longle2718/signpost/software/apps/tests/erpc_test/README.md

1) follow the build instructions in the erpc submodule
2) run 

$erpcgen test_arithmetic.erpc
