longle2718/signpost/case/backplane_assembly.SLDASM

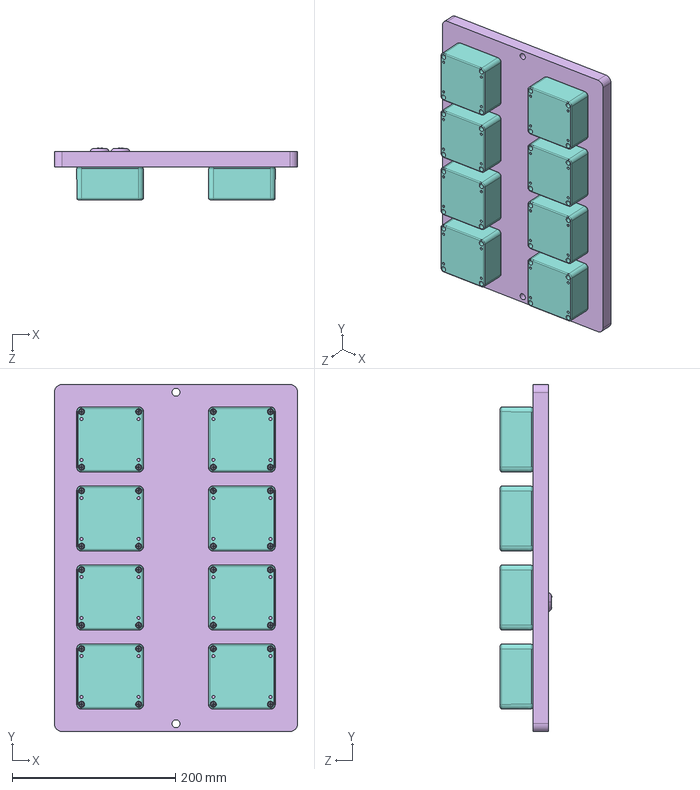
[picture p1: CAD file, 2017-03-07]
case/backplane_assembly.SLDASM
298.5 x 425.5 x 63.2 mm
back_panel
pcb
91772A107_18-8 SS PAN HEAD PHILLIPS MACHINE SCREW x 20
keystone_1892_0375_#4_standoff x 32
91772A106_18-8 SS PAN HEAD PHILLIPS MACHINE SCREW x 64
back_panel_cover
o_ring x 8
box_top x 8
96710A218_18-8 SS PAN HEAD TORX MACHINE SCREW x 32
91771A196_18-8 SS FLAT HEAD PHILLIPS MACHINE SCREW x 14
module_pcb x 8
back_panel_oring
C2058_QUILT_1 x 2
C2058_QUILT_2 x 2
