longle2718/signpost/case/back_panel_assem.SLDASM

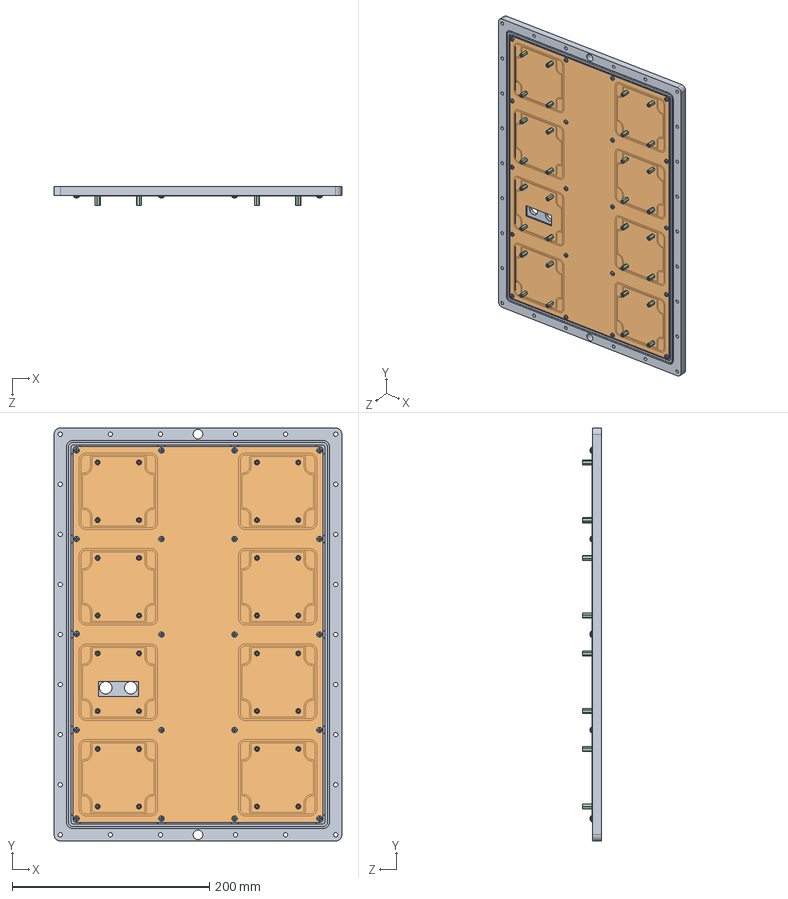
[picture p2: CAD file, 2017-03-07]
case/back_panel_assem.SLDASM
292.0 x 419.0 x 19.1 mm
back_panel
pcb
91772A107_18-8 SS PAN HEAD PHILLIPS MACHINE SCREW x 20
keystone_1892_0375_#4_standoff x 32
91772A106_18-8 SS PAN HEAD PHILLIPS MACHINE SCREW x 32
