longle2718/signpost/case/parts/back_panel.SLDPRT

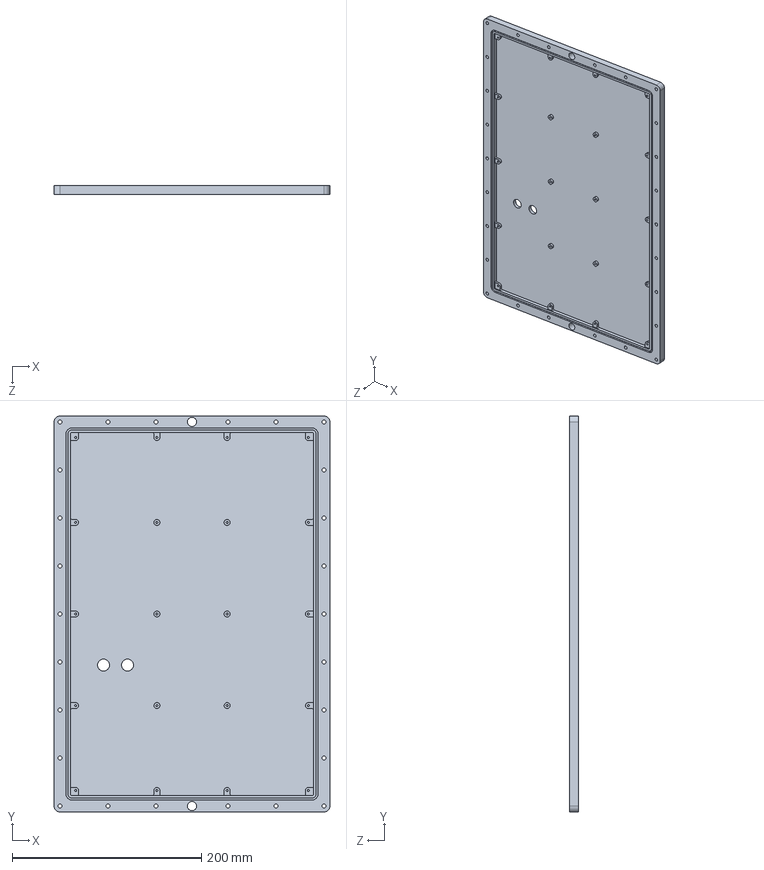
[picture p3: CAD file, 2017-03-07]
case/parts/back_panel.SLDPRT
292.0 x 419.0 x 9.14 mm
