longle2718/signpost/case/parts/back_panel_cover.SLDPRT

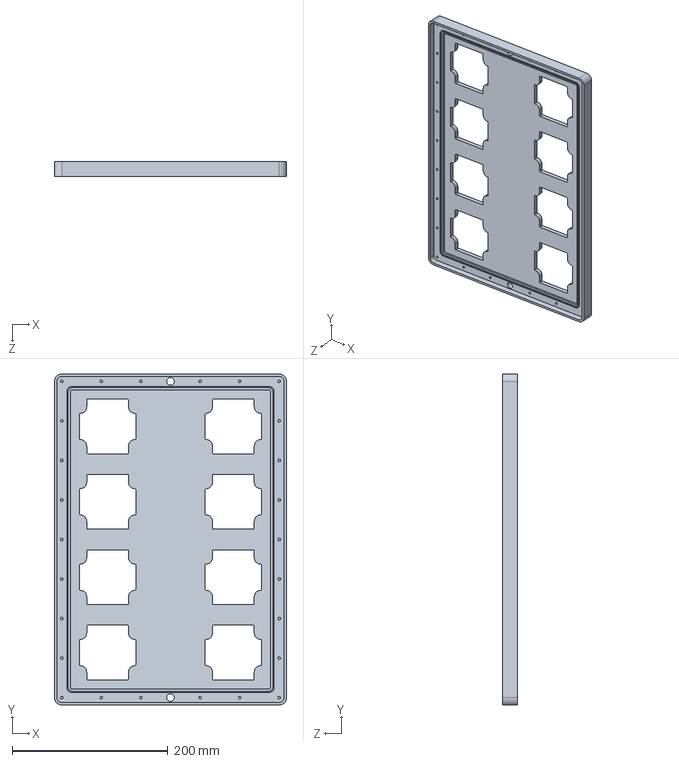
[picture p4: CAD file, 2017-03-07]
case/parts/back_panel_cover.SLDPRT
298.5 x 425.5 x 19.1 mm
