longle2718/signpost/case/parts/pcb.SLDPRT

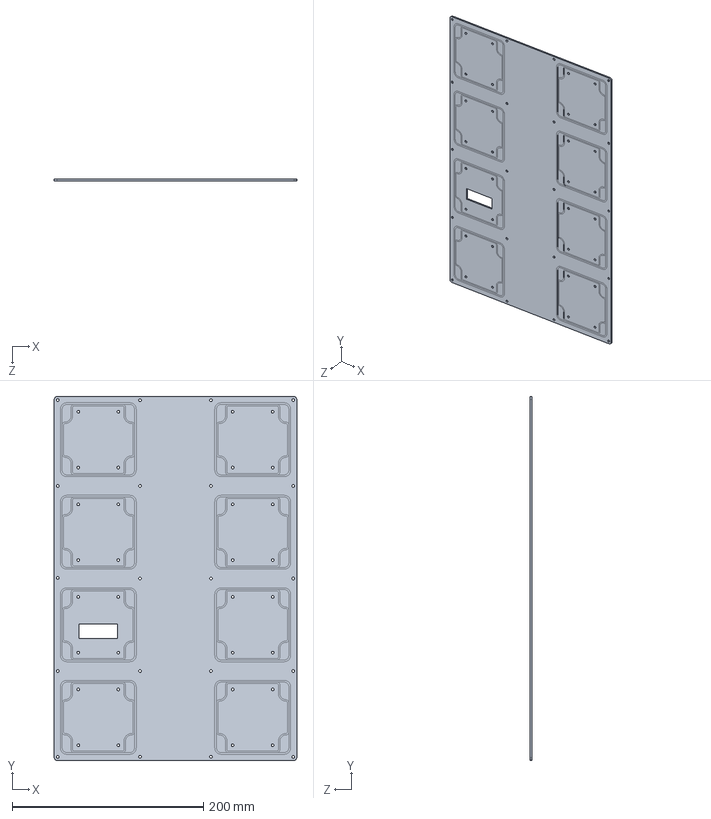
[picture p5: CAD file, 2017-03-07]
case/parts/pcb.SLDPRT
254.0 x 381.0 x 2.08 mm
