longle2718/signpost/hardware/backplane/rev_c/backplane.brd

## EAGLE design hardware/backplane/rev_c/backplane.brd (2017-03-07)

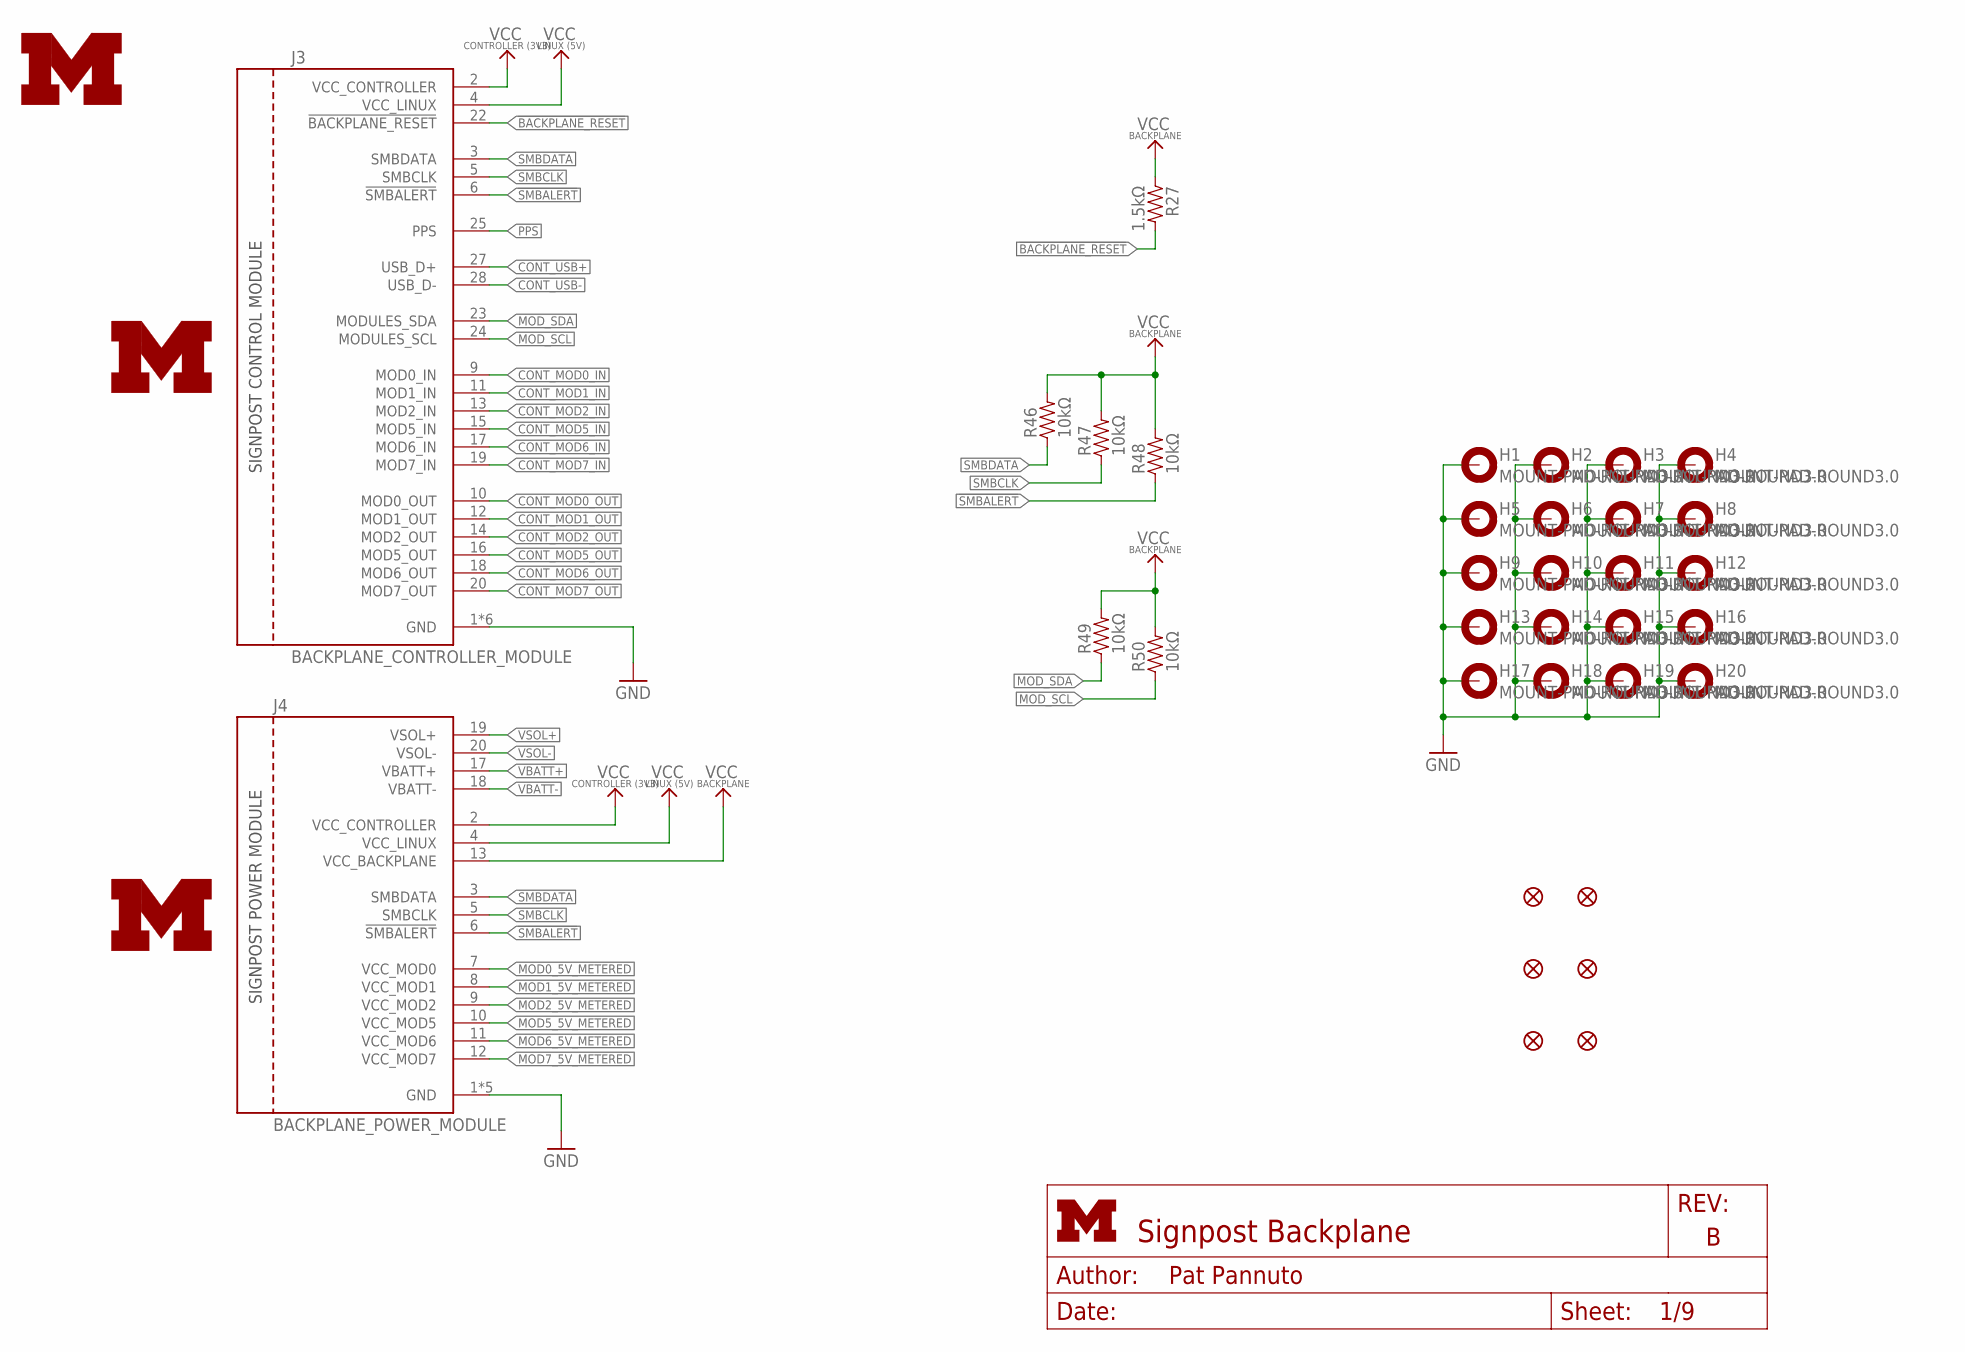
[picture p25: schematic backplane.sch, sheet 1]

Parts:
H1, H2, H3, H4, H5, H6, H7, H8, H9, H10, H11, H12, H13, H14, H15, H16, H17, H18, H19, H20: MOUNT-PAD-ROUND3.0; 3,0-PAD
J3: BACKPLANE_CONTROLLER_MODULE; BACKPLANE_MODULE_20PIN_10PIN
J4: BACKPLANE_POWER_MODULE; BACKPLANE_MODULE_20PIN
JP1, JP2, JP3, JP4, JP5, JP6: FIDUCIAL1X2; FIDUCIAL-1X2
LOGO1: UMICH_SOLID_GIANT; UMICH_SOLID_1000MIL
LOGO8, LOGO9: UMICH_SOLID_MEDIUM; UMICH_SOLID_200MIL
R27: 1.5kΩ; 0603-RES
R46, R47, R48, R49, R50: 10kΩ; 0603-RES

Connections:
!BACKPLANE_RESET: J3.22 (!BACKPLANE_RESET), R27.2; also elsewhere on the board
!SMBALERT: J3.6 (!SMBALERT), J4.6 (!SMBALERT), R48.1; also elsewhere on the board
CONT_MOD0_IN: J3.9 (MOD0_IN); also elsewhere on the board
CONT_MOD0_OUT: J3.10 (MOD0_OUT); also elsewhere on the board
CONT_MOD1_IN: J3.11 (MOD1_IN); also elsewhere on the board
CONT_MOD1_OUT: J3.12 (MOD1_OUT); also elsewhere on the board
CONT_MOD2_IN: J3.13 (MOD2_IN); also elsewhere on the board
CONT_MOD2_OUT: J3.14 (MOD2_OUT); also elsewhere on the board
CONT_MOD5_IN: J3.15 (MOD5_IN); also elsewhere on the board
CONT_MOD5_OUT: J3.16 (MOD5_OUT); also elsewhere on the board
CONT_MOD6_IN: J3.17 (MOD6_IN); also elsewhere on the board
CONT_MOD6_OUT: J3.18 (MOD6_OUT); also elsewhere on the board
CONT_MOD7_IN: J3.19 (MOD7_IN); also elsewhere on the board
CONT_MOD7_OUT: J3.20 (MOD7_OUT); also elsewhere on the board
CONT_USB+: J3.27 (USB_D+); also elsewhere on the board
CONT_USB-: J3.28 (USB_D-); also elsewhere on the board
GND: H1.B3,0, H2.B3,0, H3.B3,0, H4.B3,0, H5.B3,0, H6.B3,0, H7.B3,0, H8.B3,0, H9.B3,0, H10.B3,0, H11.B3,0, H12.B3,0, H13.B3,0, H14.B3,0, H15.B3,0, H16.B3,0, H17.B3,0, H18.B3,0, H19.B3,0, H20.B3,0, J3.1 (GND), J3.21 (GND), J3.MNT1 (GND), J3.MNT2 (GND), J3.MNT3 (GND), J3.MNT4 (GND), J4.1 (GND), J4.MNT1 (GND), J4.MNT2 (GND), J4.MNT3 (GND), J4.MNT4 (GND); also elsewhere on the board
MOD0_5V_METERED: J4.7 (VCC_MOD0); also elsewhere on the board
MOD1_5V_METERED: J4.8 (VCC_MOD1); also elsewhere on the board
MOD2_5V_METERED: J4.9 (VCC_MOD2); also elsewhere on the board
MOD5_5V_METERED: J4.10 (VCC_MOD5); also elsewhere on the board
MOD6_5V_METERED: J4.11 (VCC_MOD6); also elsewhere on the board
MOD7_5V_METERED: J4.12 (VCC_MOD7); also elsewhere on the board
MOD_SCL: J3.24 (MODULES_SCL), R50.1; also elsewhere on the board
MOD_SDA: J3.23 (MODULES_SDA), R49.1; also elsewhere on the board
PPS: J3.25 (PPS); also elsewhere on the board
SMBCLK: J3.5 (SMBCLK), J4.5 (SMBCLK), R47.1; also elsewhere on the board
SMBDATA: J3.3 (SMBDATA), J4.3 (SMBDATA), R46.1; also elsewhere on the board
VBATT+: J4.17 (VBATT+); also elsewhere on the board
VBATT-: J4.18 (VBATT-); also elsewhere on the board
VCC_BACKPLANE: J4.13 (VCC_BACKPLANE), R27.1, R46.2, R47.2, R48.2, R49.2, R50.2; also elsewhere on the board
VCC_CONTROLLER: J3.2 (VCC_CONTROLLER), J4.2 (VCC_CONTROLLER); also elsewhere on the board
VCC_LINUX: J3.4 (VCC_LINUX), J4.4 (VCC_LINUX); also elsewhere on the board
VSOL+: J4.19 (VSOL+); also elsewhere on the board
VSOL-: J4.20 (VSOL-); also elsewhere on the board

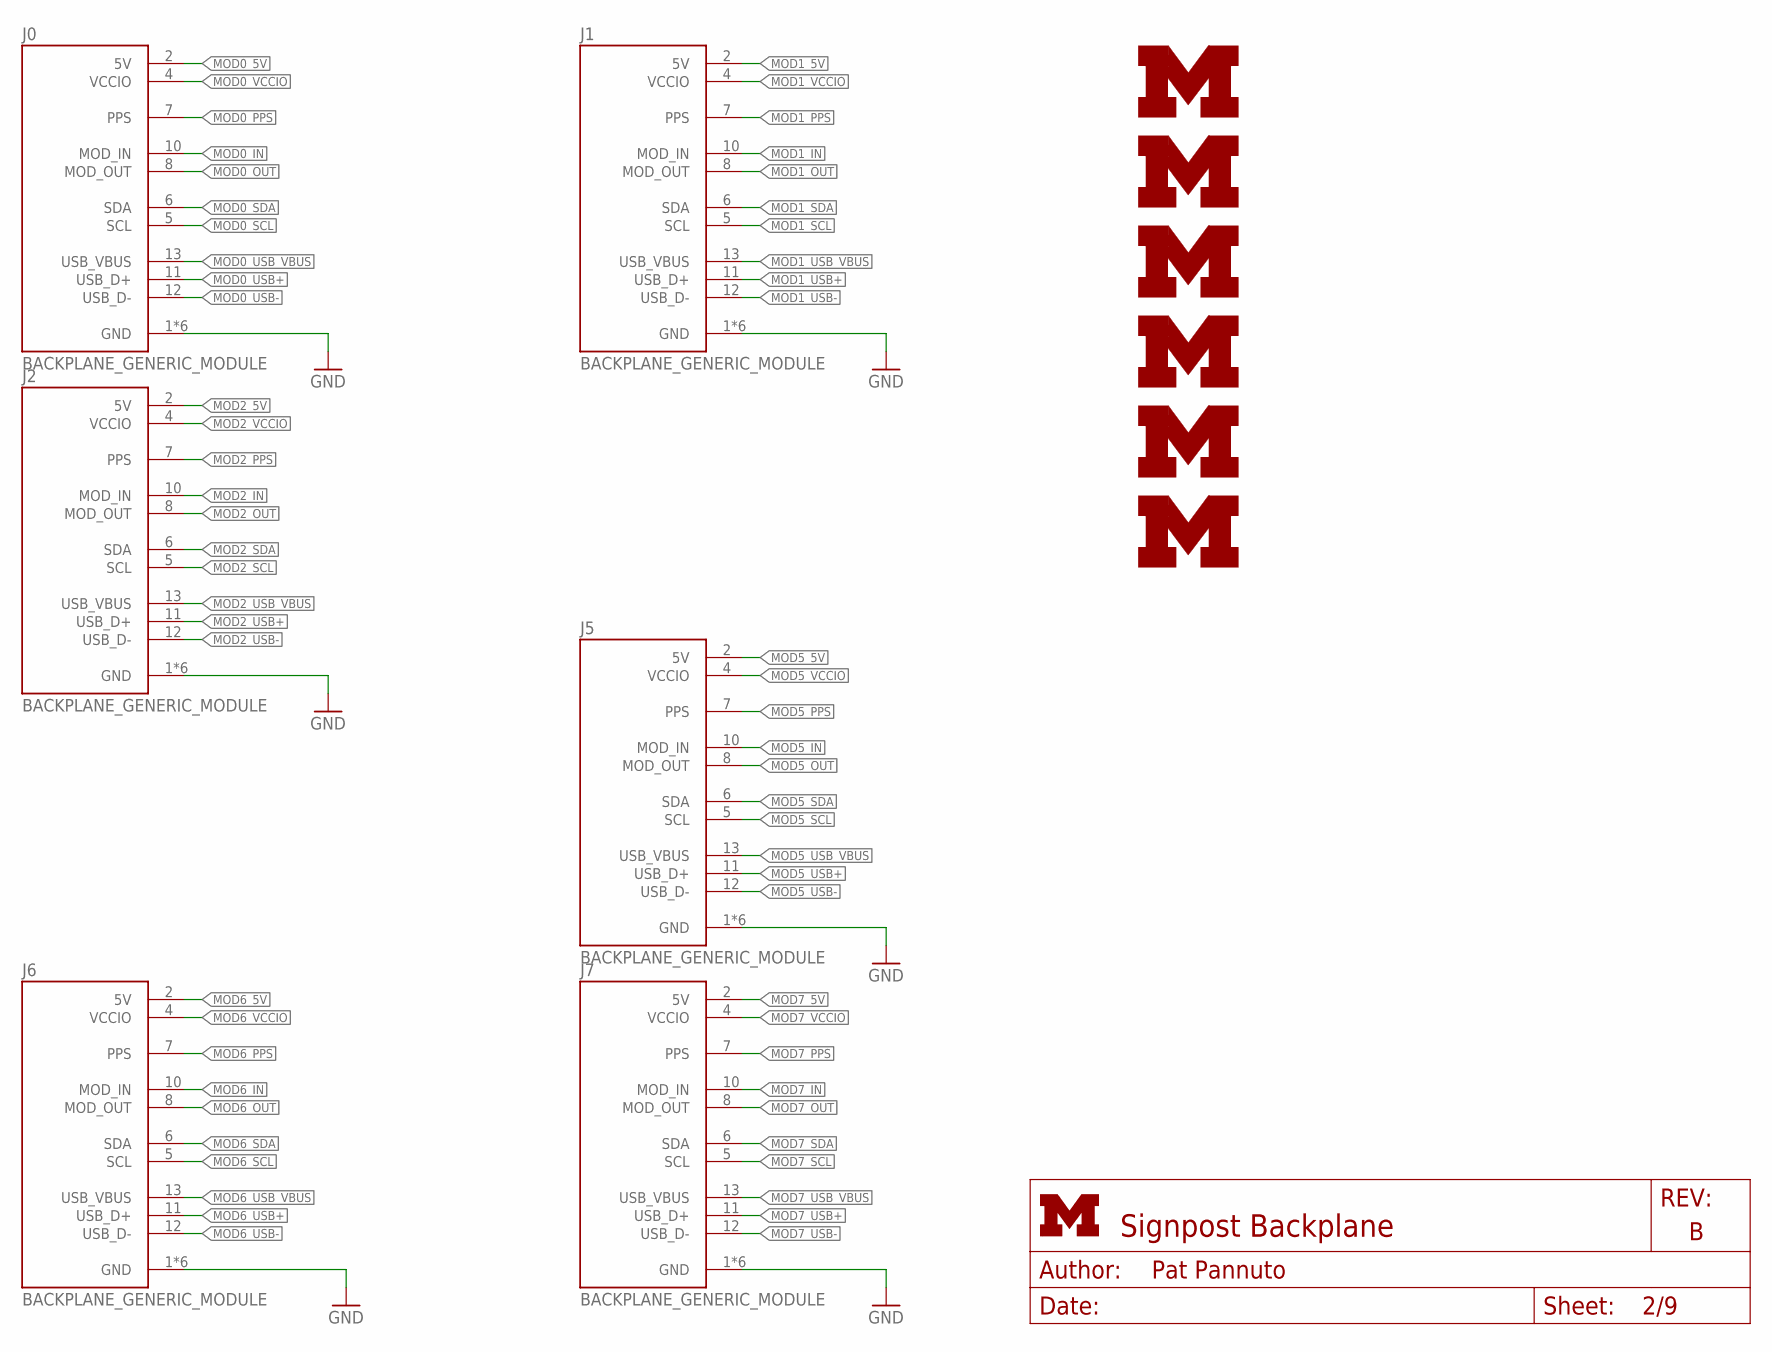
[picture p26: schematic backplane.sch, sheet 2]

Parts:
J0, J1, J2, J5, J6, J7: BACKPLANE_GENERIC_MODULE; BACKPLANE_MODULE_14PIN
LOGO2, LOGO3, LOGO4, LOGO5, LOGO6, LOGO7: UMICH_SOLID_MEDIUM; UMICH_SOLID_200MIL

Connections:
GND: J0.1 (GND), J0.14 (GND), J0.MNT1 (GND), J0.MNT2 (GND), J0.MNT3 (GND), J0.MNT4 (GND), J1.1 (GND), J1.14 (GND), J1.MNT1 (GND), J1.MNT2 (GND), J1.MNT3 (GND), J1.MNT4 (GND), J2.1 (GND), J2.14 (GND), J2.MNT1 (GND), J2.MNT2 (GND), J2.MNT3 (GND), J2.MNT4 (GND), J5.1 (GND), J5.14 (GND), J5.MNT1 (GND), J5.MNT2 (GND), J5.MNT3 (GND), J5.MNT4 (GND), J6.1 (GND), J6.14 (GND), J6.MNT1 (GND), J6.MNT2 (GND), J6.MNT3 (GND), J6.MNT4 (GND), J7.1 (GND), J7.14 (GND), J7.MNT1 (GND), J7.MNT2 (GND), J7.MNT3 (GND), J7.MNT4 (GND); also elsewhere on the board
MOD0_5V: J0.2 (5V); also elsewhere on the board
MOD0_IN: J0.10 (MOD_IN); also elsewhere on the board
MOD0_OUT: J0.8 (MOD_OUT); also elsewhere on the board
MOD0_PPS: J0.7 (PPS); also elsewhere on the board
MOD0_SCL: J0.5 (SCL); also elsewhere on the board
MOD0_SDA: J0.6 (SDA); also elsewhere on the board
MOD0_USB+: J0.11 (USB_D+); also elsewhere on the board
MOD0_USB-: J0.12 (USB_D-); also elsewhere on the board
MOD0_USB_VBUS: J0.13 (USB_VBUS); also elsewhere on the board
MOD0_VCCIO: J0.4 (VCCIO); also elsewhere on the board
MOD1_5V: J1.2 (5V); also elsewhere on the board
MOD1_IN: J1.10 (MOD_IN); also elsewhere on the board
MOD1_OUT: J1.8 (MOD_OUT); also elsewhere on the board
MOD1_PPS: J1.7 (PPS); also elsewhere on the board
MOD1_SCL: J1.5 (SCL); also elsewhere on the board
MOD1_SDA: J1.6 (SDA); also elsewhere on the board
MOD1_USB+: J1.11 (USB_D+); also elsewhere on the board
MOD1_USB-: J1.12 (USB_D-); also elsewhere on the board
MOD1_USB_VBUS: J1.13 (USB_VBUS); also elsewhere on the board
MOD1_VCCIO: J1.4 (VCCIO); also elsewhere on the board
MOD2_5V: J2.2 (5V); also elsewhere on the board
MOD2_IN: J2.10 (MOD_IN); also elsewhere on the board
MOD2_OUT: J2.8 (MOD_OUT); also elsewhere on the board
MOD2_PPS: J2.7 (PPS); also elsewhere on the board
MOD2_SCL: J2.5 (SCL); also elsewhere on the board
MOD2_SDA: J2.6 (SDA); also elsewhere on the board
MOD2_USB+: J2.11 (USB_D+); also elsewhere on the board
MOD2_USB-: J2.12 (USB_D-); also elsewhere on the board
MOD2_USB_VBUS: J2.13 (USB_VBUS); also elsewhere on the board
MOD2_VCCIO: J2.4 (VCCIO); also elsewhere on the board
MOD5_5V: J5.2 (5V); also elsewhere on the board
MOD5_IN: J5.10 (MOD_IN); also elsewhere on the board
MOD5_OUT: J5.8 (MOD_OUT); also elsewhere on the board
MOD5_PPS: J5.7 (PPS); also elsewhere on the board
MOD5_SCL: J5.5 (SCL); also elsewhere on the board
MOD5_SDA: J5.6 (SDA); also elsewhere on the board
MOD5_USB+: J5.11 (USB_D+); also elsewhere on the board
MOD5_USB-: J5.12 (USB_D-); also elsewhere on the board
MOD5_USB_VBUS: J5.13 (USB_VBUS); also elsewhere on the board
MOD5_VCCIO: J5.4 (VCCIO); also elsewhere on the board
MOD6_5V: J6.2 (5V); also elsewhere on the board
MOD6_IN: J6.10 (MOD_IN); also elsewhere on the board
MOD6_OUT: J6.8 (MOD_OUT); also elsewhere on the board
MOD6_PPS: J6.7 (PPS); also elsewhere on the board
MOD6_SCL: J6.5 (SCL); also elsewhere on the board
MOD6_SDA: J6.6 (SDA); also elsewhere on the board
MOD6_USB+: J6.11 (USB_D+); also elsewhere on the board
MOD6_USB-: J6.12 (USB_D-); also elsewhere on the board
MOD6_USB_VBUS: J6.13 (USB_VBUS); also elsewhere on the board
MOD6_VCCIO: J6.4 (VCCIO); also elsewhere on the board
MOD7_5V: J7.2 (5V); also elsewhere on the board
MOD7_IN: J7.10 (MOD_IN); also elsewhere on the board
MOD7_OUT: J7.8 (MOD_OUT); also elsewhere on the board
MOD7_PPS: J7.7 (PPS); also elsewhere on the board
MOD7_SCL: J7.5 (SCL); also elsewhere on the board
MOD7_SDA: J7.6 (SDA); also elsewhere on the board
MOD7_USB+: J7.11 (USB_D+); also elsewhere on the board
MOD7_USB-: J7.12 (USB_D-); also elsewhere on the board
MOD7_USB_VBUS: J7.13 (USB_VBUS); also elsewhere on the board
MOD7_VCCIO: J7.4 (VCCIO); also elsewhere on the board

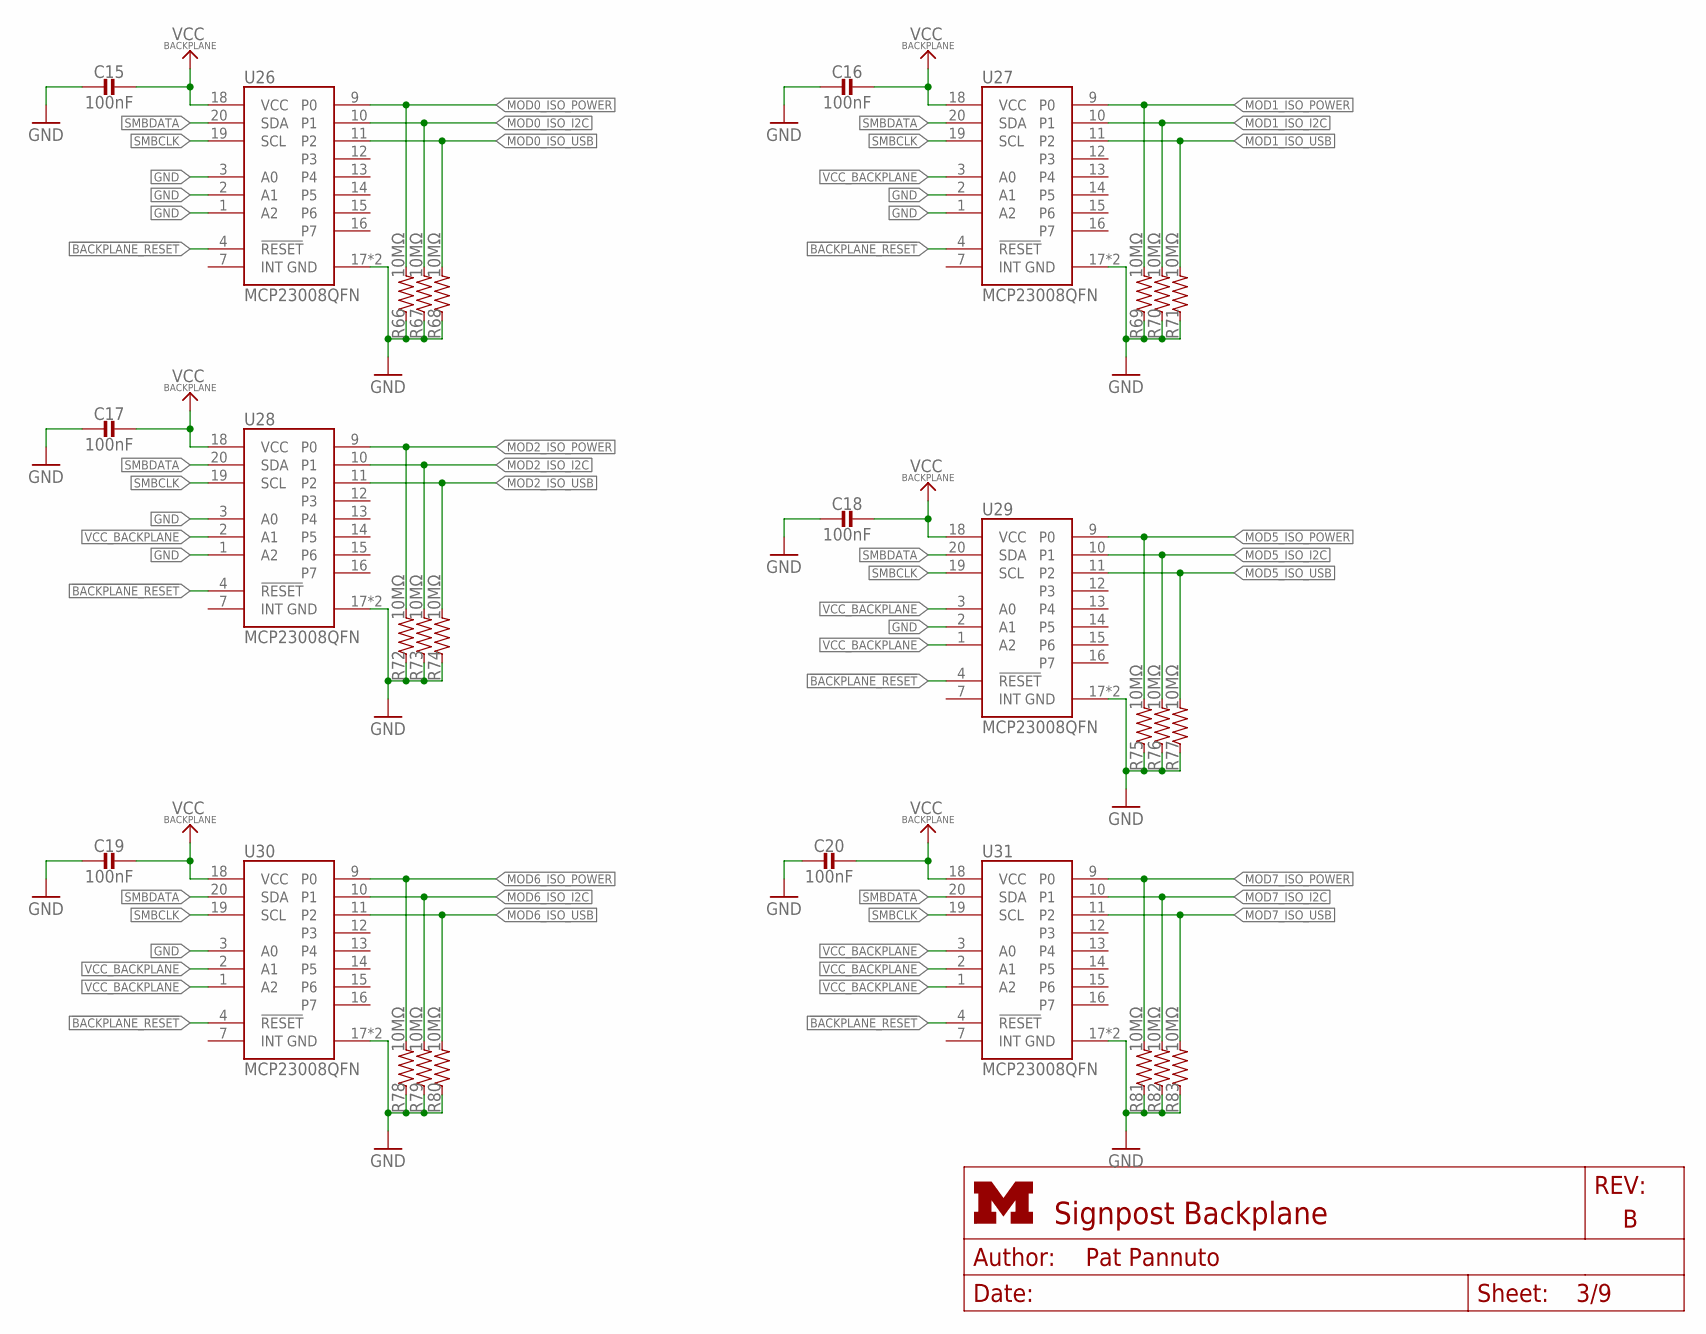
[picture p27: schematic backplane.sch, sheet 3]

Parts:
C15, C16, C17, C18, C19, C20: 100nF; 0603_CAP
R66, R67, R68, R69, R70, R71, R72, R73, R74, R75, R76, R77, R78, R79, R80, R81, R82, R83: 10MΩ; 0603-RES
U26, U27, U28, U29, U30, U31: MCP23008QFN; QFN-20-4MM

Connections:
!BACKPLANE_RESET: U26.4 (!RESET), U27.4 (!RESET), U28.4 (!RESET), U29.4 (!RESET), U30.4 (!RESET), U31.4 (!RESET); also elsewhere on the board
GND: C15.2, C16.2, C17.2, C18.2, C19.2, C20.2, R66.1, R67.1, R68.1, R69.1, R70.1, R71.1, R72.1, R73.1, R74.1, R75.1, R76.1, R77.1, R78.1, R79.1, R80.1, R81.1, R82.1, R83.1, U26.1 (A2), U26.2 (A1), U26.3 (A0), U26.17 (GND), U26.GND, U27.1 (A2), U27.2 (A1), U27.17 (GND), U27.GND, U28.1 (A2), U28.3 (A0), U28.17 (GND), U28.GND, U29.2 (A1), U29.17 (GND), U29.GND, U30.3 (A0), U30.17 (GND), U30.GND, U31.17 (GND), U31.GND; also elsewhere on the board
MOD0_ISO_I2C: R67.2, U26.10 (P1); also elsewhere on the board
MOD0_ISO_POWER: R66.2, U26.9 (P0); also elsewhere on the board
MOD0_ISO_USB: R68.2, U26.11 (P2); also elsewhere on the board
MOD1_ISO_I2C: R70.2, U27.10 (P1); also elsewhere on the board
MOD1_ISO_POWER: R69.2, U27.9 (P0); also elsewhere on the board
MOD1_ISO_USB: R71.2, U27.11 (P2); also elsewhere on the board
MOD2_ISO_I2C: R73.2, U28.10 (P1); also elsewhere on the board
MOD2_ISO_POWER: R72.2, U28.9 (P0); also elsewhere on the board
MOD2_ISO_USB: R74.2, U28.11 (P2); also elsewhere on the board
MOD5_ISO_I2C: R76.2, U29.10 (P1); also elsewhere on the board
MOD5_ISO_POWER: R75.2, U29.9 (P0); also elsewhere on the board
MOD5_ISO_USB: R77.2, U29.11 (P2); also elsewhere on the board
MOD6_ISO_I2C: R79.2, U30.10 (P1); also elsewhere on the board
MOD6_ISO_POWER: R78.2, U30.9 (P0); also elsewhere on the board
MOD6_ISO_USB: R80.2, U30.11 (P2); also elsewhere on the board
MOD7_ISO_I2C: R82.2, U31.10 (P1); also elsewhere on the board
MOD7_ISO_POWER: R81.2, U31.9 (P0); also elsewhere on the board
MOD7_ISO_USB: R83.2, U31.11 (P2); also elsewhere on the board
SMBCLK: U26.19 (SCL), U27.19 (SCL), U28.19 (SCL), U29.19 (SCL), U30.19 (SCL), U31.19 (SCL); also elsewhere on the board
SMBDATA: U26.20 (SDA), U27.20 (SDA), U28.20 (SDA), U29.20 (SDA), U30.20 (SDA), U31.20 (SDA); also elsewhere on the board
VCC_BACKPLANE: C15.1, C16.1, C17.1, C18.1, C19.1, C20.1, U26.18 (VCC), U27.3 (A0), U27.18 (VCC), U28.2 (A1), U28.18 (VCC), U29.1 (A2), U29.3 (A0), U29.18 (VCC), U30.1 (A2), U30.2 (A1), U30.18 (VCC), U31.1 (A2), U31.2 (A1), U31.3 (A0), U31.18 (VCC); also elsewhere on the board

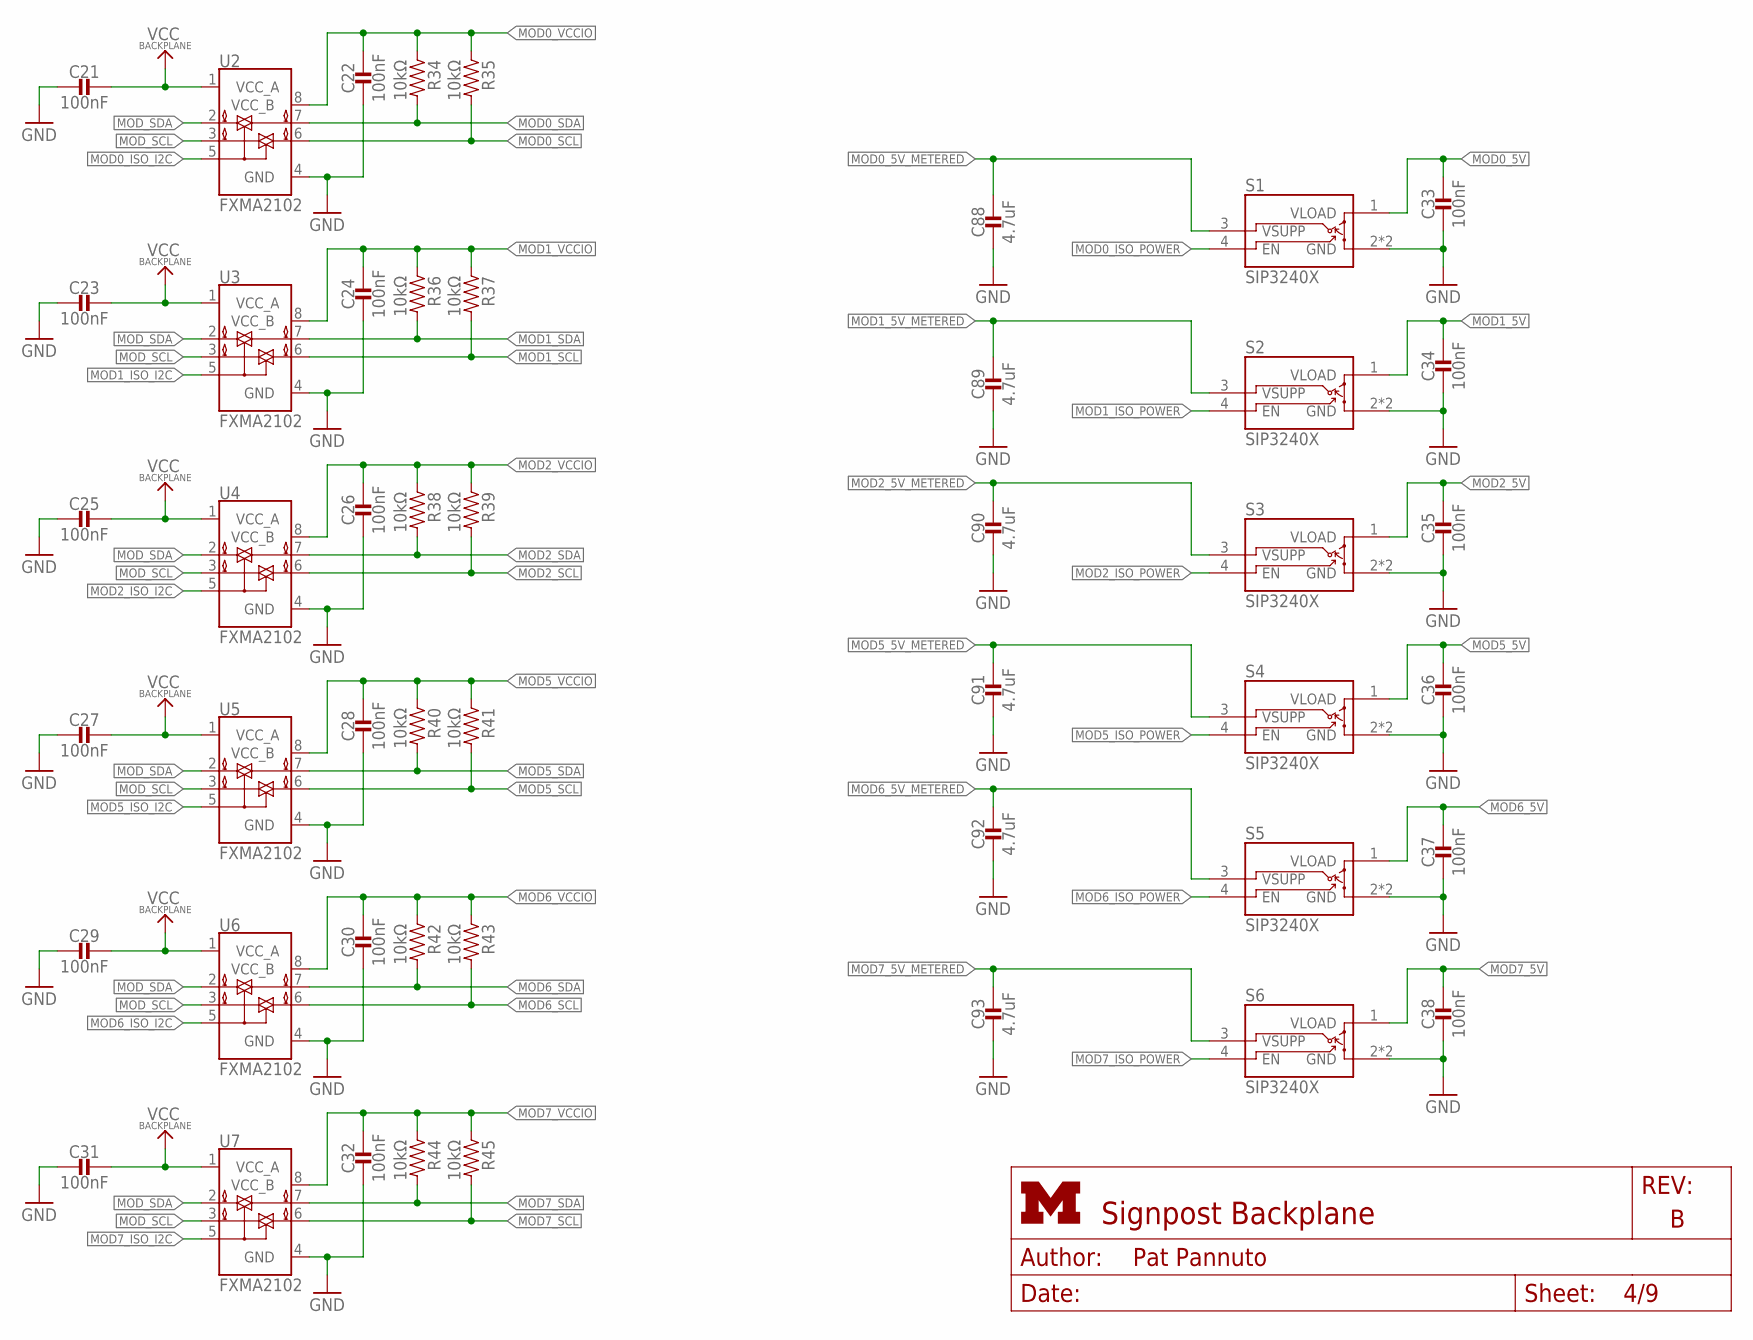
[picture p28: schematic backplane.sch, sheet 4]

Parts:
C21, C22, C23, C24, C25, C26, C27, C28, C29, C30, C31, C32, C33, C34, C35, C36, C37, C38: 100nF; 0603_CAP
C88, C89, C90, C91, C92, C93: 4.7uF; 0603_CAP
R34, R35, R36, R37, R38, R39, R40, R41, R42, R43, R44, R45: 10kΩ; 0603-RES
S1, S2, S3, S4, S5, S6: SIP3240X; TDFN4
U2, U3, U4, U5, U6, U7: FXMA2102; UMLP-8

Connections:
GND: C21.2, C22.2, C23.2, C24.2, C25.2, C26.2, C27.2, C28.2, C29.2, C30.2, C31.2, C32.2, C33.2, C34.2, C35.2, C36.2, C37.2, C38.2, C88.2, C89.2, C90.2, C91.2, C92.2, C93.2, S1.2 (GND), S1.PAD (GND), S2.2 (GND), S2.PAD (GND), S3.2 (GND), S3.PAD (GND), S4.2 (GND), S4.PAD (GND), S5.2 (GND), S5.PAD (GND), S6.2 (GND), S6.PAD (GND), U2.4 (GND), U3.4 (GND), U4.4 (GND), U5.4 (GND), U6.4 (GND), U7.4 (GND); also elsewhere on the board
MOD0_5V: C33.1, S1.1 (VLOAD); also elsewhere on the board
MOD0_5V_METERED: C88.1, S1.3 (VSUPP); also elsewhere on the board
MOD0_ISO_I2C: U2.5 (OE); also elsewhere on the board
MOD0_ISO_POWER: S1.4 (EN); also elsewhere on the board
MOD0_SCL: R35.2, U2.6 (B1); also elsewhere on the board
MOD0_SDA: R34.2, U2.7 (B0); also elsewhere on the board
MOD0_VCCIO: C22.1, R34.1, R35.1, U2.8 (VCC_B); also elsewhere on the board
MOD1_5V: C34.1, S2.1 (VLOAD); also elsewhere on the board
MOD1_5V_METERED: C89.1, S2.3 (VSUPP); also elsewhere on the board
MOD1_ISO_I2C: U3.5 (OE); also elsewhere on the board
MOD1_ISO_POWER: S2.4 (EN); also elsewhere on the board
MOD1_SCL: R37.2, U3.6 (B1); also elsewhere on the board
MOD1_SDA: R36.2, U3.7 (B0); also elsewhere on the board
MOD1_VCCIO: C24.1, R36.1, R37.1, U3.8 (VCC_B); also elsewhere on the board
MOD2_5V: C35.1, S3.1 (VLOAD); also elsewhere on the board
MOD2_5V_METERED: C90.1, S3.3 (VSUPP); also elsewhere on the board
MOD2_ISO_I2C: U4.5 (OE); also elsewhere on the board
MOD2_ISO_POWER: S3.4 (EN); also elsewhere on the board
MOD2_SCL: R39.2, U4.6 (B1); also elsewhere on the board
MOD2_SDA: R38.2, U4.7 (B0); also elsewhere on the board
MOD2_VCCIO: C26.1, R38.1, R39.1, U4.8 (VCC_B); also elsewhere on the board
MOD5_5V: C36.1, S4.1 (VLOAD); also elsewhere on the board
MOD5_5V_METERED: C91.1, S4.3 (VSUPP); also elsewhere on the board
MOD5_ISO_I2C: U5.5 (OE); also elsewhere on the board
MOD5_ISO_POWER: S4.4 (EN); also elsewhere on the board
MOD5_SCL: R41.2, U5.6 (B1); also elsewhere on the board
MOD5_SDA: R40.2, U5.7 (B0); also elsewhere on the board
MOD5_VCCIO: C28.1, R40.1, R41.1, U5.8 (VCC_B); also elsewhere on the board
MOD6_5V: C37.1, S5.1 (VLOAD); also elsewhere on the board
MOD6_5V_METERED: C92.1, S5.3 (VSUPP); also elsewhere on the board
MOD6_ISO_I2C: U6.5 (OE); also elsewhere on the board
MOD6_ISO_POWER: S5.4 (EN); also elsewhere on the board
MOD6_SCL: R43.2, U6.6 (B1); also elsewhere on the board
MOD6_SDA: R42.2, U6.7 (B0); also elsewhere on the board
MOD6_VCCIO: C30.1, R42.1, R43.1, U6.8 (VCC_B); also elsewhere on the board
MOD7_5V: C38.1, S6.1 (VLOAD); also elsewhere on the board
MOD7_5V_METERED: C93.1, S6.3 (VSUPP); also elsewhere on the board
MOD7_ISO_I2C: U7.5 (OE); also elsewhere on the board
MOD7_ISO_POWER: S6.4 (EN); also elsewhere on the board
MOD7_SCL: R45.2, U7.6 (B1); also elsewhere on the board
MOD7_SDA: R44.2, U7.7 (B0); also elsewhere on the board
MOD7_VCCIO: C32.1, R44.1, R45.1, U7.8 (VCC_B); also elsewhere on the board
MOD_SCL: U2.3 (A1), U3.3 (A1), U4.3 (A1), U5.3 (A1), U6.3 (A1), U7.3 (A1); also elsewhere on the board
MOD_SDA: U2.2 (A0), U3.2 (A0), U4.2 (A0), U5.2 (A0), U6.2 (A0), U7.2 (A0); also elsewhere on the board
VCC_BACKPLANE: C21.1, C23.1, C25.1, C27.1, C29.1, C31.1, U2.1 (VCC_A), U3.1 (VCC_A), U4.1 (VCC_A), U5.1 (VCC_A), U6.1 (VCC_A), U7.1 (VCC_A); also elsewhere on the board

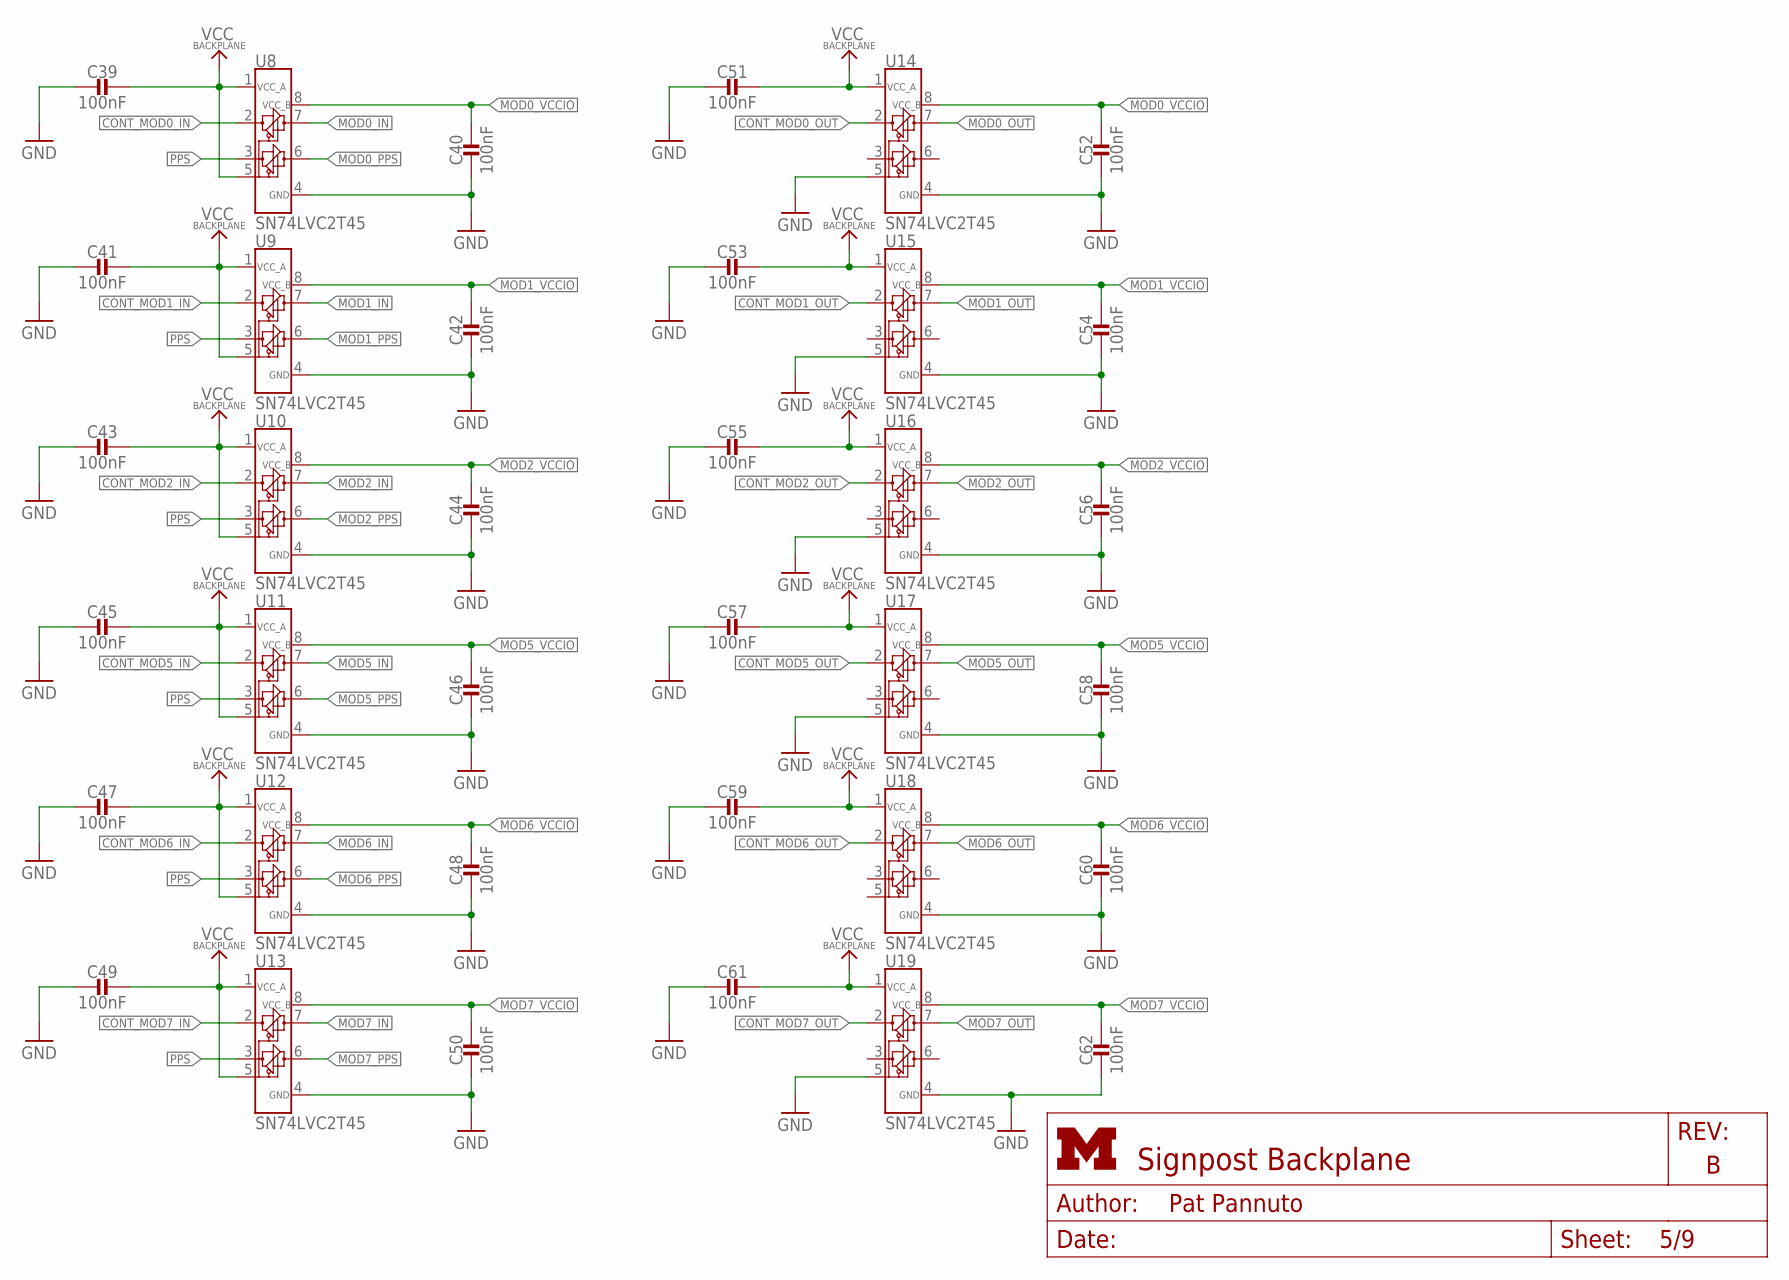
[picture p29: schematic backplane.sch, sheet 5]

Parts:
C39, C40, C41, C42, C43, C44, C45, C46, C47, C48, C49, C50, C51, C52, C53, C54, C55, C56, C57, C58, C59, C60, C61, C62: 100nF; 0603_CAP
U8, U9, U10, U11, U12, U13, U14, U15, U16, U17, U18, U19: SN74LVC2T45; VFSOP-8

Connections:
CONT_MOD0_IN: U8.2 (A1); also elsewhere on the board
CONT_MOD0_OUT: U14.2 (A1); also elsewhere on the board
CONT_MOD1_IN: U9.2 (A1); also elsewhere on the board
CONT_MOD1_OUT: U15.2 (A1); also elsewhere on the board
CONT_MOD2_IN: U10.2 (A1); also elsewhere on the board
CONT_MOD2_OUT: U16.2 (A1); also elsewhere on the board
CONT_MOD5_IN: U11.2 (A1); also elsewhere on the board
CONT_MOD5_OUT: U17.2 (A1); also elsewhere on the board
CONT_MOD6_IN: U12.2 (A1); also elsewhere on the board
CONT_MOD6_OUT: U18.2 (A1); also elsewhere on the board
CONT_MOD7_IN: U13.2 (A1); also elsewhere on the board
CONT_MOD7_OUT: U19.2 (A1); also elsewhere on the board
GND: C39.2, C40.2, C41.2, C42.2, C43.2, C44.2, C45.2, C46.2, C47.2, C48.2, C49.2, C50.2, C51.2, C52.2, C53.2, C54.2, C55.2, C56.2, C57.2, C58.2, C59.2, C60.2, C61.2, C62.2, U8.4 (GND), U9.4 (GND), U10.4 (GND), U11.4 (GND), U12.4 (GND), U13.4 (GND), U14.4 (GND), U14.5 (DIR), U15.4 (GND), U15.5 (DIR), U16.4 (GND), U16.5 (DIR), U17.4 (GND), U17.5 (DIR), U18.4 (GND), U19.4 (GND), U19.5 (DIR); also elsewhere on the board
MOD0_IN: U8.7 (B1); also elsewhere on the board
MOD0_OUT: U14.7 (B1); also elsewhere on the board
MOD0_PPS: U8.6 (B2); also elsewhere on the board
MOD0_VCCIO: C40.1, C52.1, U8.8 (VCC_B), U14.8 (VCC_B); also elsewhere on the board
MOD1_IN: U9.7 (B1); also elsewhere on the board
MOD1_OUT: U15.7 (B1); also elsewhere on the board
MOD1_PPS: U9.6 (B2); also elsewhere on the board
MOD1_VCCIO: C42.1, C54.1, U9.8 (VCC_B), U15.8 (VCC_B); also elsewhere on the board
MOD2_IN: U10.7 (B1); also elsewhere on the board
MOD2_OUT: U16.7 (B1); also elsewhere on the board
MOD2_PPS: U10.6 (B2); also elsewhere on the board
MOD2_VCCIO: C44.1, C56.1, U10.8 (VCC_B), U16.8 (VCC_B); also elsewhere on the board
MOD5_IN: U11.7 (B1); also elsewhere on the board
MOD5_OUT: U17.7 (B1); also elsewhere on the board
MOD5_PPS: U11.6 (B2); also elsewhere on the board
MOD5_VCCIO: C46.1, C58.1, U11.8 (VCC_B), U17.8 (VCC_B); also elsewhere on the board
MOD6_IN: U12.7 (B1); also elsewhere on the board
MOD6_OUT: U18.7 (B1); also elsewhere on the board
MOD6_PPS: U12.6 (B2); also elsewhere on the board
MOD6_VCCIO: C48.1, C60.1, U12.8 (VCC_B), U18.8 (VCC_B); also elsewhere on the board
MOD7_IN: U13.7 (B1); also elsewhere on the board
MOD7_OUT: U19.7 (B1); also elsewhere on the board
MOD7_PPS: U13.6 (B2); also elsewhere on the board
MOD7_VCCIO: C50.1, C62.1, U13.8 (VCC_B), U19.8 (VCC_B); also elsewhere on the board
PPS: U8.3 (A2), U9.3 (A2), U10.3 (A2), U11.3 (A2), U12.3 (A2), U13.3 (A2); also elsewhere on the board
VCC_BACKPLANE: C39.1, C41.1, C43.1, C45.1, C47.1, C49.1, C51.1, C53.1, C55.1, C57.1, C59.1, C61.1, U8.1 (VCC_A), U8.5 (DIR), U9.1 (VCC_A), U9.5 (DIR), U10.1 (VCC_A), U10.5 (DIR), U11.1 (VCC_A), U11.5 (DIR), U12.1 (VCC_A), U12.5 (DIR), U13.1 (VCC_A), U13.5 (DIR), U14.1 (VCC_A), U15.1 (VCC_A), U16.1 (VCC_A), U17.1 (VCC_A), U18.1 (VCC_A), U19.1 (VCC_A); also elsewhere on the board
