longle2718/signpost/hardware/backplane/rev_c/backplane.brd

## EAGLE design hardware/backplane/rev_c/backplane.brd (continued)

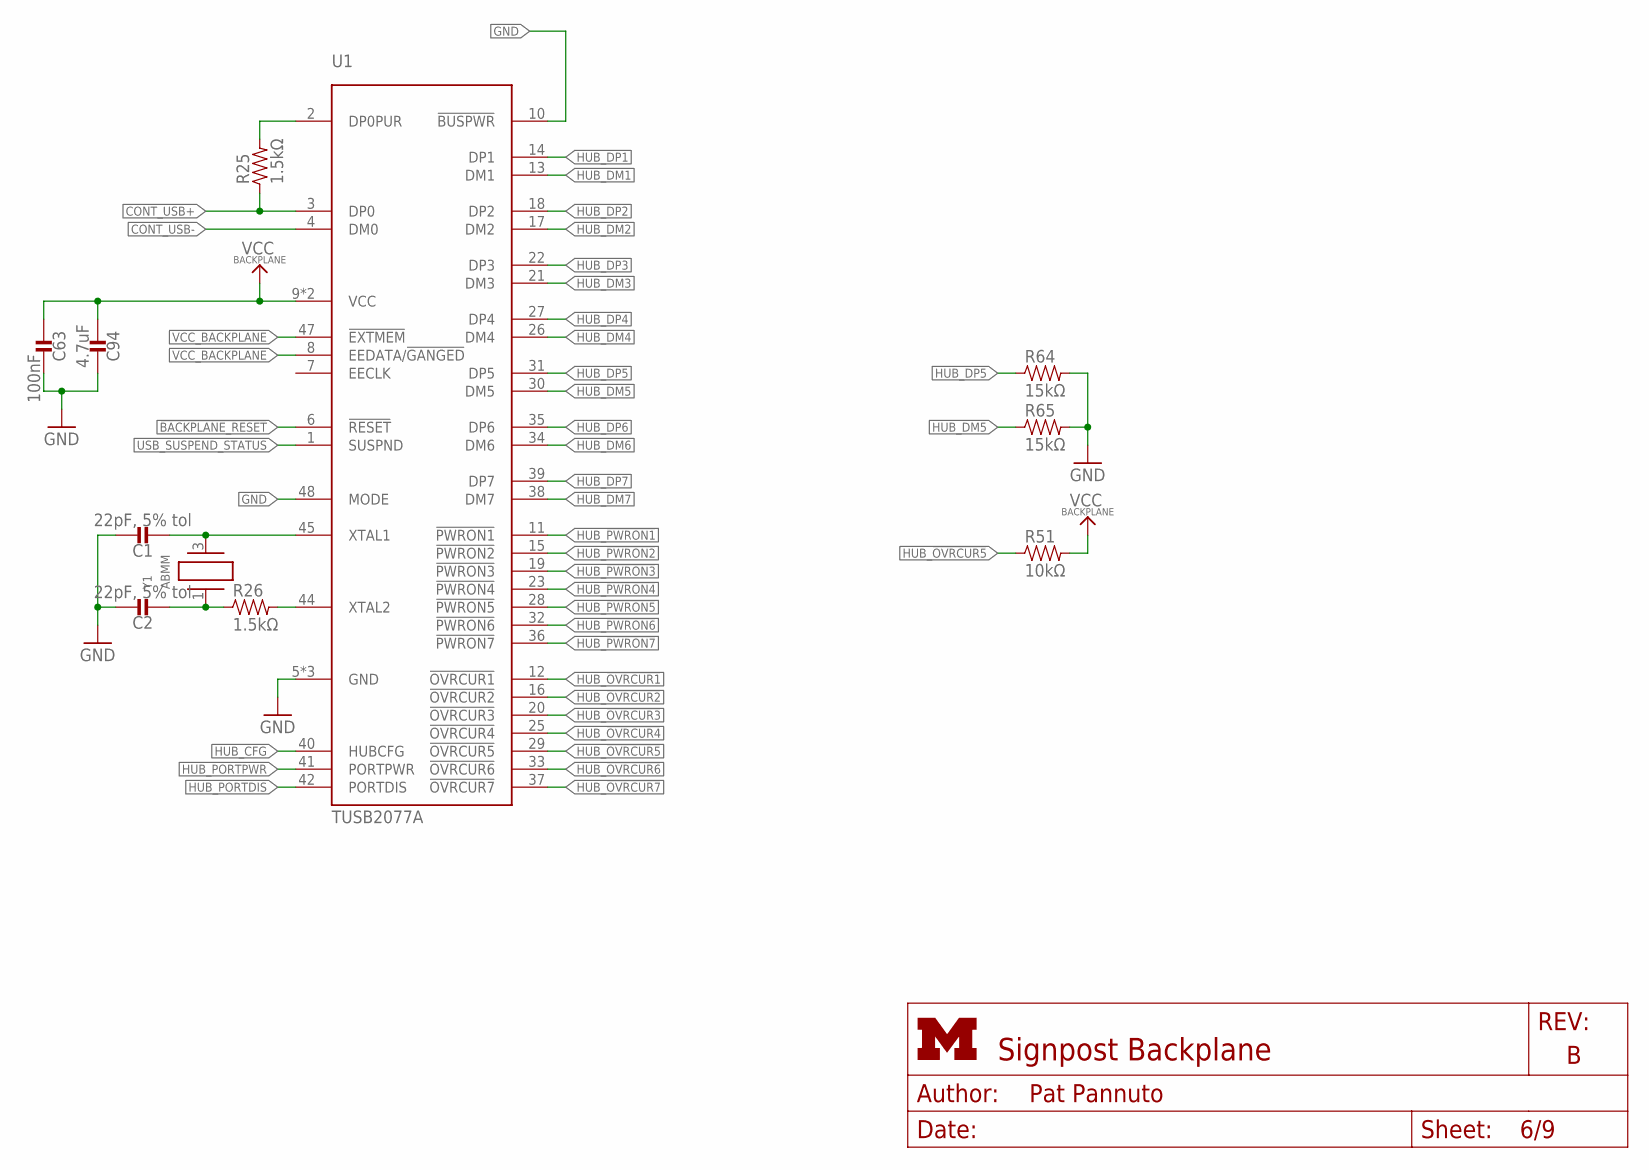
[picture p30: schematic backplane.sch, sheet 6]

Parts:
C1, C2: 22pF, 5% tol; 0603_CAP; DIGIKEY 1276-1023-1-ND
C63: 100nF; 0603_CAP
C94: 4.7uF; 0603_CAP
R25, R26: 1.5kΩ; 0603-RES
R51: 10kΩ; 0603-RES
R64, R65: 15kΩ; 0603-RES
U1: TUSB2077A; LQFP-48
Y1: ABMM

Connections:
!BACKPLANE_RESET: U1.6 (!RESET); also elsewhere on the board
CONT_USB+: R25.1, U1.3 (DP0); also elsewhere on the board
CONT_USB-: U1.4 (DM0); also elsewhere on the board
GND: C1.1, C2.1, C63.1, C94.1, R64.2, R65.2, U1.5 (GND), U1.10 (!BUSPWR), U1.24 (GND), U1.43 (GND), U1.48 (MODE); also elsewhere on the board
HUB_!OVRCUR1: U1.12 (!OVRCUR1); also elsewhere on the board
HUB_!OVRCUR2: U1.16 (!OVRCUR2); also elsewhere on the board
HUB_!OVRCUR3: U1.20 (!OVRCUR3); also elsewhere on the board
HUB_!OVRCUR4: U1.25 (!OVRCUR4); also elsewhere on the board
HUB_!OVRCUR5: R51.1, U1.29 (!OVRCUR5)
HUB_!OVRCUR6: U1.33 (!OVRCUR6); also elsewhere on the board
HUB_!OVRCUR7: U1.37 (!OVRCUR7); also elsewhere on the board
HUB_!PWRON1: U1.11 (!PWRON1); also elsewhere on the board
HUB_!PWRON2: U1.15 (!PWRON2); also elsewhere on the board
HUB_!PWRON3: U1.19 (!PWRON3); also elsewhere on the board
HUB_!PWRON4: U1.23 (!PWRON4); also elsewhere on the board
HUB_!PWRON5: U1.28 (!PWRON5)
HUB_!PWRON6: U1.32 (!PWRON6); also elsewhere on the board
HUB_!PWRON7: U1.36 (!PWRON7); also elsewhere on the board
HUB_CFG: U1.40 (HUBCFG); also elsewhere on the board
HUB_DM1: U1.13 (DM1); also elsewhere on the board
HUB_DM2: U1.17 (DM2); also elsewhere on the board
HUB_DM3: U1.21 (DM3); also elsewhere on the board
HUB_DM4: U1.26 (DM4); also elsewhere on the board
HUB_DM5: R65.1, U1.30 (DM5)
HUB_DM6: U1.34 (DM6); also elsewhere on the board
HUB_DM7: U1.38 (DM7); also elsewhere on the board
HUB_DP1: U1.14 (DP1); also elsewhere on the board
HUB_DP2: U1.18 (DP2); also elsewhere on the board
HUB_DP3: U1.22 (DP3); also elsewhere on the board
HUB_DP4: U1.27 (DP4); also elsewhere on the board
HUB_DP5: R64.1, U1.31 (DP5)
HUB_DP6: U1.35 (DP6); also elsewhere on the board
HUB_DP7: U1.39 (DP7); also elsewhere on the board
HUB_PORTDIS: U1.42 (PORTDIS); also elsewhere on the board
HUB_PORTPWR: U1.41 (PORTPWR); also elsewhere on the board
unnamed: R25.2, U1.2 (DP0PUR)
unnamed: C2.2, R26.1, Y1.1
unnamed: C1.2, U1.45 (XTAL1), Y1.3 (2)
unnamed: R26.2, U1.44 (XTAL2)
USB_SUSPEND_STATUS: U1.1 (SUSPND); also elsewhere on the board
VCC_BACKPLANE: C63.2, C94.2, R51.2, U1.8 (EEDATA/!GANGED), U1.9 (VCC), U1.46 (VCC), U1.47 (!EXTMEM); also elsewhere on the board

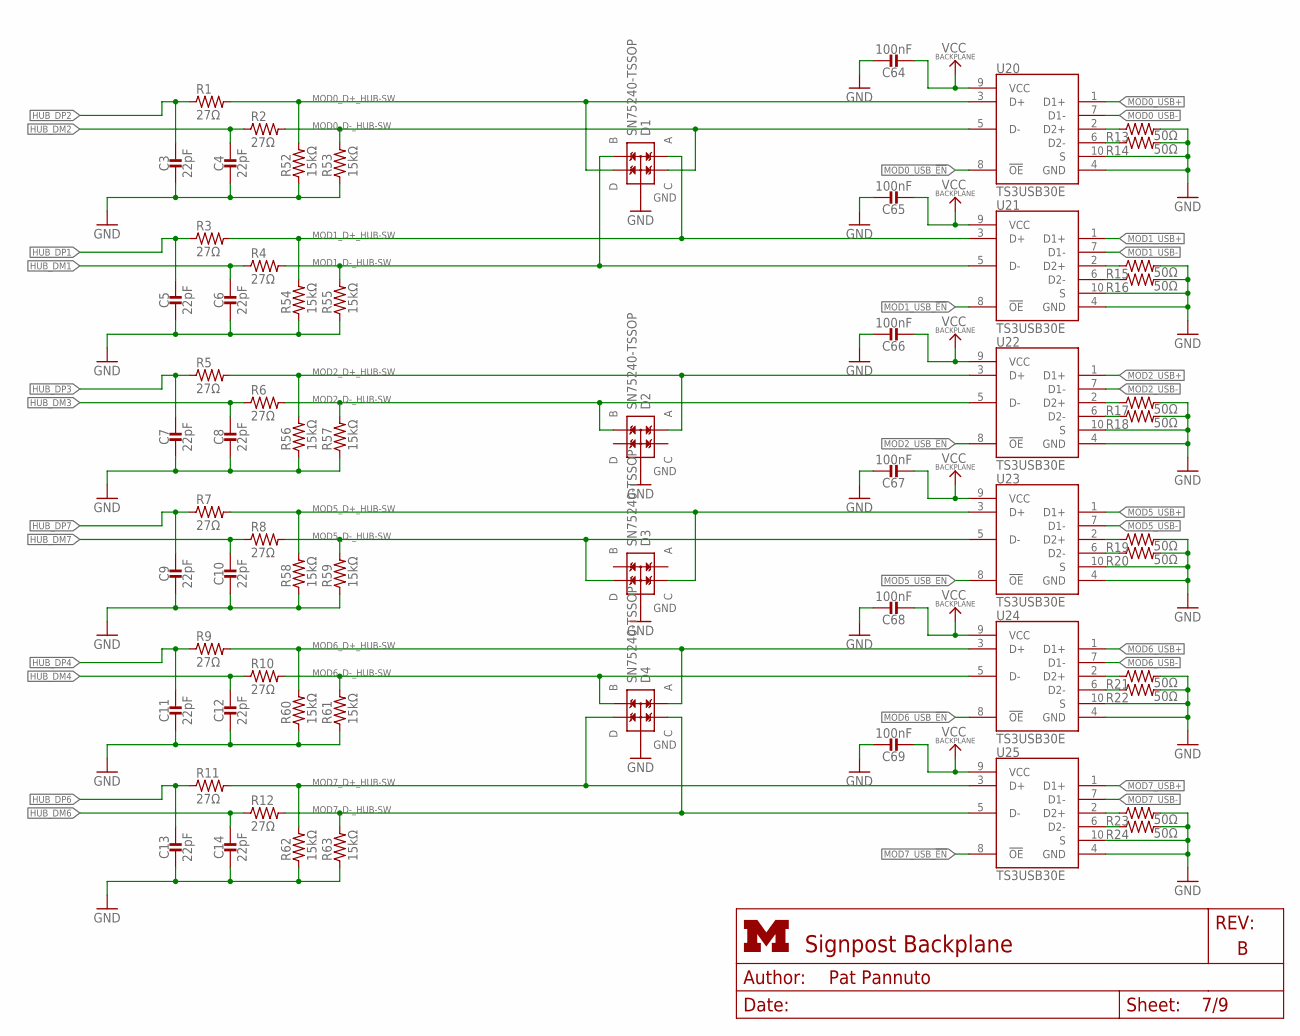
[picture p31: schematic backplane.sch, sheet 7]

Parts:
C3, C4, C5, C6, C7, C8, C9, C10, C11, C12, C13, C14: 22pF; 0402_CAP
C64, C65, C66, C67, C68, C69: 100nF; 0603_CAP
D1, D2, D3, D4: SN75240-TSSOP; TSSOP-8
R1, R2, R3, R4, R5, R6, R7, R8, R9, R10, R11, R12: 27Ω; 0402_RES-HIGH_SPEED
R13, R14, R15, R16, R17, R18, R19, R20, R21, R22, R23, R24: 50Ω; 0603-RES
R52, R53, R54, R55, R56, R57, R58, R59, R60, R61, R62, R63: 15kΩ; 0603-RES
U20, U21, U22, U23, U24, U25: TS3USB30E; UQFN-10

Connections:
GND: C3.2, C4.2, C5.2, C6.2, C7.2, C8.2, C9.2, C10.2, C11.2, C12.2, C13.2, C14.2, C64.1, C65.1, C66.1, C67.1, C68.1, C69.1, D1.1 (GND), D1.3 (GND), D1.5 (GND), D1.7 (GND), D2.1 (GND), D2.3 (GND), D2.5 (GND), D2.7 (GND), D3.1 (GND), D3.3 (GND), D3.5 (GND), D3.7 (GND), D4.1 (GND), D4.3 (GND), D4.5 (GND), D4.7 (GND), R13.2, R14.2, R15.2, R16.2, R17.2, R18.2, R19.2, R20.2, R21.2, R22.2, R23.2, R24.2, R52.1, R53.1, R54.1, R55.1, R56.1, R57.1, R58.1, R59.1, R60.1, R61.1, R62.1, R63.1, U20.4 (GND), U20.10 (S), U21.4 (GND), U21.10 (S), U22.4 (GND), U22.10 (S), U23.4 (GND), U23.10 (S), U24.4 (GND), U24.10 (S), U25.4 (GND), U25.10 (S); also elsewhere on the board
HUB_DM1: C6.1, R4.1; also elsewhere on the board
HUB_DM2: C4.1, R2.1; also elsewhere on the board
HUB_DM3: C8.1, R6.1; also elsewhere on the board
HUB_DM4: C12.1, R10.1; also elsewhere on the board
HUB_DM6: C14.1, R12.1; also elsewhere on the board
HUB_DM7: C10.1, R8.1; also elsewhere on the board
HUB_DP1: C5.1, R3.1; also elsewhere on the board
HUB_DP2: C3.1, R1.1; also elsewhere on the board
HUB_DP3: C7.1, R5.1; also elsewhere on the board
HUB_DP4: C11.1, R9.1; also elsewhere on the board
HUB_DP6: C13.1, R11.1; also elsewhere on the board
HUB_DP7: C9.1, R7.1; also elsewhere on the board
MOD0_D+_HUB-SW: D1.4 (D), R1.2, R52.2, U20.3 (D+)
MOD0_D-_HUB-SW: D1.2 (C), R2.2, R53.2, U20.5 (D-)
MOD0_USB+: U20.1 (D1+); also elsewhere on the board
MOD0_USB-: U20.7 (D1-); also elsewhere on the board
MOD0_USB_!EN: U20.8 (!OE); also elsewhere on the board
MOD1_D+_HUB-SW: D1.8 (A), R3.2, R54.2, U21.3 (D+)
MOD1_D-_HUB-SW: D1.6 (B), R4.2, R55.2, U21.5 (D-)
MOD1_USB+: U21.1 (D1+); also elsewhere on the board
MOD1_USB-: U21.7 (D1-); also elsewhere on the board
MOD1_USB_!EN: U21.8 (!OE); also elsewhere on the board
MOD2_D+_HUB-SW: D2.8 (A), R5.2, R56.2, U22.3 (D+)
MOD2_D-_HUB-SW: D2.6 (B), R6.2, R57.2, U22.5 (D-)
MOD2_USB+: U22.1 (D1+); also elsewhere on the board
MOD2_USB-: U22.7 (D1-); also elsewhere on the board
MOD2_USB_!EN: U22.8 (!OE); also elsewhere on the board
MOD5_D+_HUB-SW: D3.2 (C), R7.2, R58.2, U23.3 (D+)
MOD5_D-_HUB-SW: D3.4 (D), R8.2, R59.2, U23.5 (D-)
MOD5_USB+: U23.1 (D1+); also elsewhere on the board
MOD5_USB-: U23.7 (D1-); also elsewhere on the board
MOD5_USB_!EN: U23.8 (!OE); also elsewhere on the board
MOD6_D+_HUB-SW: D4.8 (A), R9.2, R60.2, U24.3 (D+)
MOD6_D-_HUB-SW: D4.6 (B), R10.2, R61.2, U24.5 (D-)
MOD6_USB+: U24.1 (D1+); also elsewhere on the board
MOD6_USB-: U24.7 (D1-); also elsewhere on the board
MOD6_USB_!EN: U24.8 (!OE); also elsewhere on the board
MOD7_D+_HUB-SW: D4.4 (D), R11.2, R62.2, U25.3 (D+)
MOD7_D-_HUB-SW: D4.2 (C), R12.2, R63.2, U25.5 (D-)
MOD7_USB+: U25.1 (D1+); also elsewhere on the board
MOD7_USB-: U25.7 (D1-); also elsewhere on the board
MOD7_USB_!EN: U25.8 (!OE); also elsewhere on the board
unnamed: R13.1, U20.2 (D2+)
unnamed: R24.1, U25.6 (D2-)
unnamed: R23.1, U25.2 (D2+)
unnamed: R22.1, U24.6 (D2-)
unnamed: R21.1, U24.2 (D2+)
unnamed: R20.1, U23.6 (D2-)
unnamed: R19.1, U23.2 (D2+)
unnamed: R17.1, U22.2 (D2+)
unnamed: R18.1, U22.6 (D2-)
unnamed: R16.1, U21.6 (D2-)
unnamed: R15.1, U21.2 (D2+)
unnamed: R14.1, U20.6 (D2-)
VCC_BACKPLANE: C64.2, C65.2, C66.2, C67.2, C68.2, C69.2, U20.9 (VCC), U21.9 (VCC), U22.9 (VCC), U23.9 (VCC), U24.9 (VCC), U25.9 (VCC); also elsewhere on the board

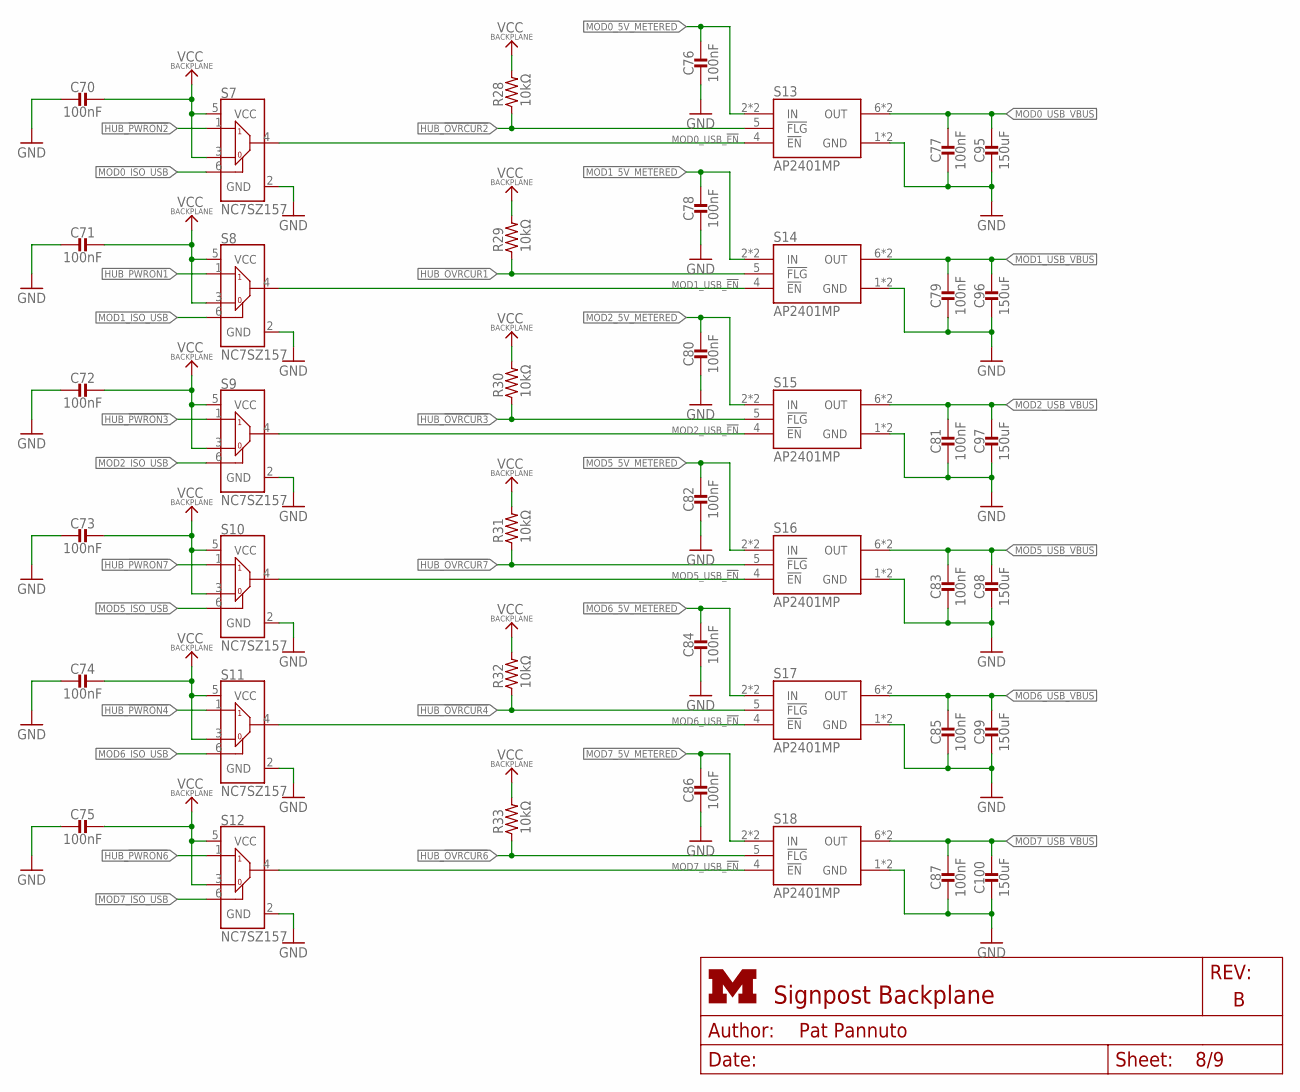
[picture p32: schematic backplane.sch, sheet 8]

Parts:
C70, C71, C72, C73, C74, C75, C76, C77, C78, C79, C80, C81, C82, C83, C84, C85, C86, C87: 100nF; 0603_CAP
C95, C96, C97, C98, C99, C100: 150uF; 1210_CAP; DIGIKEY 1276-3367-1-ND
R28, R29, R30, R31, R32, R33: 10kΩ; 0603-RES
S7, S8, S9, S10, S11, S12: NC7SZ157; SC70-6
S13, S14, S15, S16, S17, S18: AP2401MP; MSOP-8EP

Connections:
GND: C70.2, C71.2, C72.2, C73.2, C74.2, C75.2, C76.2, C77.2, C78.2, C79.2, C80.2, C81.2, C82.2, C83.2, C84.2, C85.2, C86.2, C87.2, C95.2, C96.2, C97.2, C98.2, C99.2, C100.2, S7.2 (GND), S8.2 (GND), S9.2 (GND), S10.2 (GND), S11.2 (GND), S12.2 (GND), S13.1 (GND), S13.PAD (GND), S14.1 (GND), S14.PAD (GND), S15.1 (GND), S15.PAD (GND), S16.1 (GND), S16.PAD (GND), S17.1 (GND), S17.PAD (GND), S18.1 (GND), S18.PAD (GND); also elsewhere on the board
HUB_!OVRCUR1: R29.1, S14.5 (!FLG); also elsewhere on the board
HUB_!OVRCUR2: R28.1, S13.5 (!FLG); also elsewhere on the board
HUB_!OVRCUR3: R30.1, S15.5 (!FLG); also elsewhere on the board
HUB_!OVRCUR4: R32.1, S17.5 (!FLG); also elsewhere on the board
HUB_!OVRCUR6: R33.1, S18.5 (!FLG); also elsewhere on the board
HUB_!OVRCUR7: R31.1, S16.5 (!FLG); also elsewhere on the board
HUB_!PWRON1: S8.1 (I1); also elsewhere on the board
HUB_!PWRON2: S7.1 (I1); also elsewhere on the board
HUB_!PWRON3: S9.1 (I1); also elsewhere on the board
HUB_!PWRON4: S11.1 (I1); also elsewhere on the board
HUB_!PWRON6: S12.1 (I1); also elsewhere on the board
HUB_!PWRON7: S10.1 (I1); also elsewhere on the board
MOD0_5V_METERED: C76.1, S13.2 (IN), S13.3 (IN); also elsewhere on the board
MOD0_ISO_USB: S7.6 (S); also elsewhere on the board
MOD0_USB_!EN: S7.4 (Z), S13.4 (!EN); also elsewhere on the board
MOD0_USB_VBUS: C77.1, C95.1, S13.6 (OUT), S13.7 (OUT); also elsewhere on the board
MOD1_5V_METERED: C78.1, S14.2 (IN), S14.3 (IN); also elsewhere on the board
MOD1_ISO_USB: S8.6 (S); also elsewhere on the board
MOD1_USB_!EN: S8.4 (Z), S14.4 (!EN); also elsewhere on the board
MOD1_USB_VBUS: C79.1, C96.1, S14.6 (OUT), S14.7 (OUT); also elsewhere on the board
MOD2_5V_METERED: C80.1, S15.2 (IN), S15.3 (IN); also elsewhere on the board
MOD2_ISO_USB: S9.6 (S); also elsewhere on the board
MOD2_USB_!EN: S9.4 (Z), S15.4 (!EN); also elsewhere on the board
MOD2_USB_VBUS: C81.1, C97.1, S15.6 (OUT), S15.7 (OUT); also elsewhere on the board
MOD5_5V_METERED: C82.1, S16.2 (IN), S16.3 (IN); also elsewhere on the board
MOD5_ISO_USB: S10.6 (S); also elsewhere on the board
MOD5_USB_!EN: S10.4 (Z), S16.4 (!EN); also elsewhere on the board
MOD5_USB_VBUS: C83.1, C98.1, S16.6 (OUT), S16.7 (OUT); also elsewhere on the board
MOD6_5V_METERED: C84.1, S17.2 (IN), S17.3 (IN); also elsewhere on the board
MOD6_ISO_USB: S11.6 (S); also elsewhere on the board
MOD6_USB_!EN: S11.4 (Z), S17.4 (!EN); also elsewhere on the board
MOD6_USB_VBUS: C85.1, C99.1, S17.6 (OUT), S17.7 (OUT); also elsewhere on the board
MOD7_5V_METERED: C86.1, S18.2 (IN), S18.3 (IN); also elsewhere on the board
MOD7_ISO_USB: S12.6 (S); also elsewhere on the board
MOD7_USB_!EN: S12.4 (Z), S18.4 (!EN); also elsewhere on the board
MOD7_USB_VBUS: C87.1, C100.1, S18.6 (OUT), S18.7 (OUT); also elsewhere on the board
VCC_BACKPLANE: C70.1, C71.1, C72.1, C73.1, C74.1, C75.1, R28.2, R29.2, R30.2, R31.2, R32.2, R33.2, S7.3 (I0), S7.5 (VCC), S8.3 (I0), S8.5 (VCC), S9.3 (I0), S9.5 (VCC), S10.3 (I0), S10.5 (VCC), S11.3 (I0), S11.5 (VCC), S12.3 (I0), S12.5 (VCC); also elsewhere on the board

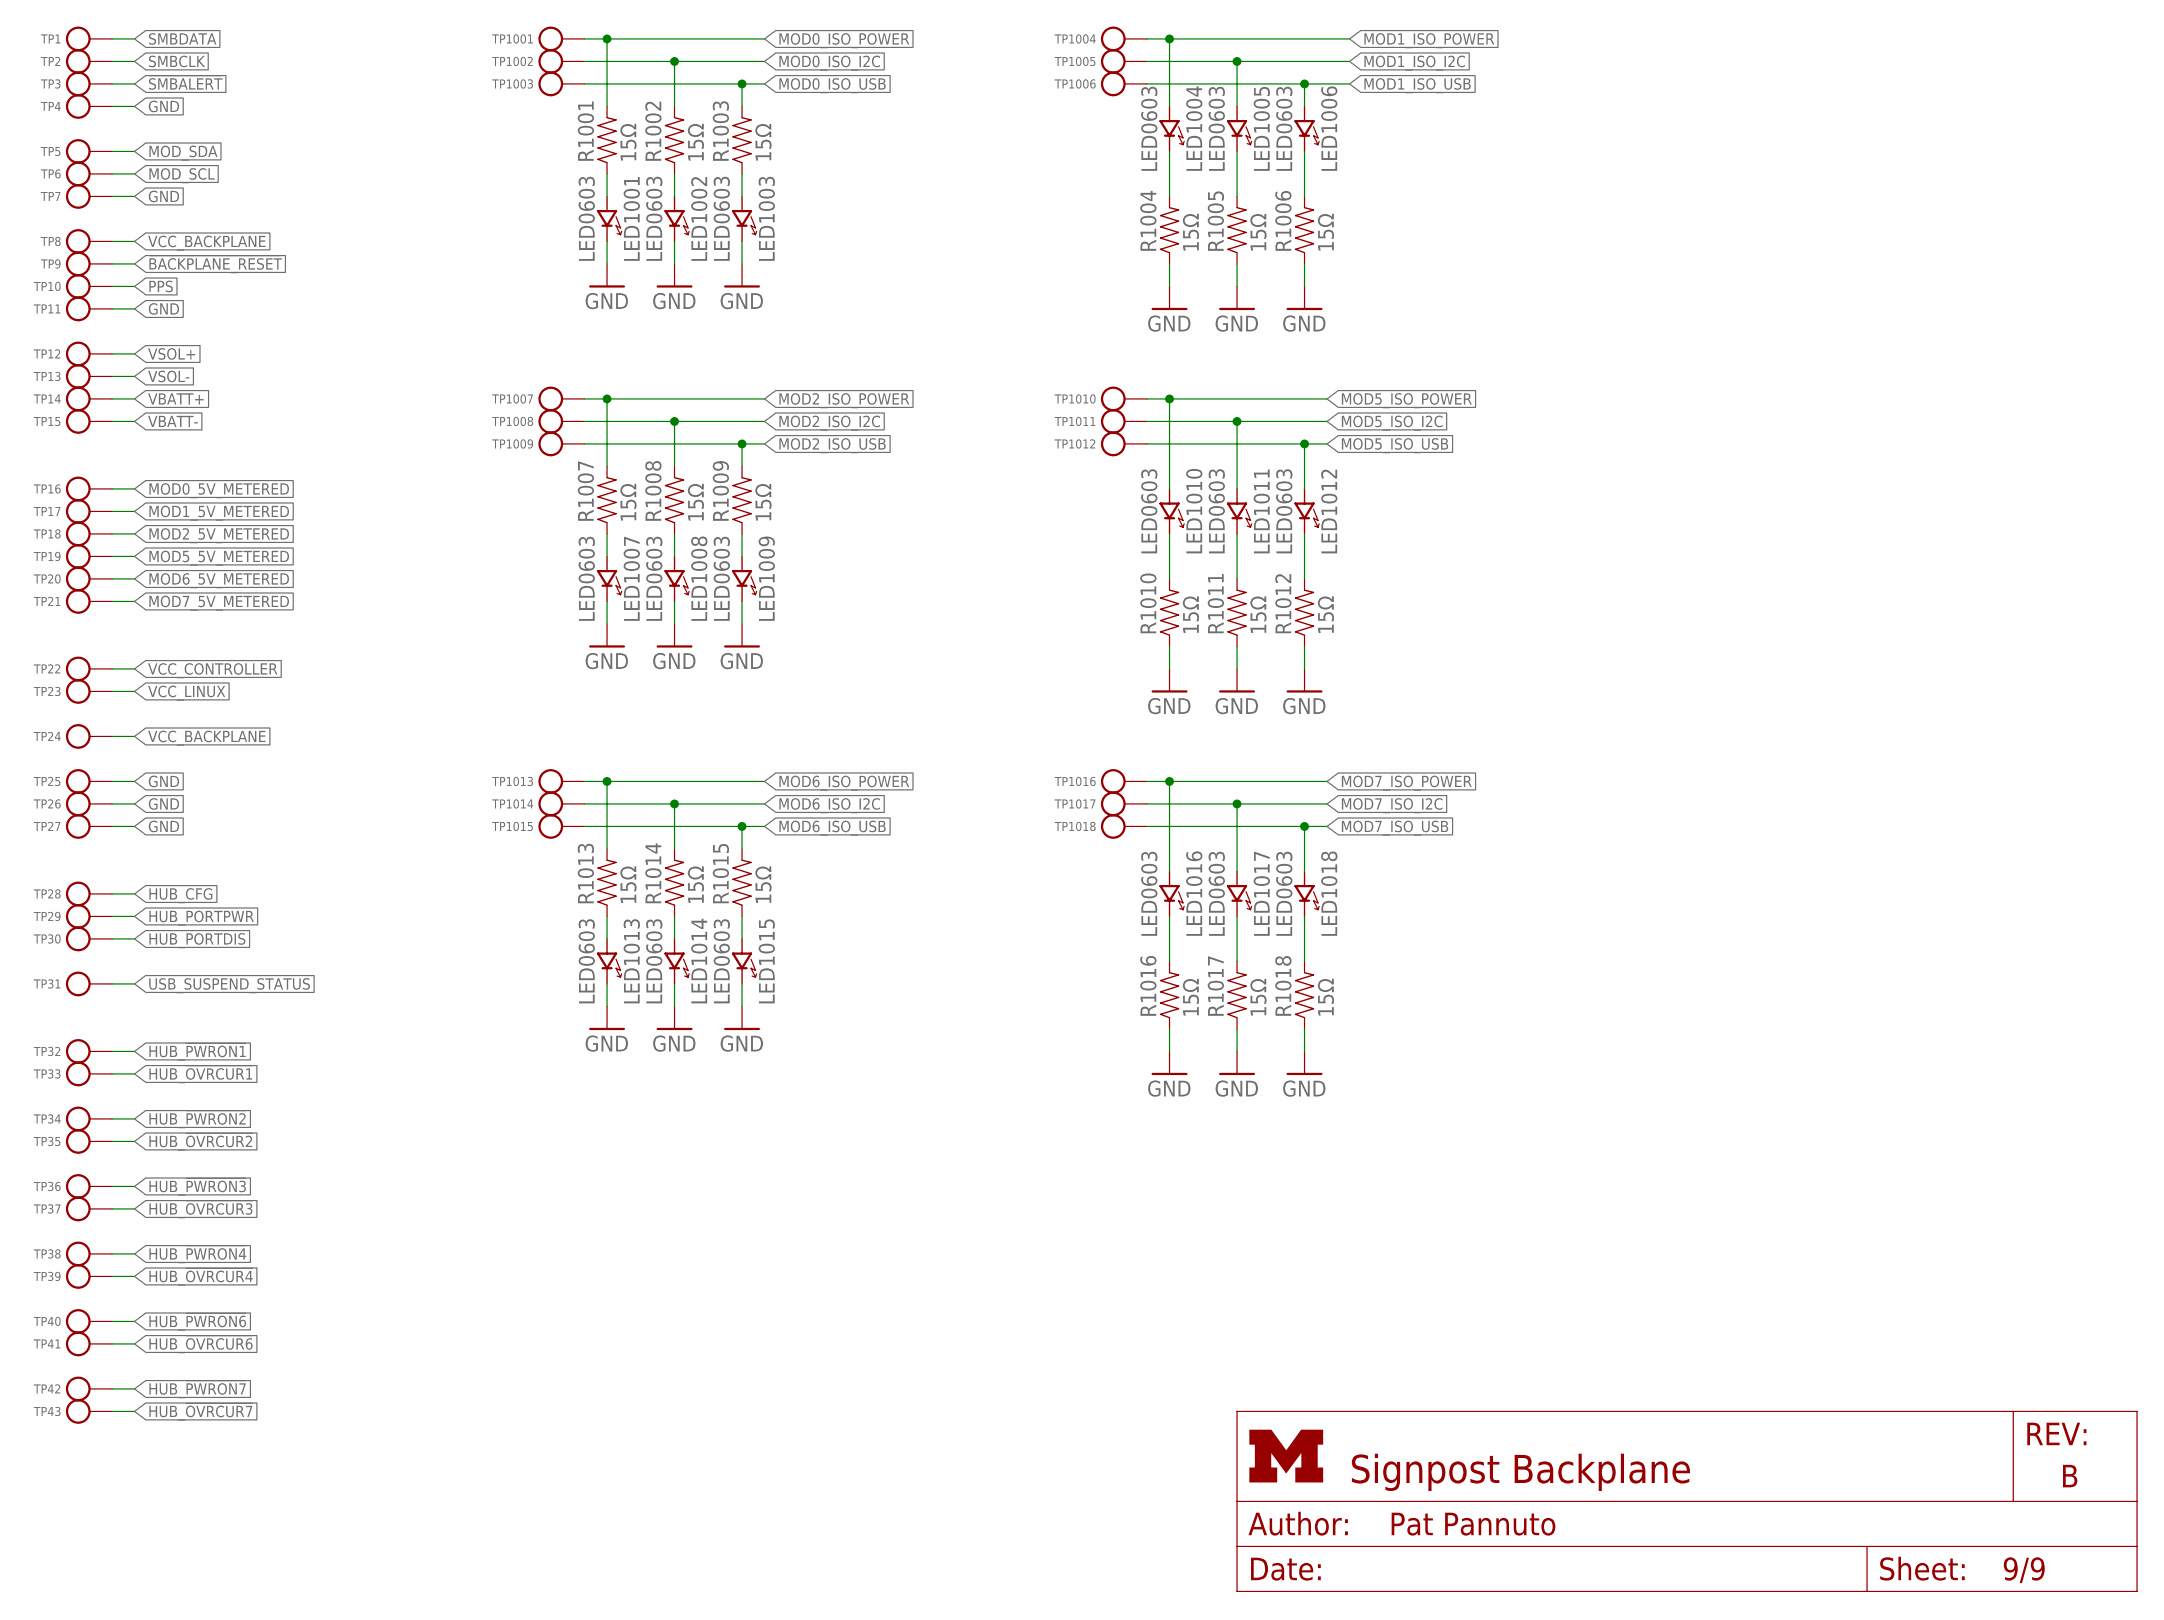
[picture p33: schematic backplane.sch, sheet 9]

Parts:
LED1001, LED1002, LED1003, LED1004, LED1005, LED1006, LED1007, LED1008, LED1009, LED1010, LED1011, LED1012, LED1013, LED1014, LED1015, LED1016, LED1017, LED1018: LED0603; LED-0603
R1001, R1002, R1003, R1004, R1005, R1006, R1007, R1008, R1009, R1010, R1011, R1012, R1013, R1014, R1015, R1016, R1017, R1018: 15Ω; 0603-RES
TP1, TP2, TP3, TP4, TP5, TP6, TP7, TP8, TP9, TP10, TP11, TP12, TP13, TP14, TP15, TP16, TP17, TP18, TP19, TP20, TP21, TP22, TP23, TP24, TP25, TP26, TP27, TP28, TP29, TP30, TP31, TP32, TP33, TP34, TP35, TP36, TP37, TP38, TP39, TP40, TP41, TP42, TP43, TP1001, TP1002, TP1003, TP1004, TP1005, TP1006, TP1007, TP1008, TP1009, TP1010, TP1011, TP1012, TP1013, TP1014, TP1015, TP1016, TP1017, TP1018: TEST_POINT_0.040IN; TESTPOINT_0.040IN

Connections:
!BACKPLANE_RESET: TP9.TESTPOINT; also elsewhere on the board
!SMBALERT: TP3.TESTPOINT; also elsewhere on the board
GND: LED1001.C (CATHODE), LED1002.C (CATHODE), LED1003.C (CATHODE), LED1007.C (CATHODE), LED1008.C (CATHODE), LED1009.C (CATHODE), LED1013.C (CATHODE), LED1014.C (CATHODE), LED1015.C (CATHODE), R1004.1, R1005.1, R1006.1, R1010.1, R1011.1, R1012.1, R1016.1, R1017.1, R1018.1, TP4.TESTPOINT, TP7.TESTPOINT, TP11.TESTPOINT, TP25.TESTPOINT, TP26.TESTPOINT, TP27.TESTPOINT; also elsewhere on the board
HUB_!OVRCUR1: TP33.TESTPOINT; also elsewhere on the board
HUB_!OVRCUR2: TP35.TESTPOINT; also elsewhere on the board
HUB_!OVRCUR3: TP37.TESTPOINT; also elsewhere on the board
HUB_!OVRCUR4: TP39.TESTPOINT; also elsewhere on the board
HUB_!OVRCUR6: TP41.TESTPOINT; also elsewhere on the board
HUB_!OVRCUR7: TP43.TESTPOINT; also elsewhere on the board
HUB_!PWRON1: TP32.TESTPOINT; also elsewhere on the board
HUB_!PWRON2: TP34.TESTPOINT; also elsewhere on the board
HUB_!PWRON3: TP36.TESTPOINT; also elsewhere on the board
HUB_!PWRON4: TP38.TESTPOINT; also elsewhere on the board
HUB_!PWRON6: TP40.TESTPOINT; also elsewhere on the board
HUB_!PWRON7: TP42.TESTPOINT; also elsewhere on the board
HUB_CFG: TP28.TESTPOINT; also elsewhere on the board
HUB_PORTDIS: TP30.TESTPOINT; also elsewhere on the board
HUB_PORTPWR: TP29.TESTPOINT; also elsewhere on the board
MOD0_5V_METERED: TP16.TESTPOINT; also elsewhere on the board
MOD0_ISO_I2C: R1002.2, TP1002.TESTPOINT; also elsewhere on the board
MOD0_ISO_POWER: R1001.2, TP1001.TESTPOINT; also elsewhere on the board
MOD0_ISO_USB: R1003.2, TP1003.TESTPOINT; also elsewhere on the board
MOD1_5V_METERED: TP17.TESTPOINT; also elsewhere on the board
MOD1_ISO_I2C: LED1005.A (ANODE), TP1005.TESTPOINT; also elsewhere on the board
MOD1_ISO_POWER: LED1004.A (ANODE), TP1004.TESTPOINT; also elsewhere on the board
MOD1_ISO_USB: LED1006.A (ANODE), TP1006.TESTPOINT; also elsewhere on the board
MOD2_5V_METERED: TP18.TESTPOINT; also elsewhere on the board
MOD2_ISO_I2C: R1008.2, TP1008.TESTPOINT; also elsewhere on the board
MOD2_ISO_POWER: R1007.2, TP1007.TESTPOINT; also elsewhere on the board
MOD2_ISO_USB: R1009.2, TP1009.TESTPOINT; also elsewhere on the board
MOD5_5V_METERED: TP19.TESTPOINT; also elsewhere on the board
MOD5_ISO_I2C: LED1011.A (ANODE), TP1011.TESTPOINT; also elsewhere on the board
MOD5_ISO_POWER: LED1010.A (ANODE), TP1010.TESTPOINT; also elsewhere on the board
MOD5_ISO_USB: LED1012.A (ANODE), TP1012.TESTPOINT; also elsewhere on the board
MOD6_5V_METERED: TP20.TESTPOINT; also elsewhere on the board
MOD6_ISO_I2C: R1014.2, TP1014.TESTPOINT; also elsewhere on the board
MOD6_ISO_POWER: R1013.2, TP1013.TESTPOINT; also elsewhere on the board
MOD6_ISO_USB: R1015.2, TP1015.TESTPOINT; also elsewhere on the board
MOD7_5V_METERED: TP21.TESTPOINT; also elsewhere on the board
MOD7_ISO_I2C: LED1017.A (ANODE), TP1017.TESTPOINT; also elsewhere on the board
MOD7_ISO_POWER: LED1016.A (ANODE), TP1016.TESTPOINT; also elsewhere on the board
MOD7_ISO_USB: LED1018.A (ANODE), TP1018.TESTPOINT; also elsewhere on the board
MOD_SCL: TP6.TESTPOINT; also elsewhere on the board
MOD_SDA: TP5.TESTPOINT; also elsewhere on the board
unnamed: LED1001.A (ANODE), R1001.1
unnamed: LED1002.A (ANODE), R1002.1
unnamed: LED1003.A (ANODE), R1003.1
unnamed: LED1007.A (ANODE), R1007.1
unnamed: LED1008.A (ANODE), R1008.1
unnamed: LED1009.A (ANODE), R1009.1
unnamed: LED1013.A (ANODE), R1013.1
unnamed: LED1014.A (ANODE), R1014.1
unnamed: LED1015.A (ANODE), R1015.1
unnamed: LED1004.C (CATHODE), R1004.2
unnamed: LED1005.C (CATHODE), R1005.2
unnamed: LED1006.C (CATHODE), R1006.2
unnamed: LED1010.C (CATHODE), R1010.2
unnamed: LED1011.C (CATHODE), R1011.2
unnamed: LED1012.C (CATHODE), R1012.2
unnamed: LED1016.C (CATHODE), R1016.2
unnamed: LED1017.C (CATHODE), R1017.2
unnamed: LED1018.C (CATHODE), R1018.2
PPS: TP10.TESTPOINT; also elsewhere on the board
SMBCLK: TP2.TESTPOINT; also elsewhere on the board
SMBDATA: TP1.TESTPOINT; also elsewhere on the board
USB_SUSPEND_STATUS: TP31.TESTPOINT; also elsewhere on the board
VBATT+: TP14.TESTPOINT; also elsewhere on the board
VBATT-: TP15.TESTPOINT; also elsewhere on the board
VCC_BACKPLANE: TP8.TESTPOINT, TP24.TESTPOINT; also elsewhere on the board
VCC_CONTROLLER: TP22.TESTPOINT; also elsewhere on the board
VCC_LINUX: TP23.TESTPOINT; also elsewhere on the board
VSOL+: TP12.TESTPOINT; also elsewhere on the board
VSOL-: TP13.TESTPOINT; also elsewhere on the board

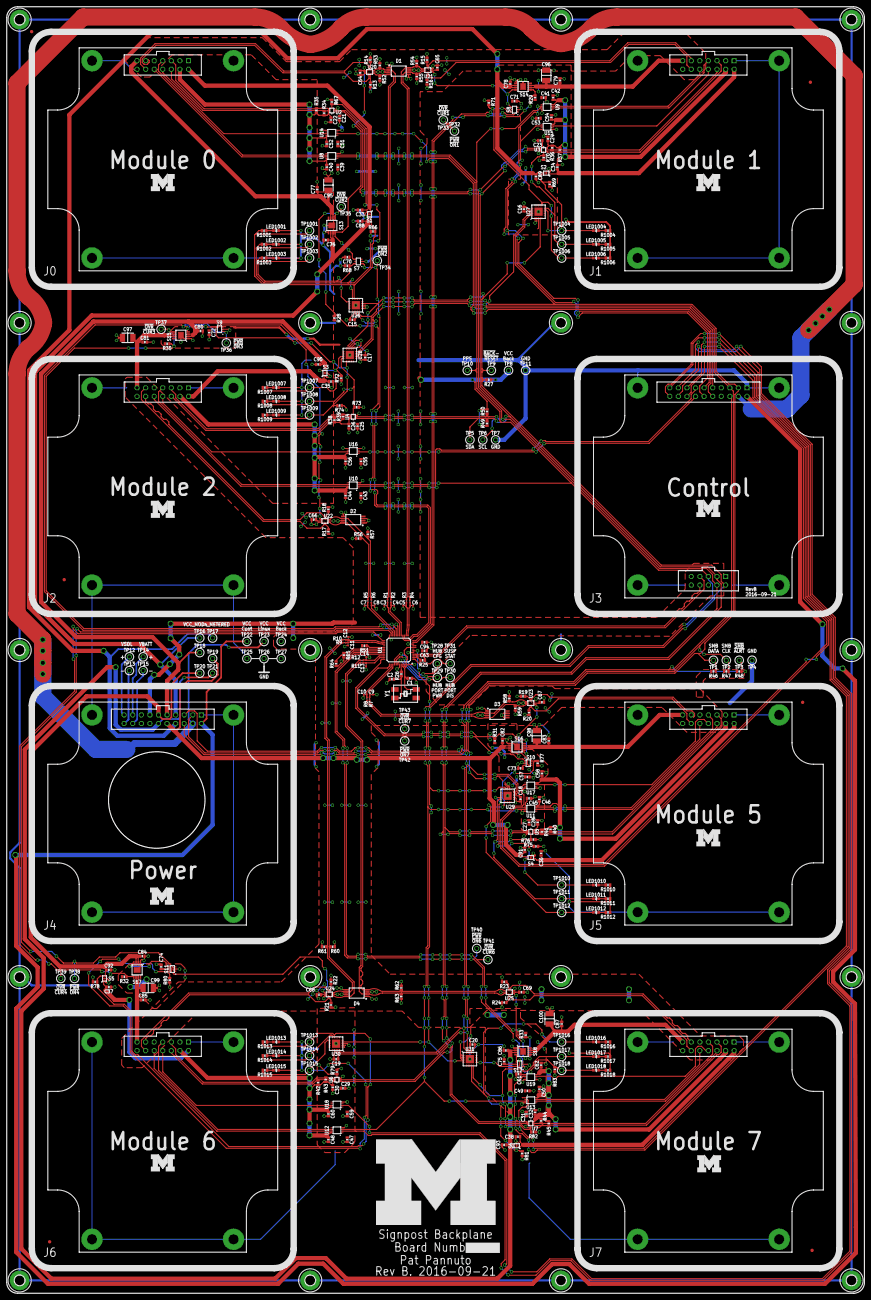
[picture p34: board backplane.brd from above]

Board: 2 copper layers, 254.0 x 381.0 mm, 377 parts (0 on the bottom side), 196 nets.
