longle2718/signpost/hardware/controller/rev_c/controller.brd

## EAGLE design hardware/controller/rev_c/controller.brd (continued)

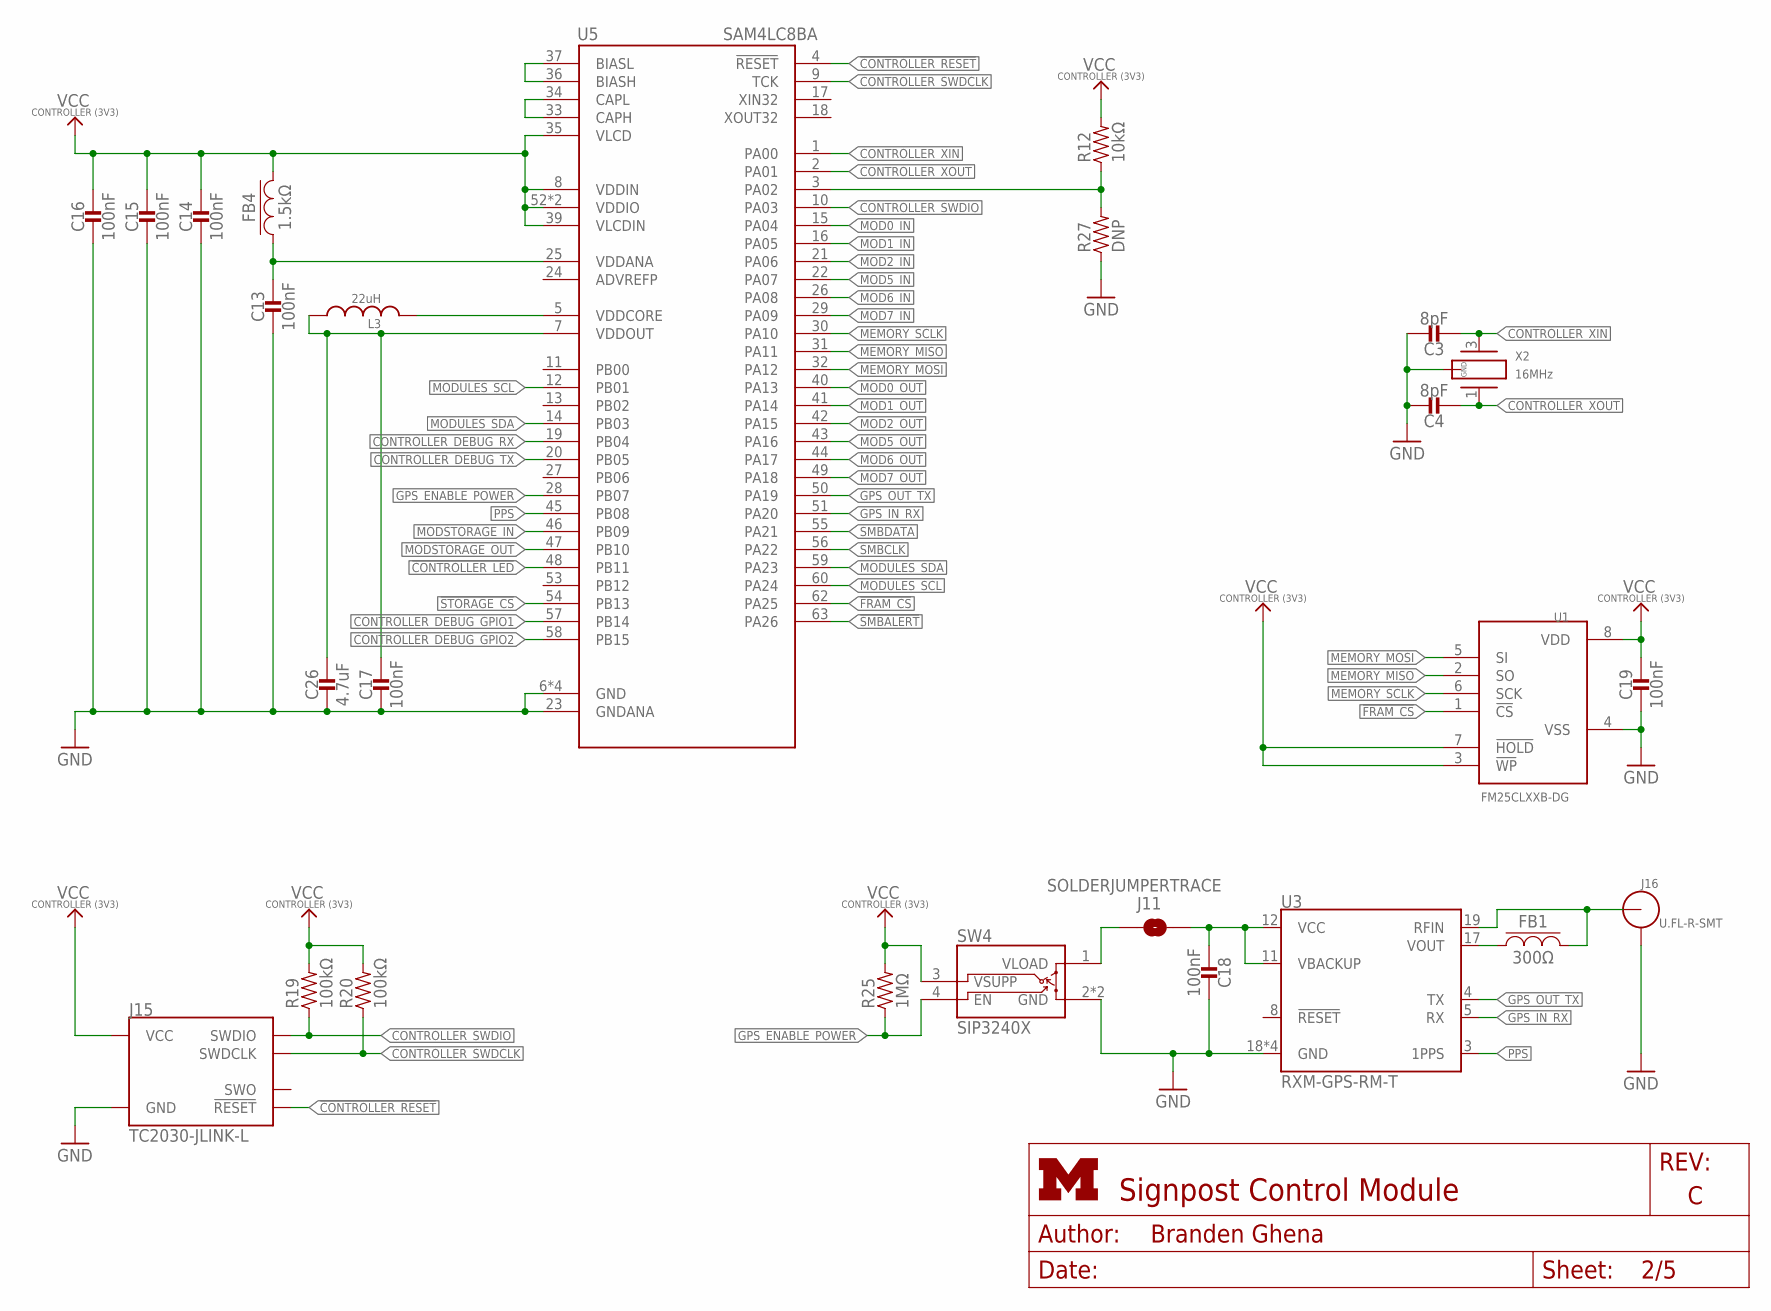
[picture p36: schematic controller.sch, sheet 2]

Parts:
C3, C4: 8pF; 0402_CAP; DIGIKEY 490-8230-1-ND
C13, C14, C15, C16, C17, C18, C19: 100nF; 0402_CAP; DIGIKEY 490-10777-1-ND
C26: 4.7uF; 0402_CAP; DIGIKEY 490-13252-1-ND
FB1: 300Ω; 0402_CAP; DIGIKEY ACML-0402-301-TCT-ND
FB4: 1.5kΩ; 0402_CAP; DIGIKEY 1276-6395-1-ND
J11: SOLDERJUMPERTRACE; SJ_2S-TRACE
J15: TC2030-JLINK-L; TC2030-IDC
J16: U.FL-R-SMT; U.FL_SMT
L3: 22uH; 1212
R12: 10kΩ; 0402_RES; DIGIKEY 1276-3431-1-ND
R19, R20: 100kΩ; 0402_RES; DIGIKEY 1276-3432-1-ND
R25: 1MΩ; 0402_RES; DIGIKEY 1276-3433-1-ND
R27: DNP; 0402_RES; DIGIKEY 1276-3431-1-ND
SW4: SIP3240X; TDFN4
U1: FM25CLXXB-DG; TDFN-8; DIGIKEY FM25CL64B-DGRA-ND
U3: RXM-GPS-RM-T
U5: SAM4LC8BA; QFN-64-9MM
X2: 16MHz; FHXXX

Connections:
!CONTROLLER_LED: U5.48 (PB11); also elsewhere on the board
!CONTROLLER_RESET: J15.3 (!RESET), U5.4 (!RESET); also elsewhere on the board
!FRAM_CS: U1.1 (!CS), U5.62 (PA25); also elsewhere on the board
!SMBALERT: U5.63 (PA26); also elsewhere on the board
!STORAGE_CS: U5.54 (PB13); also elsewhere on the board
CONTROLLER_BUCK/LDO_N: R12.1, R27.2, U5.3 (PA02)
CONTROLLER_DEBUG_GPIO1: U5.57 (PB14); also elsewhere on the board
CONTROLLER_DEBUG_GPIO2: U5.58 (PB15); also elsewhere on the board
CONTROLLER_DEBUG_RX: U5.19 (PB04); also elsewhere on the board
CONTROLLER_DEBUG_TX: U5.20 (PB05); also elsewhere on the board
CONTROLLER_SWDCLK: J15.4 (SWDCLK), R20.1, U5.9 (TCK); also elsewhere on the board
CONTROLLER_SWDIO: J15.2 (SWDIO), R19.1, U5.10 (PA03); also elsewhere on the board
CONTROLLER_XIN: C3.1, U5.1 (PA00), X2.3 (2)
CONTROLLER_XOUT: C4.1, U5.2 (PA01), X2.1
GND: C3.2, C4.2, C13.2, C14.2, C15.2, C16.2, C17.2, C18.2, C19.2, C26.2, J15.5 (GND), J16.GND1, J16.GND2, R27.1, SW4.2 (GND), SW4.PAD (GND), U1.4 (VSS), U3.18 (GND), U3.20 (GND), U3.21 (GND), U3.22 (GND), U5.6 (GND), U5.23 (GNDANA), U5.38 (GND), U5.64 (GND), U5.GND, X2.2 (GND), X2.4 (GND); also elsewhere on the board
GPS_ENABLE_POWER: R25.1, SW4.4 (EN), U5.28 (PB07)
GPS_IN_RX: U3.5 (RX), U5.51 (PA20); also elsewhere on the board
GPS_OUT_TX: U3.4 (TX), U5.50 (PA19); also elsewhere on the board
MEMORY_MISO: U1.2 (SO), U5.31 (PA11); also elsewhere on the board
MEMORY_MOSI: U1.5 (SI), U5.32 (PA12); also elsewhere on the board
MEMORY_SCLK: U1.6 (SCK), U5.30 (PA10); also elsewhere on the board
MOD0_IN: U5.15 (PA04); also elsewhere on the board
MOD0_OUT: U5.40 (PA13); also elsewhere on the board
MOD1_IN: U5.16 (PA05); also elsewhere on the board
MOD1_OUT: U5.41 (PA14); also elsewhere on the board
MOD2_IN: U5.21 (PA06); also elsewhere on the board
MOD2_OUT: U5.42 (PA15); also elsewhere on the board
MOD5_IN: U5.22 (PA07); also elsewhere on the board
MOD5_OUT: U5.43 (PA16); also elsewhere on the board
MOD6_IN: U5.26 (PA08); also elsewhere on the board
MOD6_OUT: U5.44 (PA17); also elsewhere on the board
MOD7_IN: U5.29 (PA09); also elsewhere on the board
MOD7_OUT: U5.49 (PA18); also elsewhere on the board
MODSTORAGE_IN: U5.46 (PB09); also elsewhere on the board
MODSTORAGE_OUT: U5.47 (PB10); also elsewhere on the board
MODULES_SCL: U5.12 (PB01), U5.60 (PA24); also elsewhere on the board
MODULES_SDA: U5.14 (PB03), U5.59 (PA23); also elsewhere on the board
unnamed: FB1.1, U3.17 (VOUT)
unnamed: FB1.2, J16.SIG (ANT), U3.19 (RFIN)
unnamed: J11.1, SW4.1 (VLOAD)
unnamed: C13.1, FB4.1, U5.25 (VDDANA)
unnamed: C17.1, C26.1, L3.P$1 (1), U5.7 (VDDOUT)
unnamed: U5.36 (BIASH), U5.37 (BIASL)
unnamed: U5.33 (CAPH), U5.34 (CAPL)
unnamed: C18.1, J11.2, U3.11 (VBACKUP), U3.12 (VCC)
unnamed: L3.P$2 (2), U5.5 (VDDCORE)
PPS: U3.3 (1PPS), U5.45 (PB08); also elsewhere on the board
SMBCLK: U5.56 (PA22); also elsewhere on the board
SMBDATA: U5.55 (PA21); also elsewhere on the board
VCC_CONTROLLER: C14.1, C15.1, C16.1, C19.1, FB4.2, J15.1 (VCC), R12.2, R19.2, R20.2, R25.2, SW4.3 (VSUPP), U1.3 (!WP), U1.7 (!HOLD), U1.8 (VDD), U5.8 (VDDIN), U5.35 (VLCD), U5.39 (VLCDIN), U5.52 (VDDIO), U5.61 (VDDIO); also elsewhere on the board

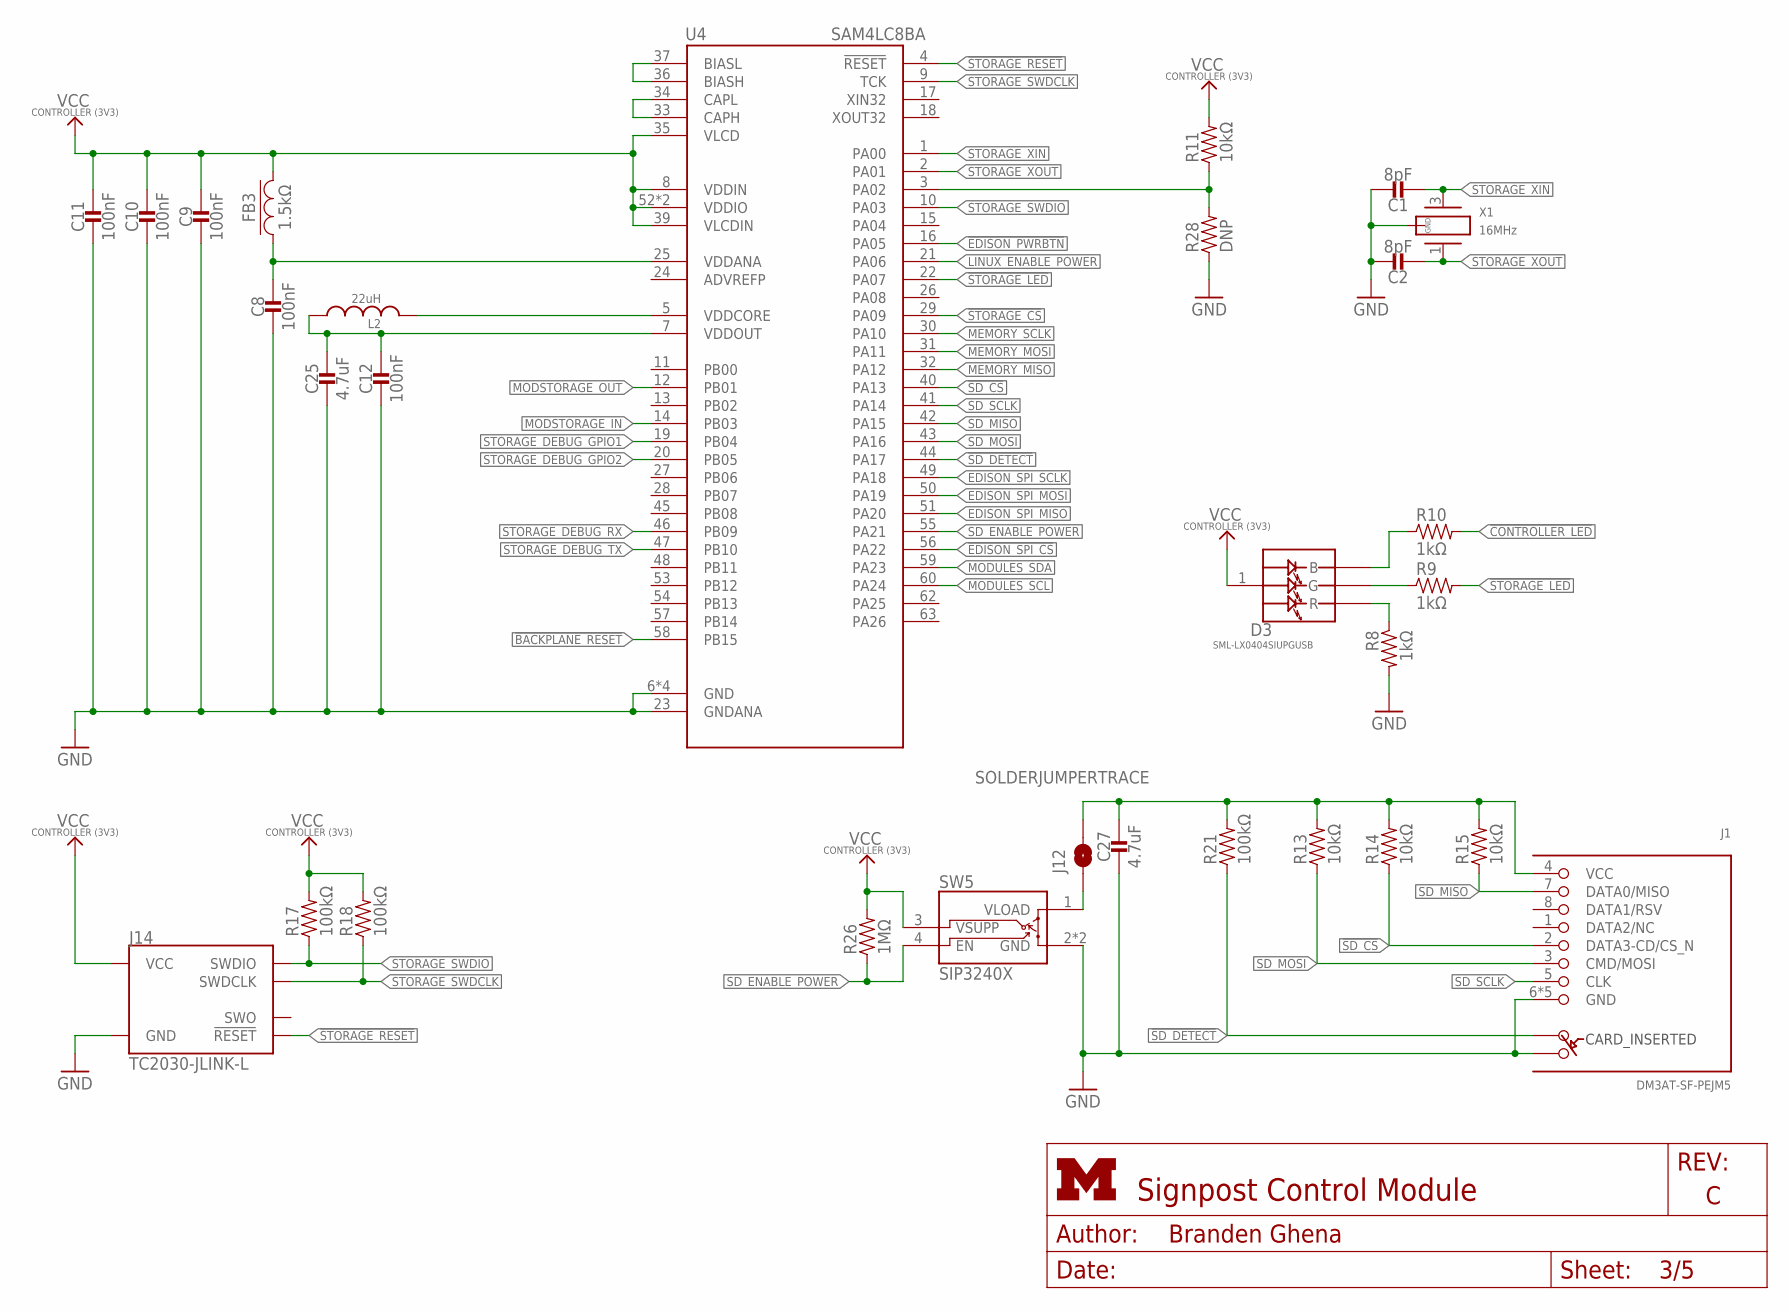
[picture p37: schematic controller.sch, sheet 3]

Parts:
C1, C2: 8pF; 0402_CAP; DIGIKEY 490-8230-1-ND
C8, C9, C10, C11, C12: 100nF; 0402_CAP; DIGIKEY 490-10777-1-ND
C25, C27: 4.7uF; 0402_CAP; DIGIKEY 490-13252-1-ND
D3: SML-LX0404SIUPGUSB; 1MM_SQ_4PAD
FB3: 1.5kΩ; 0402_CAP; DIGIKEY 1276-6395-1-ND
J1: DM3AT-SF-PEJM5
J12: SOLDERJUMPERTRACE; SJ_2S-TRACE
J14: TC2030-JLINK-L; TC2030-IDC
L2: 22uH; 1212
R8, R9, R10: 1kΩ; 0402_RES; DIGIKEY 1276-3430-1-ND
R11, R13, R14, R15: 10kΩ; 0402_RES; DIGIKEY 1276-3431-1-ND
R17, R18, R21: 100kΩ; 0402_RES; DIGIKEY 1276-3432-1-ND
R26: 1MΩ; 0402_RES; DIGIKEY 1276-3433-1-ND
R28: DNP; 0402_RES; DIGIKEY 1276-3431-1-ND
SW5: SIP3240X; TDFN4
U4: SAM4LC8BA; QFN-64-9MM
X1: 16MHz; FHXXX

Connections:
!BACKPLANE_RESET: U4.58 (PB15); also elsewhere on the board
!CONTROLLER_LED: R10.2; also elsewhere on the board
!EDISON_PWRBTN: U4.16 (PA05); also elsewhere on the board
!EDISON_SPI_CS: U4.56 (PA22); also elsewhere on the board
!SD_CS: J1.2 (DATA3-CD/CS_N), R14.1, U4.40 (PA13); also elsewhere on the board
!SD_DETECT: J1.A, R21.1, U4.44 (PA17)
!STORAGE_CS: U4.29 (PA09); also elsewhere on the board
!STORAGE_LED: R9.2, U4.22 (PA07)
!STORAGE_RESET: J14.3 (!RESET), U4.4 (!RESET); also elsewhere on the board
EDISON_SPI_MISO: U4.51 (PA20); also elsewhere on the board
EDISON_SPI_MOSI: U4.50 (PA19); also elsewhere on the board
EDISON_SPI_SCLK: U4.49 (PA18); also elsewhere on the board
GND: C1.2, C2.2, C8.2, C9.2, C10.2, C11.2, C12.2, C25.2, C27.2, J1.6 (GND), J1.B, J1.MOUNT0 (GND), J1.MOUNT1 (GND), J1.MOUNT2 (GND), J1.MOUNT3 (GND), J14.5 (GND), R8.2, R28.1, SW5.2 (GND), SW5.PAD (GND), U4.6 (GND), U4.23 (GNDANA), U4.38 (GND), U4.64 (GND), U4.GND, X1.2 (GND), X1.4 (GND); also elsewhere on the board
LINUX_ENABLE_POWER: U4.21 (PA06); also elsewhere on the board
MEMORY_MISO: U4.32 (PA12); also elsewhere on the board
MEMORY_MOSI: U4.31 (PA11); also elsewhere on the board
MEMORY_SCLK: U4.30 (PA10); also elsewhere on the board
MODSTORAGE_IN: U4.14 (PB03); also elsewhere on the board
MODSTORAGE_OUT: U4.12 (PB01); also elsewhere on the board
MODULES_SCL: U4.60 (PA24); also elsewhere on the board
MODULES_SDA: U4.59 (PA23); also elsewhere on the board
unnamed: D3.2 (R), R8.1
unnamed: D3.4 (G), R9.1
unnamed: D3.3 (B), R10.1
unnamed: J12.1, SW5.1 (VLOAD)
unnamed: C8.1, FB3.1, U4.25 (VDDANA)
unnamed: C12.1, C25.1, L2.P$1 (1), U4.7 (VDDOUT)
unnamed: L2.P$2 (2), U4.5 (VDDCORE)
unnamed: U4.33 (CAPH), U4.34 (CAPL)
unnamed: U4.36 (BIASH), U4.37 (BIASL)
unnamed: C27.1, J1.4 (VCC), J12.2, R13.2, R14.2, R15.2, R21.2
SD_ENABLE_POWER: R26.1, SW5.4 (EN), U4.55 (PA21)
SD_MISO: J1.7 (DATA0/MISO), R15.1, U4.42 (PA15); also elsewhere on the board
SD_MOSI: J1.3 (CMD/MOSI), R13.1, U4.43 (PA16); also elsewhere on the board
SD_SCLK: J1.5 (CLK), U4.41 (PA14); also elsewhere on the board
STORAGE_BUCK/LDO_N: R11.1, R28.2, U4.3 (PA02)
STORAGE_DEBUG_GPIO1: U4.19 (PB04); also elsewhere on the board
STORAGE_DEBUG_GPIO2: U4.20 (PB05); also elsewhere on the board
STORAGE_DEBUG_RX: U4.46 (PB09); also elsewhere on the board
STORAGE_DEBUG_TX: U4.47 (PB10); also elsewhere on the board
STORAGE_SWDCLK: J14.4 (SWDCLK), R18.1, U4.9 (TCK); also elsewhere on the board
STORAGE_SWDIO: J14.2 (SWDIO), R17.1, U4.10 (PA03); also elsewhere on the board
STORAGE_XIN: C1.1, U4.1 (PA00), X1.3 (2)
STORAGE_XOUT: C2.1, U4.2 (PA01), X1.1
VCC_CONTROLLER: C9.1, C10.1, C11.1, D3.1 (VDD), FB3.2, J14.1 (VCC), R11.2, R17.2, R18.2, R26.2, SW5.3 (VSUPP), U4.8 (VDDIN), U4.35 (VLCD), U4.39 (VLCDIN), U4.52 (VDDIO), U4.61 (VDDIO); also elsewhere on the board

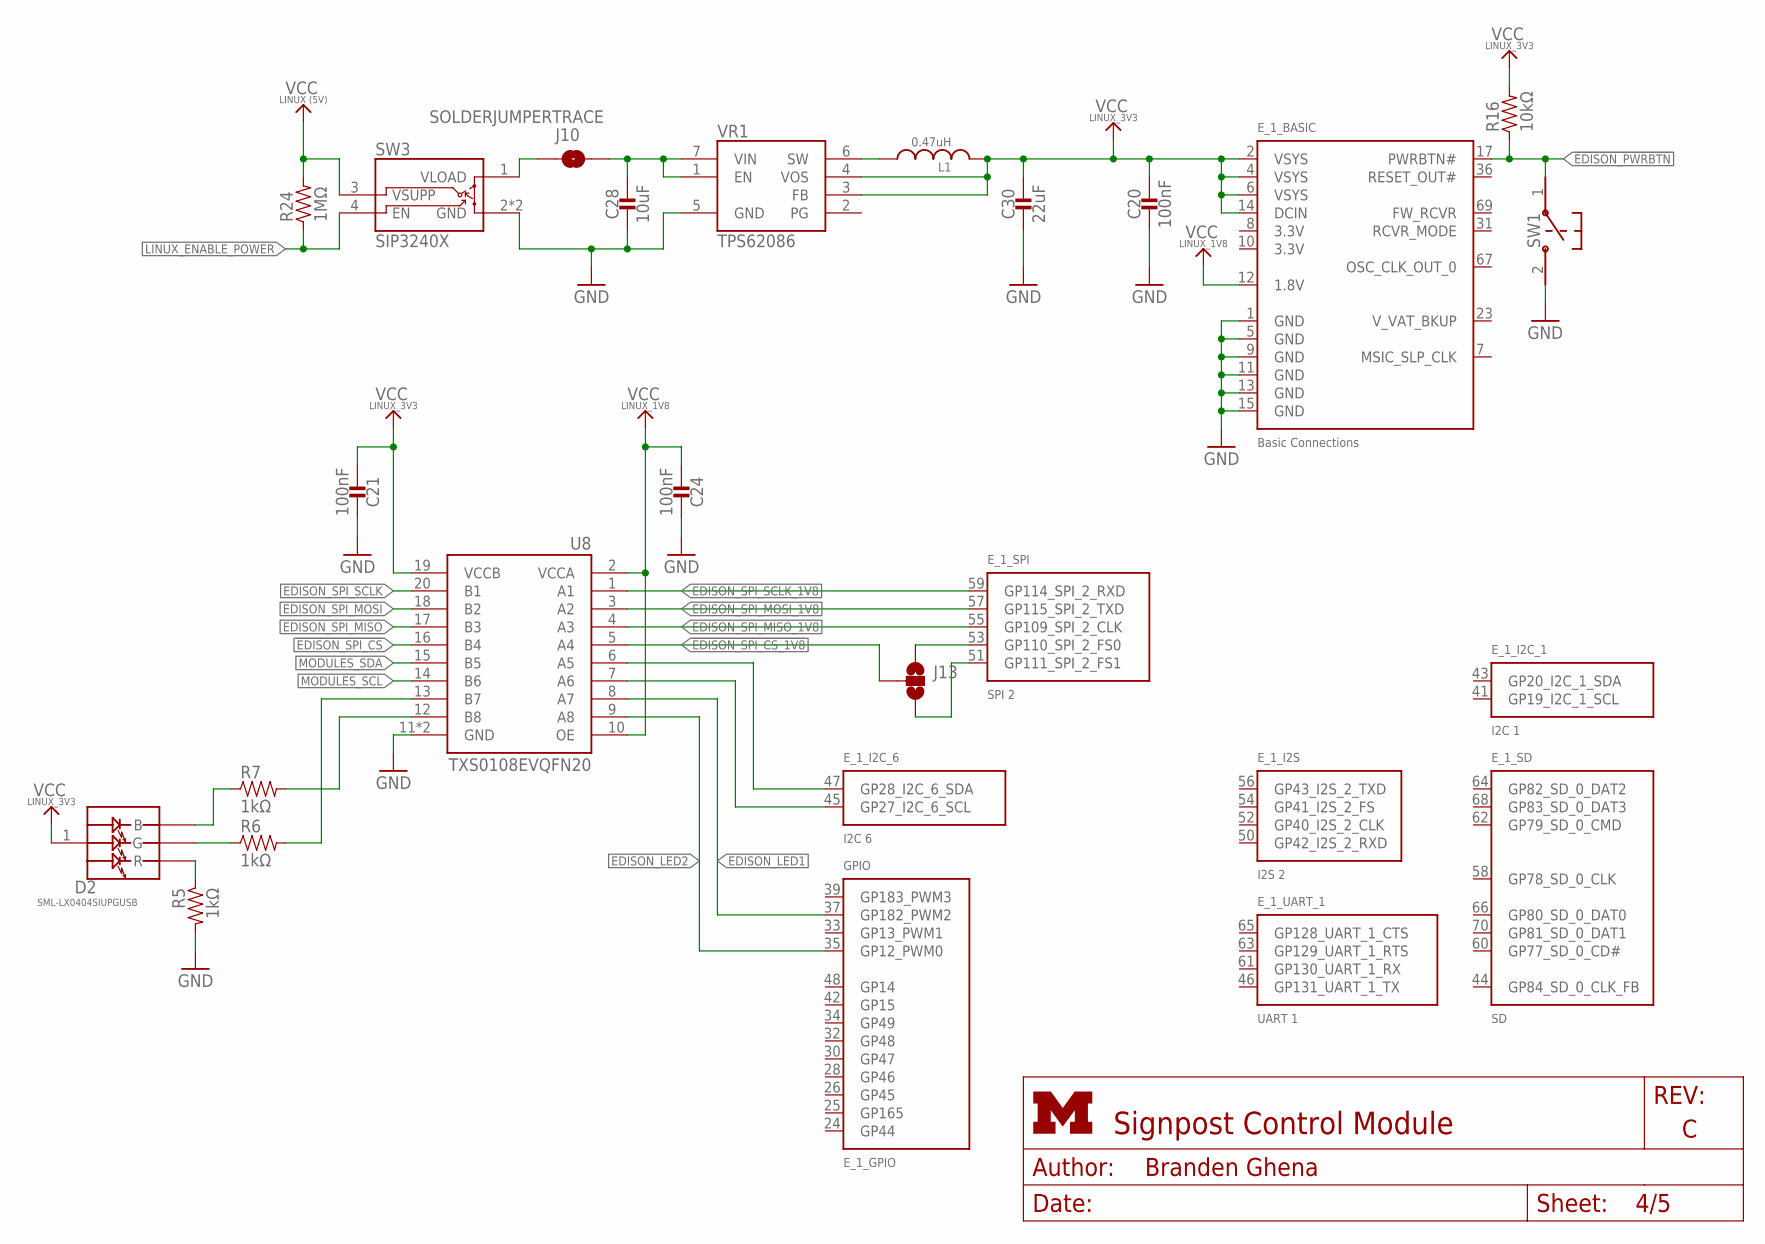
[picture p38: schematic controller.sch, sheet 4]

Parts:
C20, C21, C24: 100nF; 0402_CAP; DIGIKEY 490-10777-1-ND
C28: 10uF; 0805_CAP; DIGIKEY 490-8316-1-ND
C30: 22uF; 0805_CAP; DIGIKEY 490-1719-1-ND
D2: SML-LX0404SIUPGUSB; 1MM_SQ_4PAD
E_1: EDISON_CONNECTOR_SEGMENTED; EDISON_DAUGHTER; MOUSER 798-DF40HC3070DS4V51
J10: SOLDERJUMPERTRACE; SJ_2S-TRACE
J13: SOLDERJUMPER_2WAYPASTE2&3; SJ_3_PASTE2&3
L1: 0.47uH; DFE322512C; DIGIKEY 490-10596-1-ND
R5, R6, R7: 1kΩ; 0402_RES; DIGIKEY 1276-3430-1-ND
R16: 10kΩ; 0402_RES; DIGIKEY 1276-3431-1-ND
R24: 1MΩ; 0402_RES; DIGIKEY 1276-3433-1-ND
SW1: B3U-1000P
SW3: SIP3240X; TDFN4
U8: TXS0108EVQFN20; R-PVQFN-N20; DIGIKEY 296-24806-1-ND
VR1: TPS62086; RLT0007A

Connections:
!EDISON_PWRBTN: E_1.17 (PWRBTN#), R16.1, SW1.1; also elsewhere on the board
!EDISON_SPI_CS: U8.16 (B4); also elsewhere on the board
!EDISON_SPI_CS_1V8: J13.2, U8.5 (A4); also elsewhere on the board
EDISON_LED1: E_1.37 (GP182_PWM2), U8.8 (A7); also elsewhere on the board
EDISON_LED2: E_1.35 (GP12_PWM0), U8.9 (A8); also elsewhere on the board
EDISON_SPI_MISO: U8.17 (B3); also elsewhere on the board
EDISON_SPI_MISO_1V8: E_1.55 (GP109_SPI_2_CLK), U8.4 (A3); also elsewhere on the board
EDISON_SPI_MOSI: U8.18 (B2); also elsewhere on the board
EDISON_SPI_MOSI_1V8: E_1.57 (GP115_SPI_2_TXD), U8.3 (A2); also elsewhere on the board
EDISON_SPI_SCLK: U8.20 (B1); also elsewhere on the board
EDISON_SPI_SCLK_1V8: E_1.59 (GP114_SPI_2_RXD), U8.1 (A1); also elsewhere on the board
GND: C20.2, C21.1, C24.1, C28.P$2 (2), C30.P$2 (2), E_1.1 (GND), E_1.5 (GND), E_1.9 (GND), E_1.11 (GND), E_1.13 (GND), E_1.15 (GND), R5.2, SW1.2, SW3.2 (GND), SW3.PAD (GND), U8.11 (GND), U8.THERMAL (GND), VR1.5 (GND); also elsewhere on the board
LINUX_5V_IN: C28.P$1 (1), J10.2, VR1.1 (EN), VR1.7 (VIN)
LINUX_ENABLE_POWER: R24.1, SW3.4 (EN); also elsewhere on the board
MODULES_SCL: U8.14 (B6); also elsewhere on the board
MODULES_SCL_1V8: E_1.45 (GP27_I2C_6_SCL), U8.7 (A6)
MODULES_SDA: U8.15 (B5); also elsewhere on the board
MODULES_SDA_1V8: E_1.47 (GP28_I2C_6_SDA), U8.6 (A5)
unnamed: E_1.53 (GP110_SPI_2_FS0), J13.1
unnamed: R7.2, U8.12 (B8)
unnamed: E_1.51 (GP111_SPI_2_FS1), J13.3
unnamed: L1.P$1 (1), VR1.6 (SW)
unnamed: J10.1, SW3.1 (VLOAD)
unnamed: D2.2 (R), R5.1
unnamed: D2.4 (G), R6.1
unnamed: D2.3 (B), R7.1
unnamed: R6.2, U8.13 (B7)
VCC_LINUX: R24.2, SW3.3 (VSUPP); also elsewhere on the board
VCC_LINUX_1V8: C24.2, E_1.12 (1.8V), U8.2 (VCCA), U8.10 (OE); also elsewhere on the board
VCC_LINUX_3V3: C20.1, C21.2, C30.P$1 (1), D2.1 (VDD), E_1.2 (VSYS), E_1.4 (VSYS), E_1.6 (VSYS), E_1.14 (DCIN), L1.P$2 (2), R16.2, U8.19 (VCCB), VR1.3 (FB), VR1.4 (VOS); also elsewhere on the board

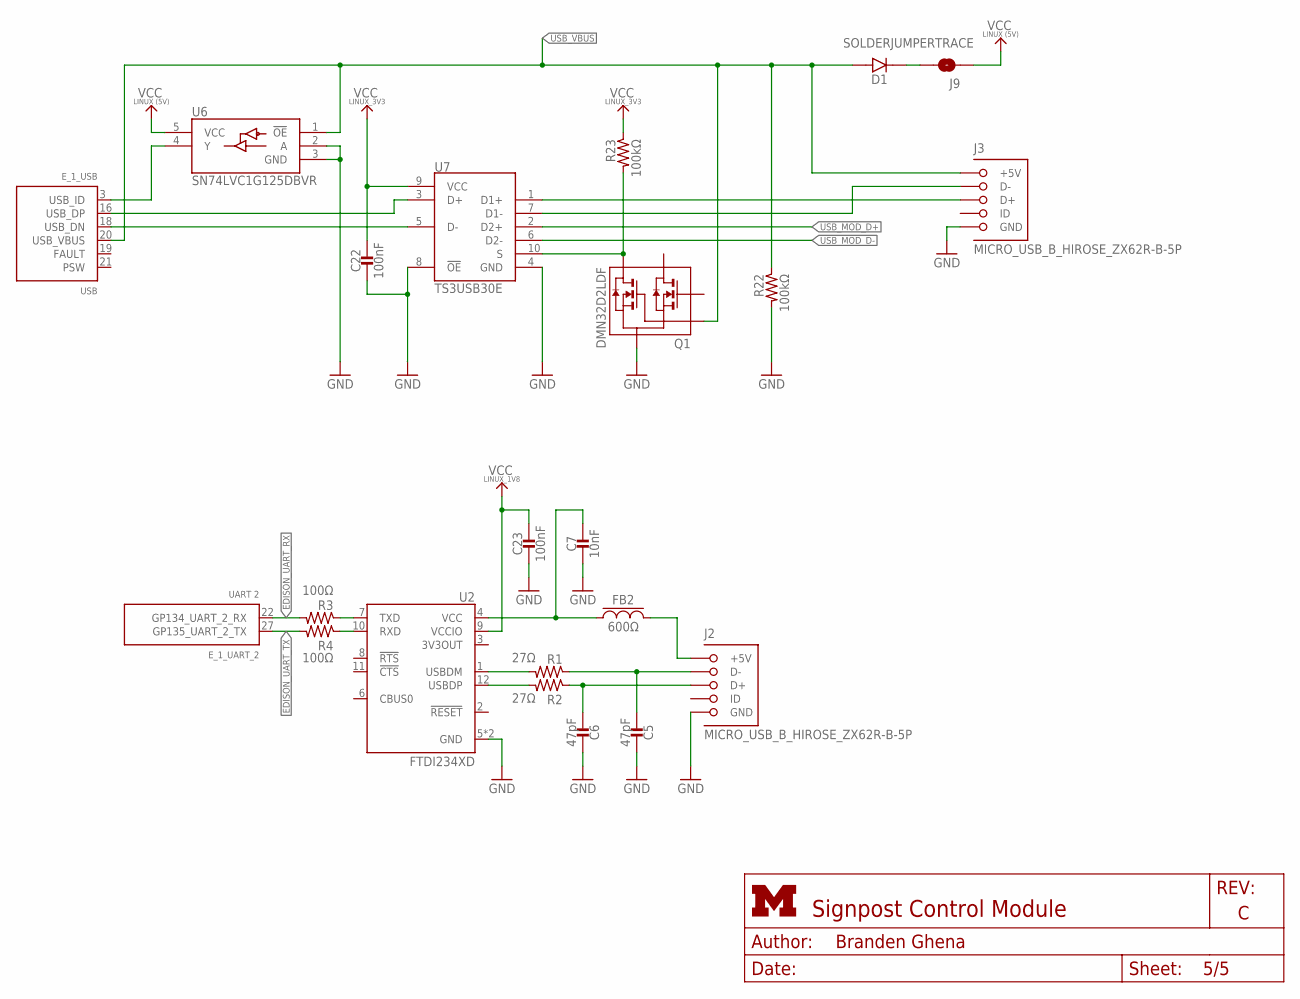
[picture p39: schematic controller.sch, sheet 5]

Parts:
C5, C6: 47pF; 0402_CAP; DIGIKEY 490-6241-1-ND
C7: 10nF; 0402_CAP; DIGIKEY 490-6296-1-ND
C22, C23: 100nF; 0402_CAP; DIGIKEY 490-10777-1-ND
D1: DIODE; 0805_DIODE; DIGIKEY 478-7800-1-ND
E_1: EDISON_CONNECTOR_SEGMENTED; EDISON_DAUGHTER; MOUSER 798-DF40HC3070DS4V51
FB2: 600Ω; 0805_CAP; DIGIKEY 240-2390-1-ND
J2, J3: MICRO_USB_B_HIROSE_ZX62R-B-5P; USB_MICRO_B-HIROSE-ZX62R-B-5P; DIGIKEY H125274CT-ND
J9: SOLDERJUMPERTRACE; SJ_2S-TRACE
Q1: DMN32D2LDF; SOT353
R1, R2: 27Ω; 0402_RES; DIGIKEY 1276-3907-1-ND
R3, R4: 100Ω; 0402_RES; DIGIKEY 1276-3429-1-ND
R22, R23: 100kΩ; 0402_RES; DIGIKEY 1276-3432-1-ND
U2: FTDI234XD; DFN-12/3MM
U6: SN74LVC1G125DBVR; SOT-23-5
U7: TS3USB30E; UQFN-10

Connections:
D+: C6.1, J2.3 (D+), R2.1
D-: C5.1, J2.2 (D-), R1.1
EDISON_UART_RX: E_1.22 (GP134_UART_2_RX), R3.2; also elsewhere on the board
EDISON_UART_TX: E_1.27 (GP135_UART_2_TX), R4.2; also elsewhere on the board
GND: C5.2, C6.2, C7.2, C22.2, C23.2, J2.5 (GND), J3.5 (GND), Q1.S, R22.2, U2.5 (GND), U2.13 (GND), U6.2 (A), U6.3 (GND), U7.4 (GND), U7.8 (!OE); also elsewhere on the board
unnamed: R1.2, U2.1 (USBDM)
unnamed: R2.2, U2.12 (USBDP)
unnamed: J3.2 (D-), U7.7 (D1-)
unnamed: J3.3 (D+), U7.1 (D1+)
unnamed: FB2.P$2, J2.1 (+5V)
unnamed: D1.CATHODE, J9.2
unnamed: E_1.3 (USB_ID), U6.4 (Y)
unnamed: R3.1, U2.7 (TXD)
unnamed: R4.1, U2.10 (RXD)
unnamed: C7.1, FB2.P$1, U2.4 (VCC)
unnamed: Q1.D2, R23.2, U7.10 (S)
USB_D+: E_1.16 (USB_DP), U7.3 (D+)
USB_D-: E_1.18 (USB_DN), U7.5 (D-)
USB_MOD_D+: U7.2 (D2+); also elsewhere on the board
USB_MOD_D-: U7.6 (D2-); also elsewhere on the board
USB_VBUS: D1.ANODE, E_1.20 (USB_VBUS), J3.1 (+5V), Q1.G2, R22.1, U6.1 (!OE)
VCC_LINUX: J9.1, U6.5 (VCC); also elsewhere on the board
VCC_LINUX_1V8: C23.1, U2.9 (VCCIO); also elsewhere on the board
VCC_LINUX_3V3: C22.1, R23.1, U7.9 (VCC); also elsewhere on the board

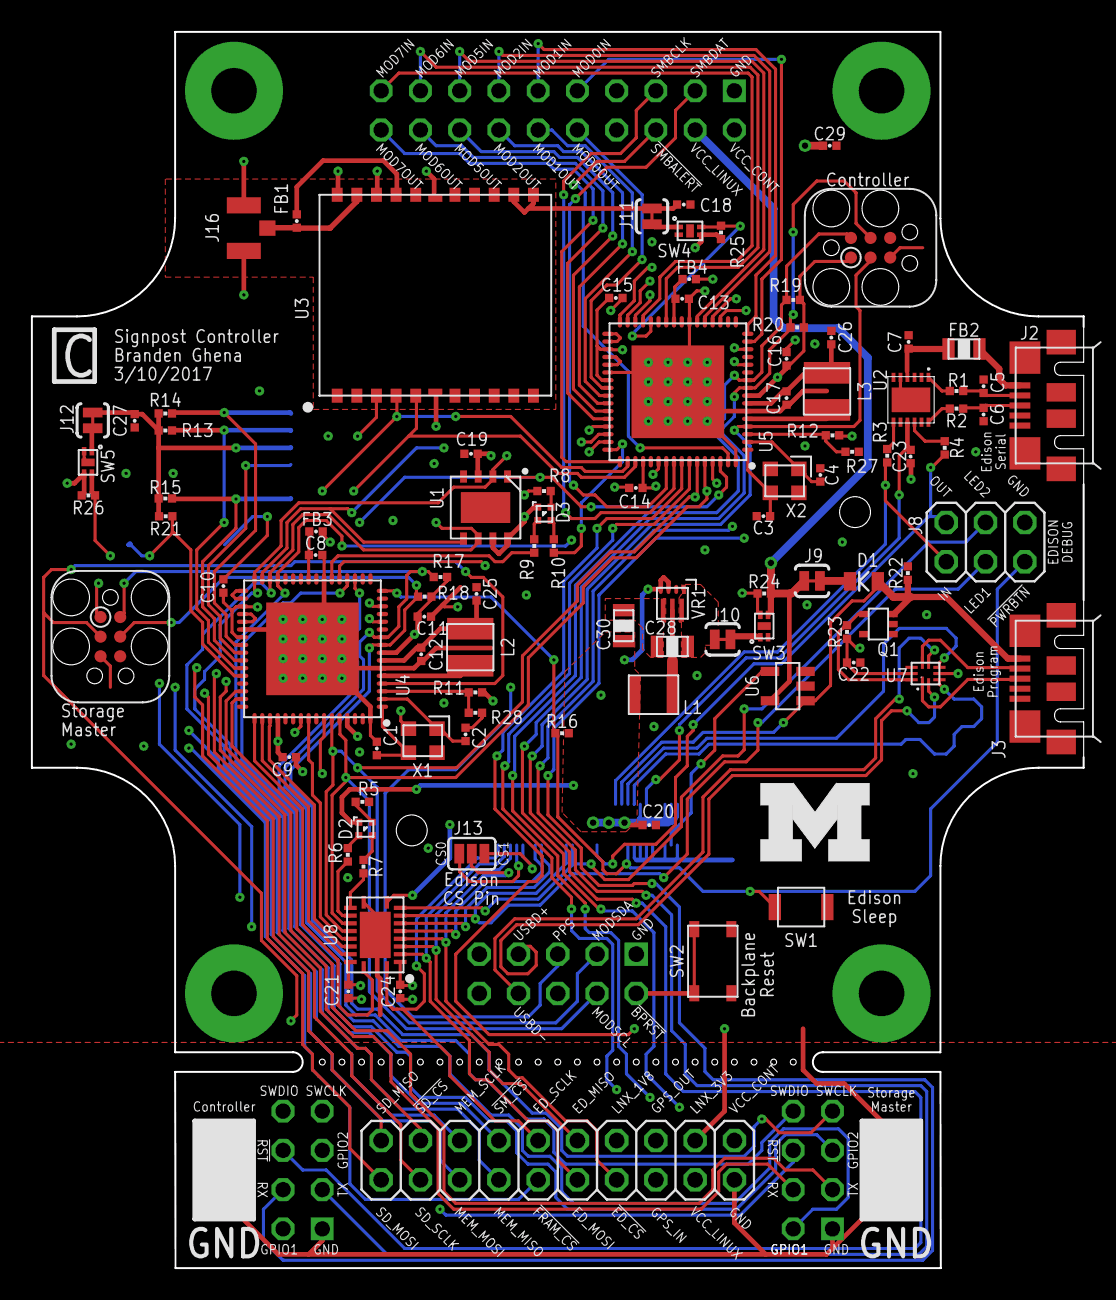
[picture p40: board controller.brd from above]

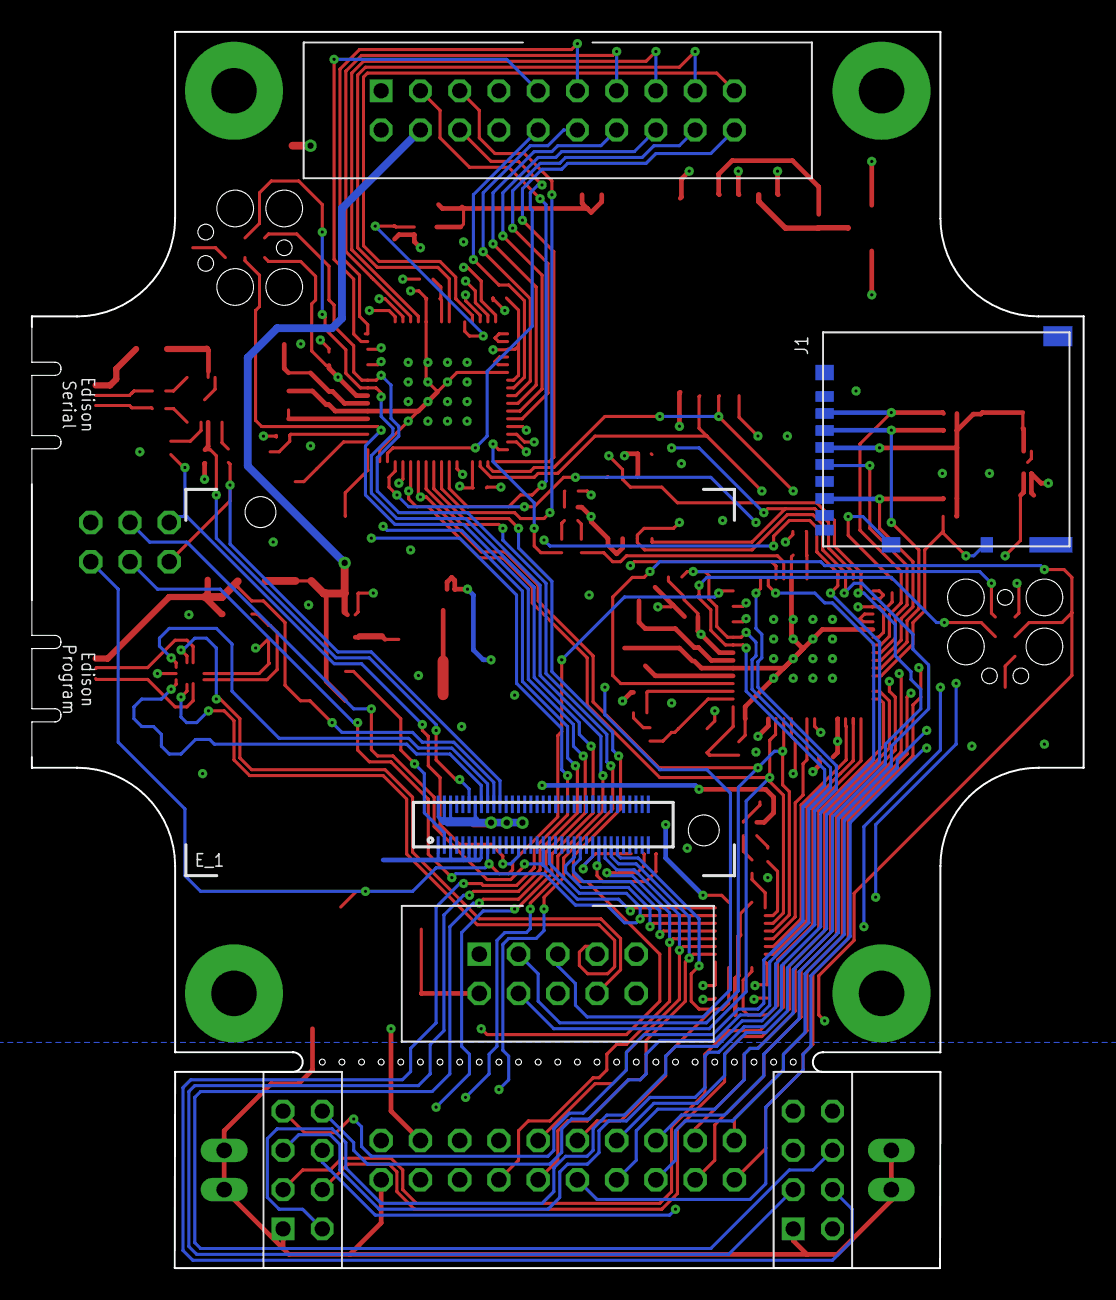
[picture p41: board controller.brd from below]

Board: 4 copper layers, 68.1 x 80.0 mm, 103 parts (2 on the bottom side), 125 nets.
