longle2718/signpost/hardware/power_supply_module/rev_c/power_supply_module.brd

## EAGLE design hardware/power_supply_module/rev_c/power_supply_module.brd (2017-03-07)

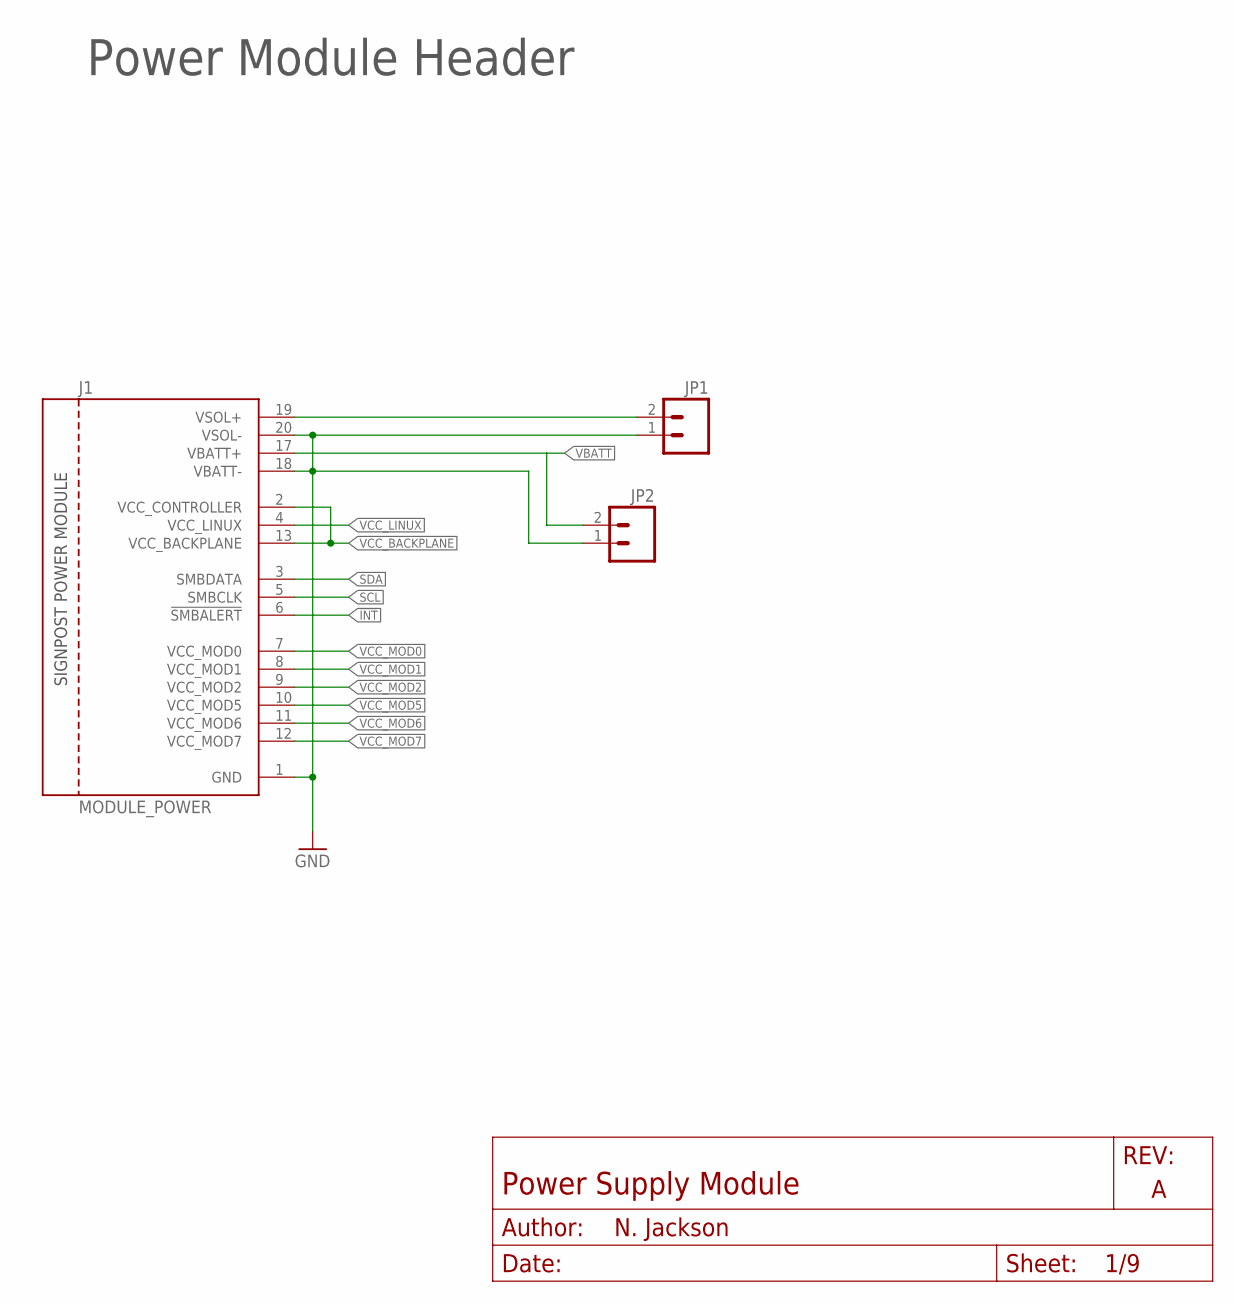
[picture p42: schematic power_supply_module.sch, sheet 1]

Parts:
J1: MODULE_POWER
JP1, JP2: M02PTH; 1X02

Connections:
!INT: J1.6 (!SMBALERT); also elsewhere on the board
GND: J1.1 (GND), J1.18 (VBATT-), J1.20 (VSOL-), JP1.1, JP2.1; also elsewhere on the board
SCL: J1.5 (SMBCLK); also elsewhere on the board
SDA: J1.3 (SMBDATA); also elsewhere on the board
VBATT: J1.17 (VBATT+), JP2.2; also elsewhere on the board
VCC_BACKPLANE: J1.2 (VCC_CONTROLLER), J1.13 (VCC_BACKPLANE); also elsewhere on the board
VCC_LINUX: J1.4 (VCC_LINUX); also elsewhere on the board
VCC_MOD0: J1.7 (VCC_MOD0); also elsewhere on the board
VCC_MOD1: J1.8 (VCC_MOD1); also elsewhere on the board
VCC_MOD2: J1.9 (VCC_MOD2); also elsewhere on the board
VCC_MOD5: J1.10 (VCC_MOD5); also elsewhere on the board
VCC_MOD6: J1.11 (VCC_MOD6); also elsewhere on the board
VCC_MOD7: J1.12 (VCC_MOD7); also elsewhere on the board
VSOL: J1.19 (VSOL+), JP1.2; also elsewhere on the board

Notes on the sheet:
Power Module Header
