longle2718/signpost/hardware/power_supply_module/rev_c/power_supply_module.brd

## EAGLE design hardware/power_supply_module/rev_c/power_supply_module.brd (continued)

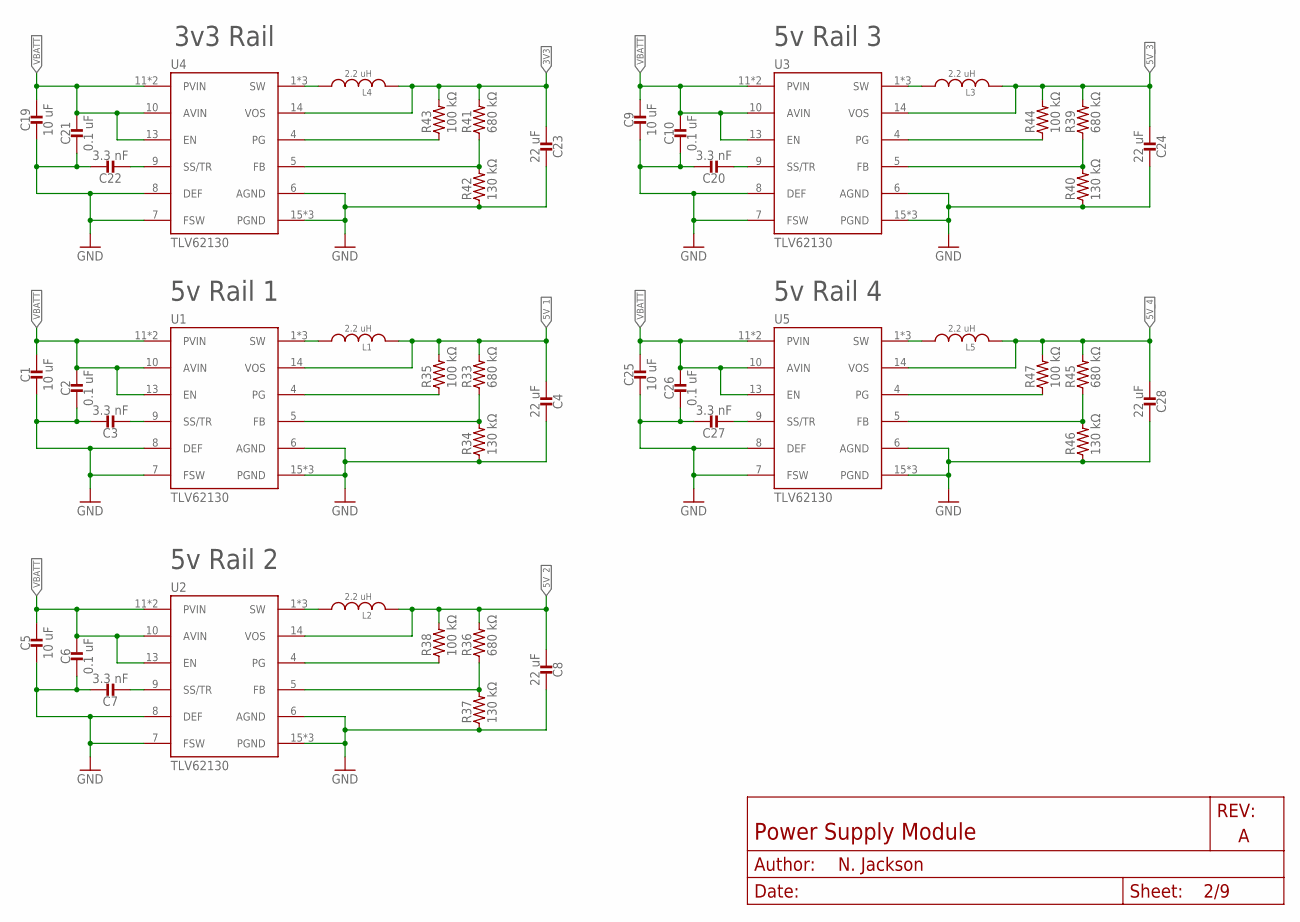
[picture p43: schematic power_supply_module.sch, sheet 2]

Parts:
C1, C5, C9, C19, C25: 10 uF; 0805_CAP
C2, C6, C10, C21, C26: 0.1 uF; 0402_CAP
C3, C7, C20, C22, C27: 3.3 nF; 0402_CAP
C4, C8, C23, C24, C28: 22 uF; 0603_CAP
L1, L2, L3, L4, L5: 2.2 uH; IHL-1212BZ-11
R33, R36, R39, R41, R45: 680 kΩ; 0402_RES
R34, R37, R40, R42, R46: 130 kΩ; 0402_RES
R35, R38, R43, R44, R47: 100 kΩ; 0402_RES
U1, U2, U3, U4, U5: TLV62130; TQFN-16/3MM

Connections:
3V3: C23.2, L4.P$2 (2), R41.2, R43.2, U4.14 (VOS); also elsewhere on the board
5V_1: C4.2, L1.P$2 (2), R33.2, R35.2, U1.14 (VOS); also elsewhere on the board
5V_2: C8.2, L2.P$2 (2), R36.2, R38.2, U2.14 (VOS); also elsewhere on the board
5V_3: C24.2, L3.P$2 (2), R39.2, R44.2, U3.14 (VOS); also elsewhere on the board
5V_4: C28.2, L5.P$2 (2), R45.2, R47.2, U5.14 (VOS); also elsewhere on the board
GND: C1.P$2 (2), C2.2, C3.1, C4.1, C5.P$2 (2), C6.2, C7.1, C8.1, C9.P$2 (2), C10.2, C19.P$2 (2), C20.1, C21.2, C22.1, C23.1, C24.1, C25.P$2 (2), C26.2, C27.1, C28.1, R34.1, R37.1, R40.1, R42.1, R46.1, U1.6 (AGND), U1.7 (FSW), U1.8 (DEF), U1.15 (PGND), U1.16 (PGND), U1.GND, U2.6 (AGND), U2.7 (FSW), U2.8 (DEF), U2.15 (PGND), U2.16 (PGND), U2.GND, U3.6 (AGND), U3.7 (FSW), U3.8 (DEF), U3.15 (PGND), U3.16 (PGND), U3.GND, U4.6 (AGND), U4.7 (FSW), U4.8 (DEF), U4.15 (PGND), U4.16 (PGND), U4.GND, U5.6 (AGND), U5.7 (FSW), U5.8 (DEF), U5.15 (PGND), U5.16 (PGND), U5.GND; also elsewhere on the board
unnamed: L4.P$1 (1), U4.1 (SW), U4.2 (SW), U4.3 (SW)
unnamed: C3.2, U1.9 (SS/TR)
unnamed: R35.1, U1.4 (PG)
unnamed: R33.1, R34.2, U1.5 (FB)
unnamed: C7.2, U2.9 (SS/TR)
unnamed: L2.P$1 (1), U2.1 (SW), U2.2 (SW), U2.3 (SW)
unnamed: R38.1, U2.4 (PG)
unnamed: R36.1, R37.2, U2.5 (FB)
unnamed: C22.2, U4.9 (SS/TR)
unnamed: L1.P$1 (1), U1.1 (SW), U1.2 (SW), U1.3 (SW)
unnamed: C20.2, U3.9 (SS/TR)
unnamed: R43.1, U4.4 (PG)
unnamed: R41.1, R42.2, U4.5 (FB)
unnamed: L3.P$1 (1), U3.1 (SW), U3.2 (SW), U3.3 (SW)
unnamed: R44.1, U3.4 (PG)
unnamed: R39.1, R40.2, U3.5 (FB)
unnamed: C27.2, U5.9 (SS/TR)
unnamed: L5.P$1 (1), U5.1 (SW), U5.2 (SW), U5.3 (SW)
unnamed: R47.1, U5.4 (PG)
unnamed: R45.1, R46.2, U5.5 (FB)
VBATT: C1.P$1 (1), C2.1, C5.P$1 (1), C6.1, C9.P$1 (1), C10.1, C19.P$1 (1), C21.1, C25.P$1 (1), C26.1, U1.10 (AVIN), U1.11 (PVIN), U1.12 (PVIN), U1.13 (EN), U2.10 (AVIN), U2.11 (PVIN), U2.12 (PVIN), U2.13 (EN), U3.10 (AVIN), U3.11 (PVIN), U3.12 (PVIN), U3.13 (EN), U4.10 (AVIN), U4.11 (PVIN), U4.12 (PVIN), U4.13 (EN), U5.10 (AVIN), U5.11 (PVIN), U5.12 (PVIN), U5.13 (EN); also elsewhere on the board

Notes on the sheet:
3v3 Rail
5v Rail 1
5v Rail 2
5v Rail 4
5v Rail 3

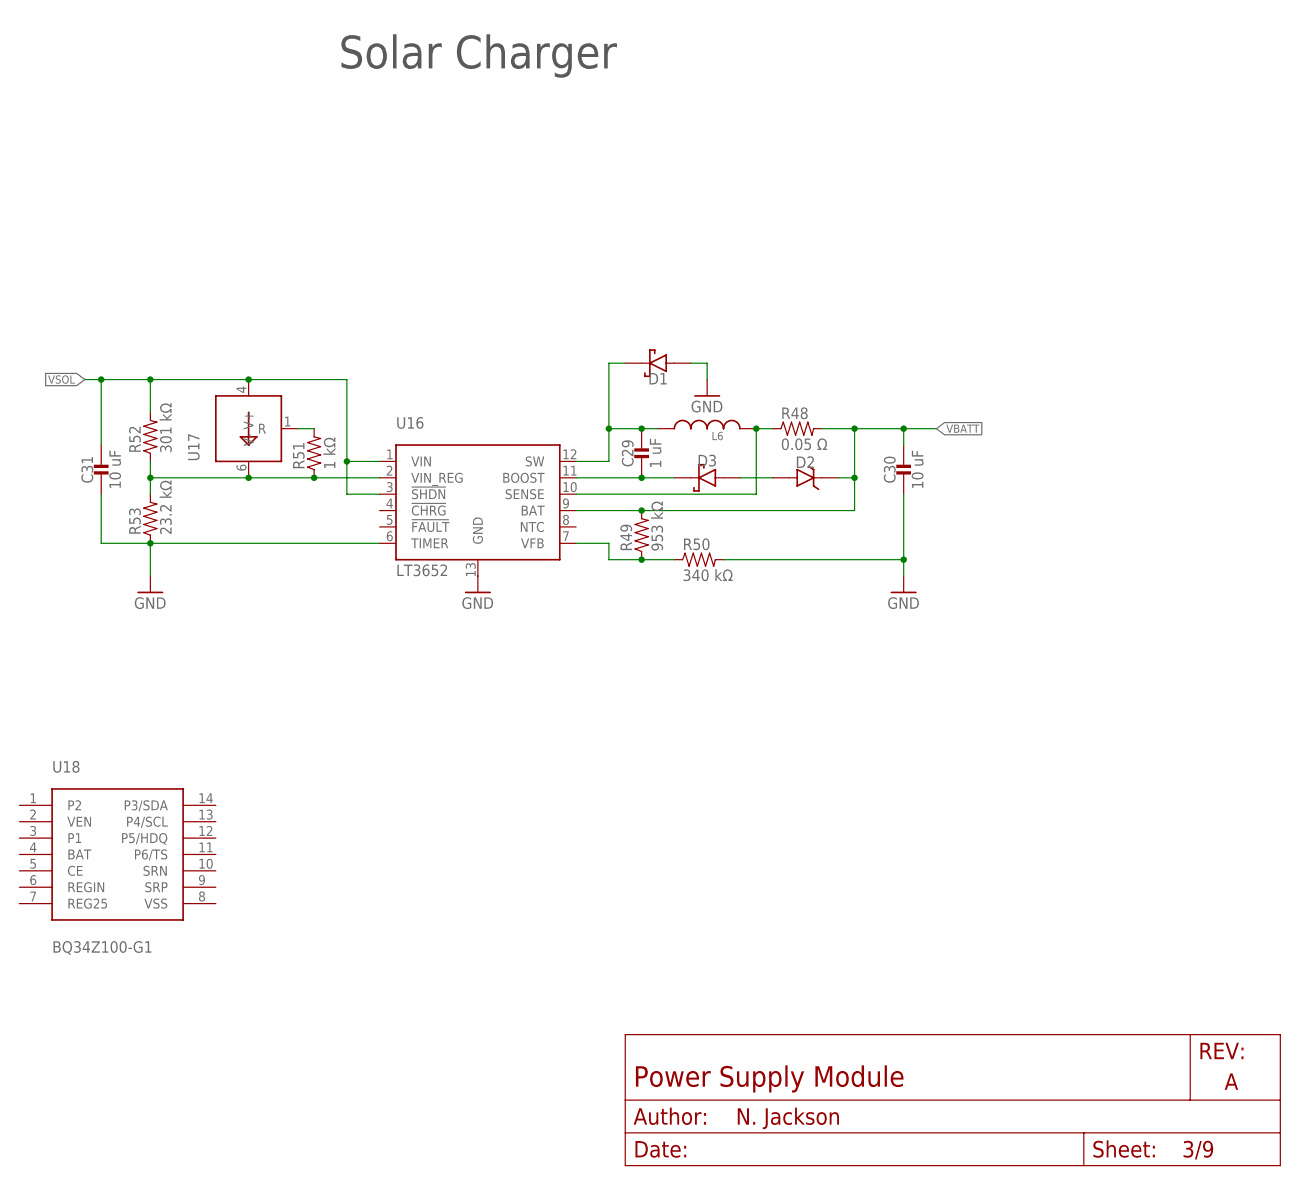
[picture p44: schematic power_supply_module.sch, sheet 3]

Parts:
C29: 1 uF; 0603_CAP
C30, C31: 10 uF; 0805_CAP
D1, D3: DIODE_SCHOTTKYSOT-23F; SOT-23F
D2: DIODE_ZENERSOT323; SOD323
L6: INDUCTORIHL2525CZ; IHL-2525CZ
R48: 0.05 Ω; 0805_RES
R49: 953 kΩ; 0402_RES
R50: 340 kΩ; 0402_RES
R51: 1 kΩ; 0402_RES
R52: 301 kΩ; 0402_RES
R53: 23.2 kΩ; 0402_RES
U16: LT3652; DFN-12/3MM
U17: LM234; SOIC-8
U18: BQ34Z100-G1; TSSOP-14/5MM

Connections:
BOOST: C29.2, D3.P$3 (CATHODE), U16.11 (BOOST)
GND: C30.P$2 (2), C31.P$2 (2), D1.P$1 (ANODE), R50.2, R53.1, U16.6 (TIMER), U16.13 (GND); also elsewhere on the board
unnamed: D2.P$2 (ANODE), D3.P$1 (ANODE)
unnamed: R51.2, U17.1 (R)
SENSE: L6.P$2 (2), R48.1, U16.10 (SENSE)
SW: C29.1, D1.P$3 (CATHODE), L6.P$1 (1), U16.12 (SW)
VBATT: C30.P$1 (1), D2.P$1 (CATHODE), R48.2, R49.2, U16.9 (BAT); also elsewhere on the board
VFB: R49.1, R50.1, U16.7 (VFB)
VINREG: R51.1, R52.1, R53.2, U16.2 (VIN_REG), U17.6 (V-)
VSOL: C31.P$1 (1), R52.2, U16.1 (VIN), U16.3 (!SHDN), U17.4 (V+); also elsewhere on the board

Notes on the sheet:
Solar Charger

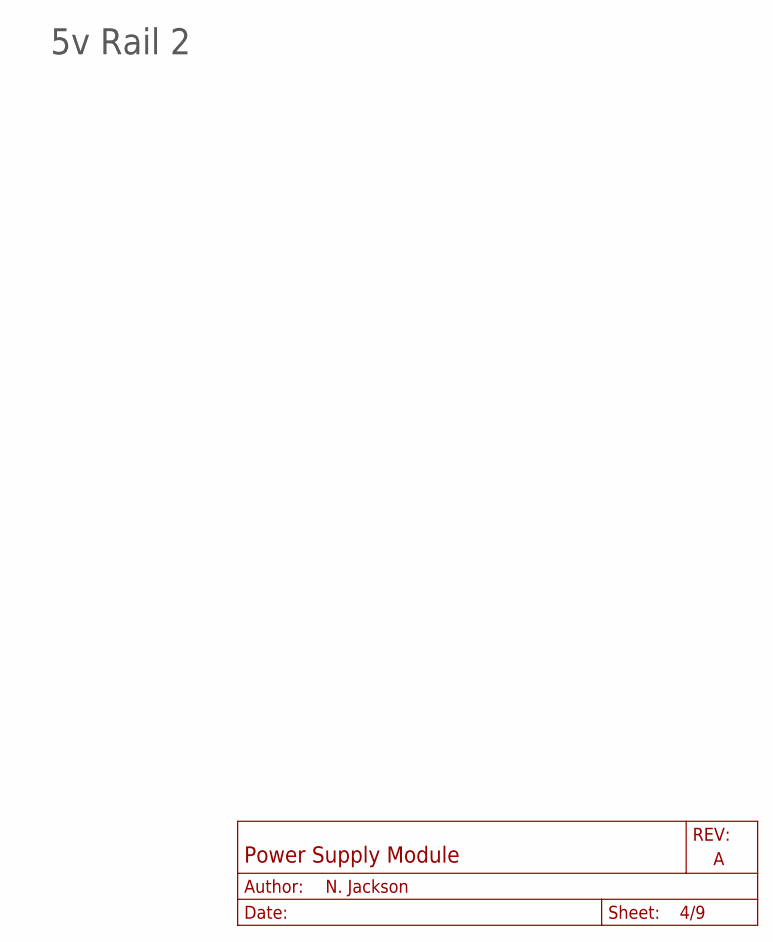
[picture p45: schematic power_supply_module.sch, sheet 4]

Notes on the sheet:
5v Rail 2

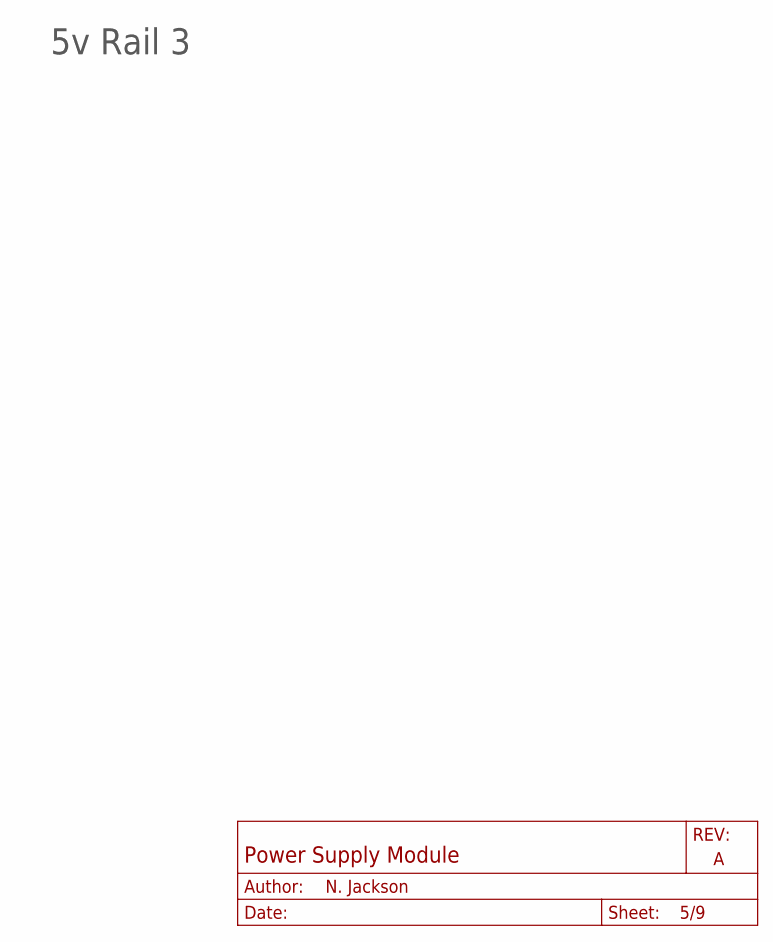
[picture p46: schematic power_supply_module.sch, sheet 5]

Notes on the sheet:
5v Rail 3

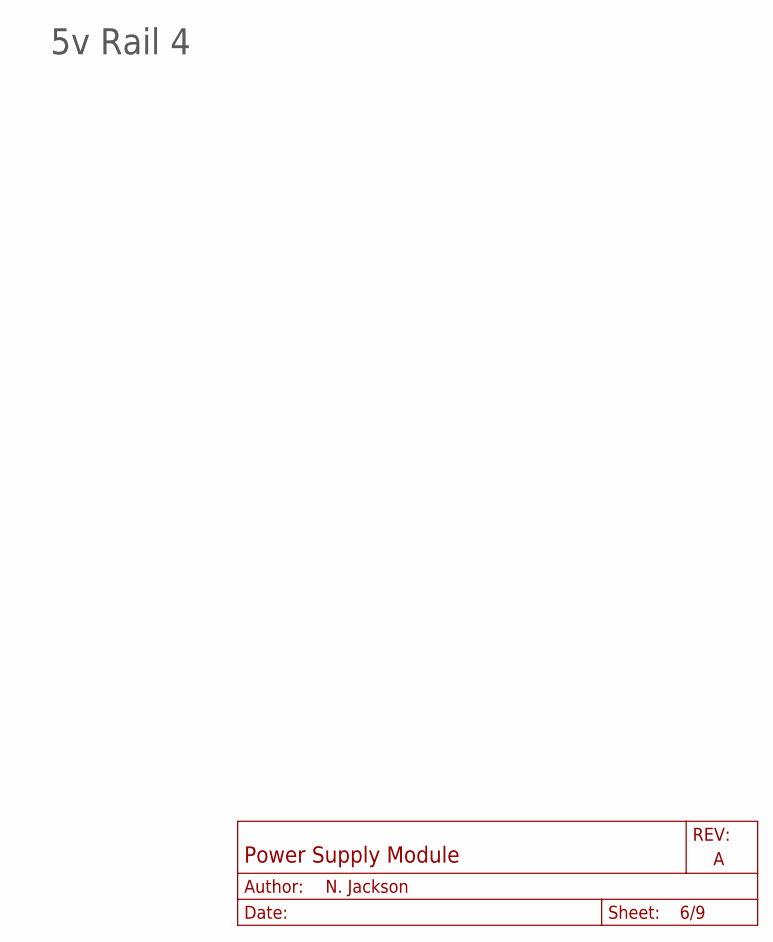
[picture p47: schematic power_supply_module.sch, sheet 6]

Notes on the sheet:
5v Rail 4

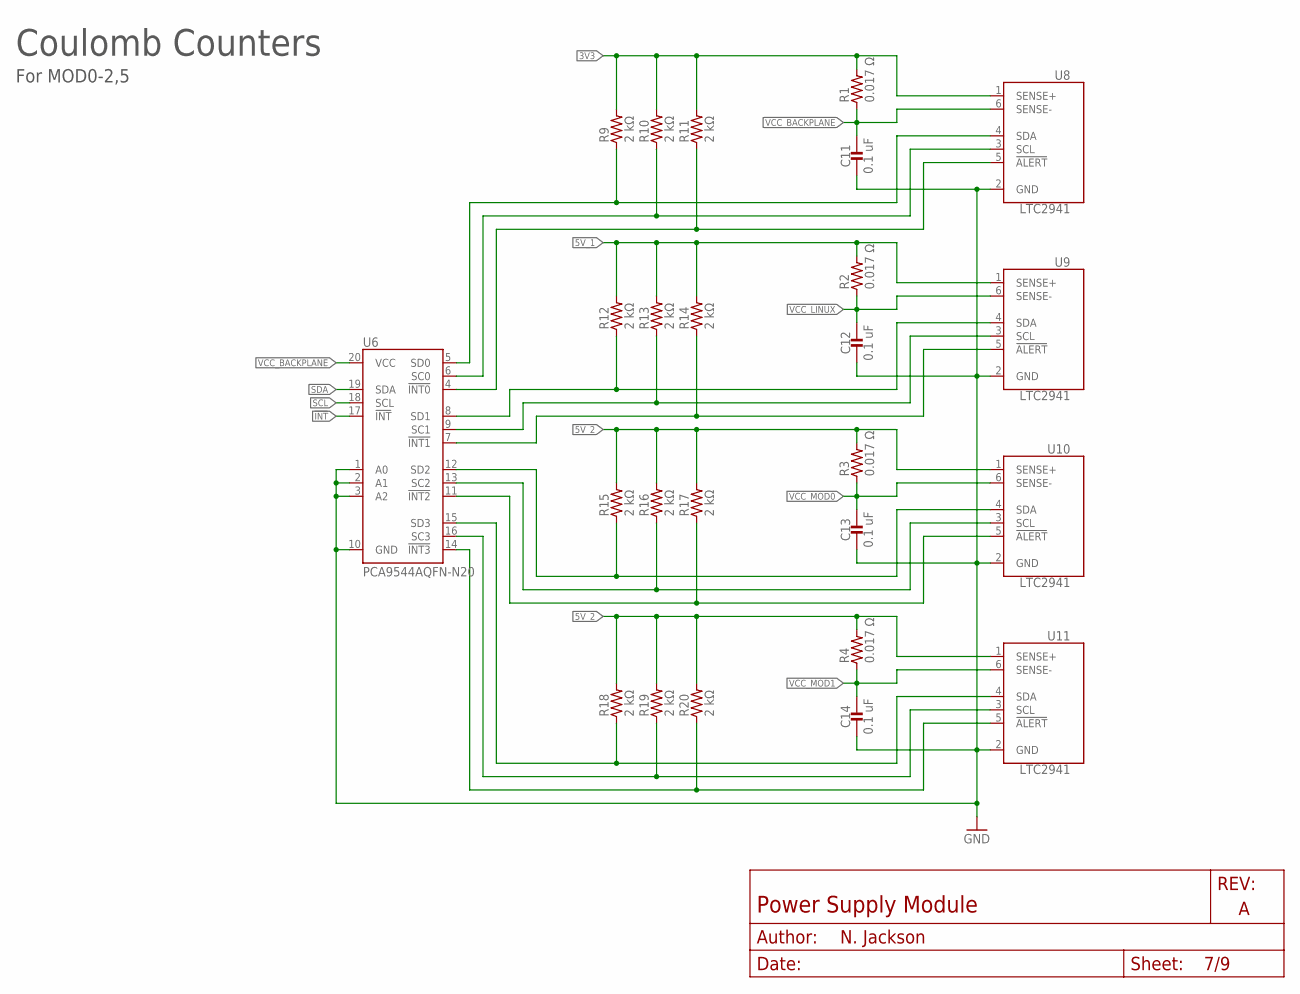
[picture p48: schematic power_supply_module.sch, sheet 7]

Parts:
C11, C12, C13, C14: 0.1 uF; 0402_CAP
R1, R2, R3, R4: 0.017 Ω; 0805_RES
R9, R10, R11, R12, R13, R14, R15, R16, R17, R18, R19, R20: 2 kΩ; 0402_RES
U6: PCA9544AQFN-N20; QFN-N20
U8, U9, U10, U11: LTC2941; DFN-6-2MMX3MM

Connections:
3V3: R1.2, R9.2, R10.2, R11.2, U8.1 (SENSE+); also elsewhere on the board
5V_1: R2.2, R12.2, R13.2, R14.2, U9.1 (SENSE+); also elsewhere on the board
5V_2: R3.2, R4.2, R15.2, R16.2, R17.2, R18.2, R19.2, R20.2, U10.1 (SENSE+), U11.1 (SENSE+); also elsewhere on the board
!INT: U6.17 (!INT); also elsewhere on the board
GND: C11.2, C12.2, C13.2, C14.2, U6.1 (A0), U6.2 (A1), U6.3 (A2), U6.10 (GND), U8.2 (GND), U9.2 (GND), U10.2 (GND), U11.2 (GND); also elsewhere on the board
unnamed: R9.1, U6.5 (SD0), U8.4 (SDA)
unnamed: R10.1, U6.6 (SC0), U8.3 (SCL)
unnamed: R15.1, U6.12 (SD2), U10.4 (SDA)
unnamed: R16.1, U6.13 (SC2), U10.3 (SCL)
unnamed: R17.1, U6.11 (!INT2), U10.5 (!ALERT)
unnamed: R18.1, U6.15 (SD3), U11.4 (SDA)
unnamed: R19.1, U6.16 (SC3), U11.3 (SCL)
unnamed: R20.1, U6.14 (!INT3), U11.5 (!ALERT)
unnamed: R11.1, U6.4 (!INT0), U8.5 (!ALERT)
unnamed: R12.1, U6.8 (SD1), U9.4 (SDA)
unnamed: R13.1, U6.9 (SC1), U9.3 (SCL)
unnamed: R14.1, U6.7 (!INT1), U9.5 (!ALERT)
SCL: U6.18 (SCL); also elsewhere on the board
SDA: U6.19 (SDA); also elsewhere on the board
VCC_BACKPLANE: C11.1, R1.1, U6.20 (VCC), U8.6 (SENSE-); also elsewhere on the board
VCC_LINUX: C12.1, R2.1, U9.6 (SENSE-); also elsewhere on the board
VCC_MOD0: C13.1, R3.1, U10.6 (SENSE-); also elsewhere on the board
VCC_MOD1: C14.1, R4.1, U11.6 (SENSE-); also elsewhere on the board

Notes on the sheet:
Coulomb Counters
For MOD0-2,5

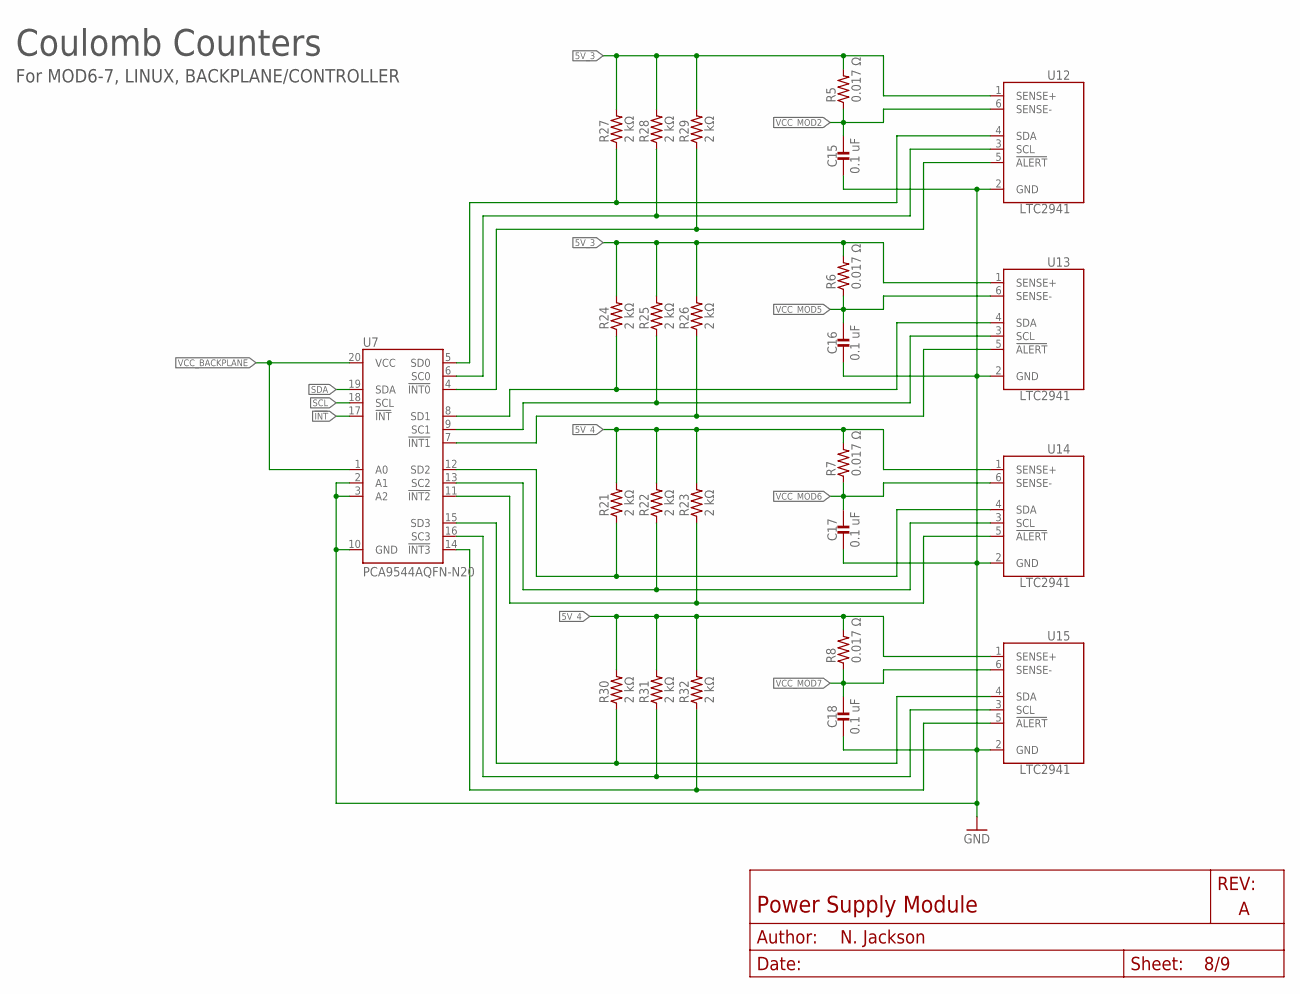
[picture p49: schematic power_supply_module.sch, sheet 8]

Parts:
C15, C16, C17, C18: 0.1 uF; 0402_CAP
R5, R6, R7, R8: 0.017 Ω; 0805_RES
R21, R22, R23, R24, R25, R26, R27, R28, R29, R30, R31, R32: 2 kΩ; 0402_RES
U7: PCA9544AQFN-N20; QFN-N20
U12, U13, U14, U15: LTC2941; DFN-6-2MMX3MM

Connections:
5V_3: R5.2, R6.2, R24.2, R25.2, R26.2, R27.2, R28.2, R29.2, U12.1 (SENSE+), U13.1 (SENSE+); also elsewhere on the board
5V_4: R7.2, R8.2, R21.2, R22.2, R23.2, R30.2, R31.2, R32.2, U14.1 (SENSE+), U15.1 (SENSE+); also elsewhere on the board
!INT: U7.17 (!INT); also elsewhere on the board
GND: C15.2, C16.2, C17.2, C18.2, U7.2 (A1), U7.3 (A2), U7.10 (GND), U12.2 (GND), U13.2 (GND), U14.2 (GND), U15.2 (GND); also elsewhere on the board
unnamed: R27.1, U7.5 (SD0), U12.4 (SDA)
unnamed: R28.1, U7.6 (SC0), U12.3 (SCL)
unnamed: R21.1, U7.12 (SD2), U14.4 (SDA)
unnamed: R22.1, U7.13 (SC2), U14.3 (SCL)
unnamed: R23.1, U7.11 (!INT2), U14.5 (!ALERT)
unnamed: R30.1, U7.15 (SD3), U15.4 (SDA)
unnamed: R31.1, U7.16 (SC3), U15.3 (SCL)
unnamed: R32.1, U7.14 (!INT3), U15.5 (!ALERT)
unnamed: R29.1, U7.4 (!INT0), U12.5 (!ALERT)
unnamed: R24.1, U7.8 (SD1), U13.4 (SDA)
unnamed: R25.1, U7.9 (SC1), U13.3 (SCL)
unnamed: R26.1, U7.7 (!INT1), U13.5 (!ALERT)
SCL: U7.18 (SCL); also elsewhere on the board
SDA: U7.19 (SDA); also elsewhere on the board
VCC_BACKPLANE: U7.1 (A0), U7.20 (VCC); also elsewhere on the board
VCC_MOD2: C15.1, R5.1, U12.6 (SENSE-); also elsewhere on the board
VCC_MOD5: C16.1, R6.1, U13.6 (SENSE-); also elsewhere on the board
VCC_MOD6: C17.1, R7.1, U14.6 (SENSE-); also elsewhere on the board
VCC_MOD7: C18.1, R8.1, U15.6 (SENSE-); also elsewhere on the board

Notes on the sheet:
Coulomb Counters
For MOD6-7, LINUX, BACKPLANE/CONTROLLER

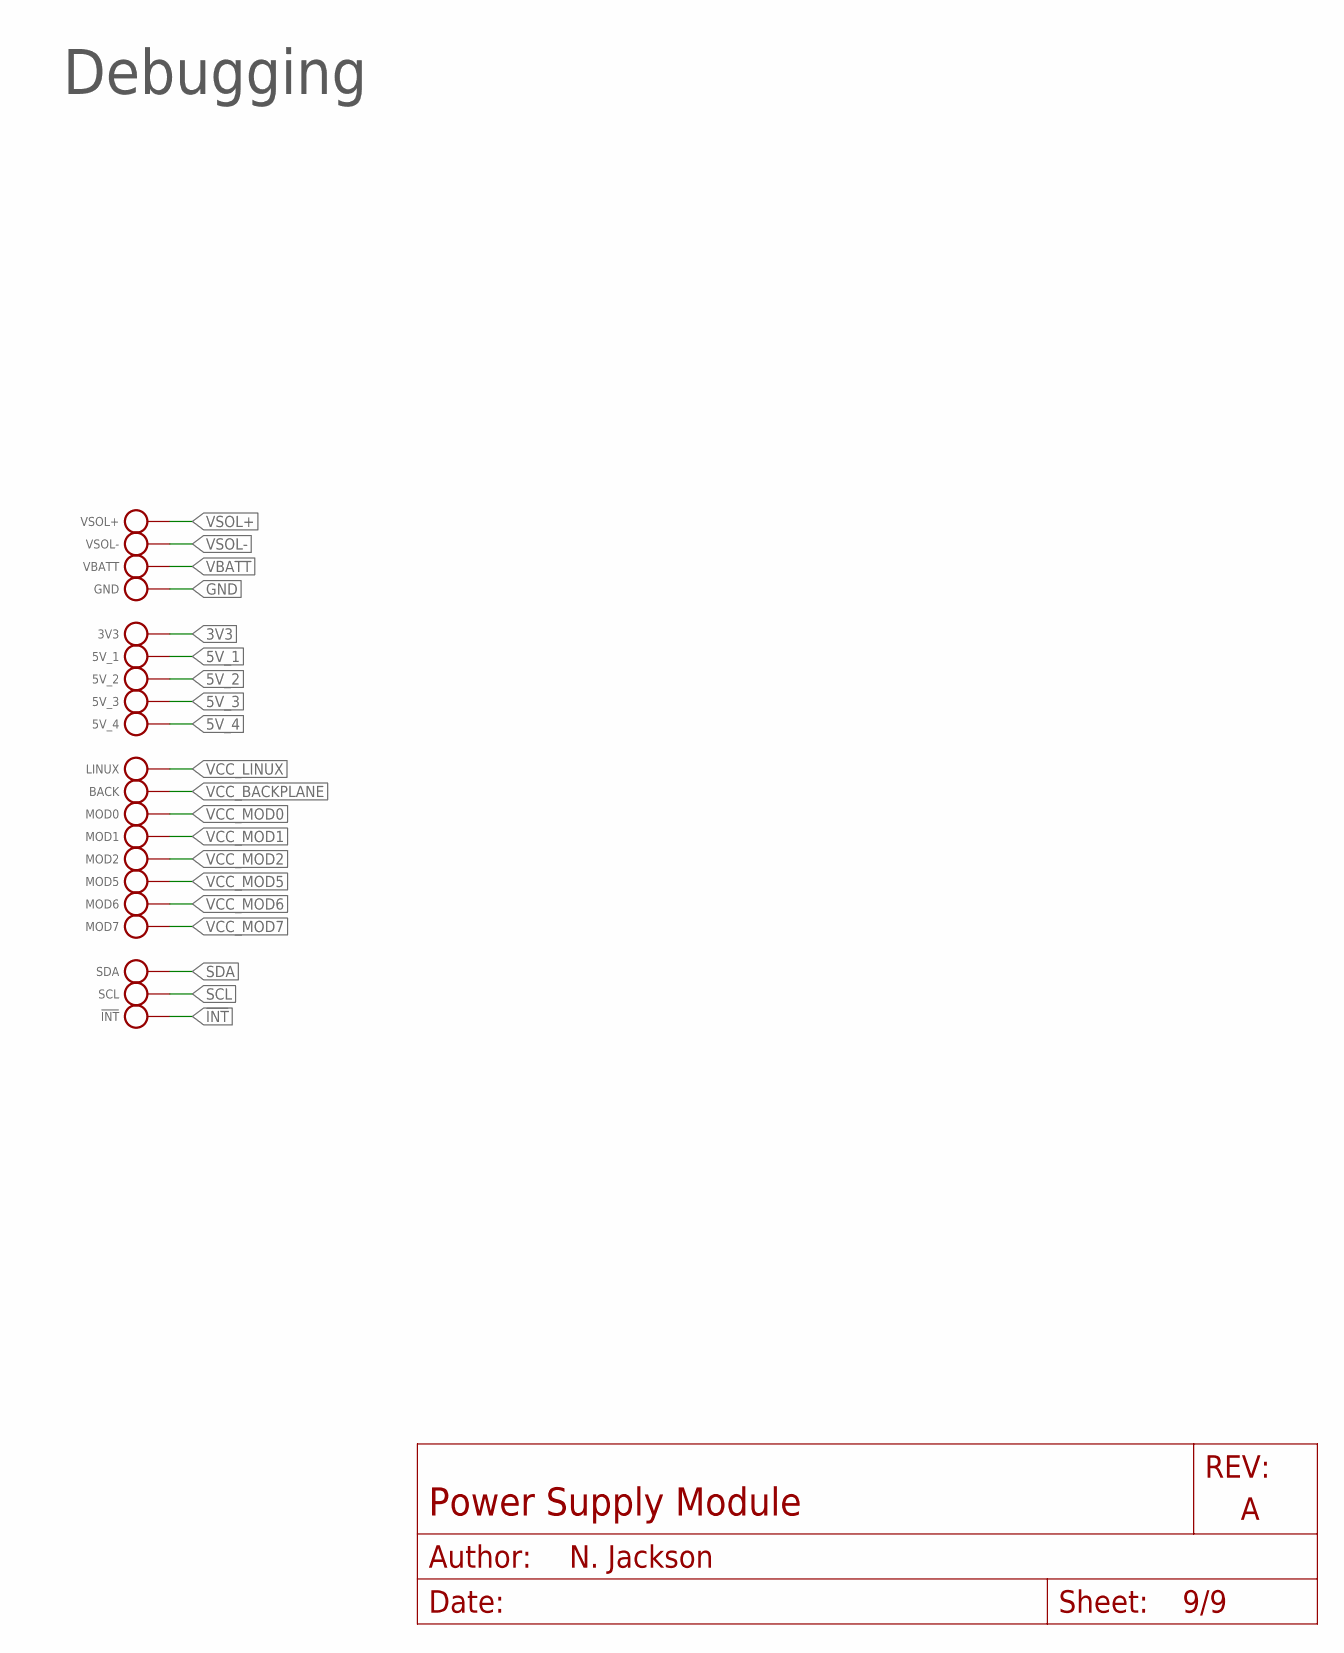
[picture p50: schematic power_supply_module.sch, sheet 9]

Parts:
3V3, 5V_1, 5V_2, 5V_3, 5V_4: TEST_POINT_0.040IN; TESTPOINT_0.040IN
!INT: TEST_POINT_0.040IN; TESTPOINT_0.040IN
BACK: TEST_POINT_0.040IN; TESTPOINT_0.040IN
GND: TEST_POINT_0.040IN; TESTPOINT_0.040IN
LINUX: TEST_POINT_0.040IN; TESTPOINT_0.040IN
MOD0, MOD1, MOD2, MOD5, MOD6, MOD7: TEST_POINT_0.040IN; TESTPOINT_0.040IN
SCL: TEST_POINT_0.040IN; TESTPOINT_0.040IN
SDA: TEST_POINT_0.040IN; TESTPOINT_0.040IN
VBATT: TEST_POINT_0.040IN; TESTPOINT_0.040IN
VSOL+: TEST_POINT_0.040IN; TESTPOINT_0.040IN
VSOL-: TEST_POINT_0.040IN; TESTPOINT_0.040IN

Connections:
3V3: 3V3.TESTPOINT; also elsewhere on the board
5V_1: 5V_1.TESTPOINT; also elsewhere on the board
5V_2: 5V_2.TESTPOINT; also elsewhere on the board
5V_3: 5V_3.TESTPOINT; also elsewhere on the board
5V_4: 5V_4.TESTPOINT; also elsewhere on the board
!INT: !INT.TESTPOINT; also elsewhere on the board
GND: GND.TESTPOINT; also elsewhere on the board
SCL: SCL.TESTPOINT; also elsewhere on the board
SDA: SDA.TESTPOINT; also elsewhere on the board
VBATT: VBATT.TESTPOINT; also elsewhere on the board
VCC_BACKPLANE: BACK.TESTPOINT; also elsewhere on the board
VCC_LINUX: LINUX.TESTPOINT; also elsewhere on the board
VCC_MOD0: MOD0.TESTPOINT; also elsewhere on the board
VCC_MOD1: MOD1.TESTPOINT; also elsewhere on the board
VCC_MOD2: MOD2.TESTPOINT; also elsewhere on the board
VCC_MOD5: MOD5.TESTPOINT; also elsewhere on the board
VCC_MOD6: MOD6.TESTPOINT; also elsewhere on the board
VCC_MOD7: MOD7.TESTPOINT; also elsewhere on the board
VSOL+: VSOL+.TESTPOINT
VSOL-: VSOL-.TESTPOINT

Notes on the sheet:
Debugging

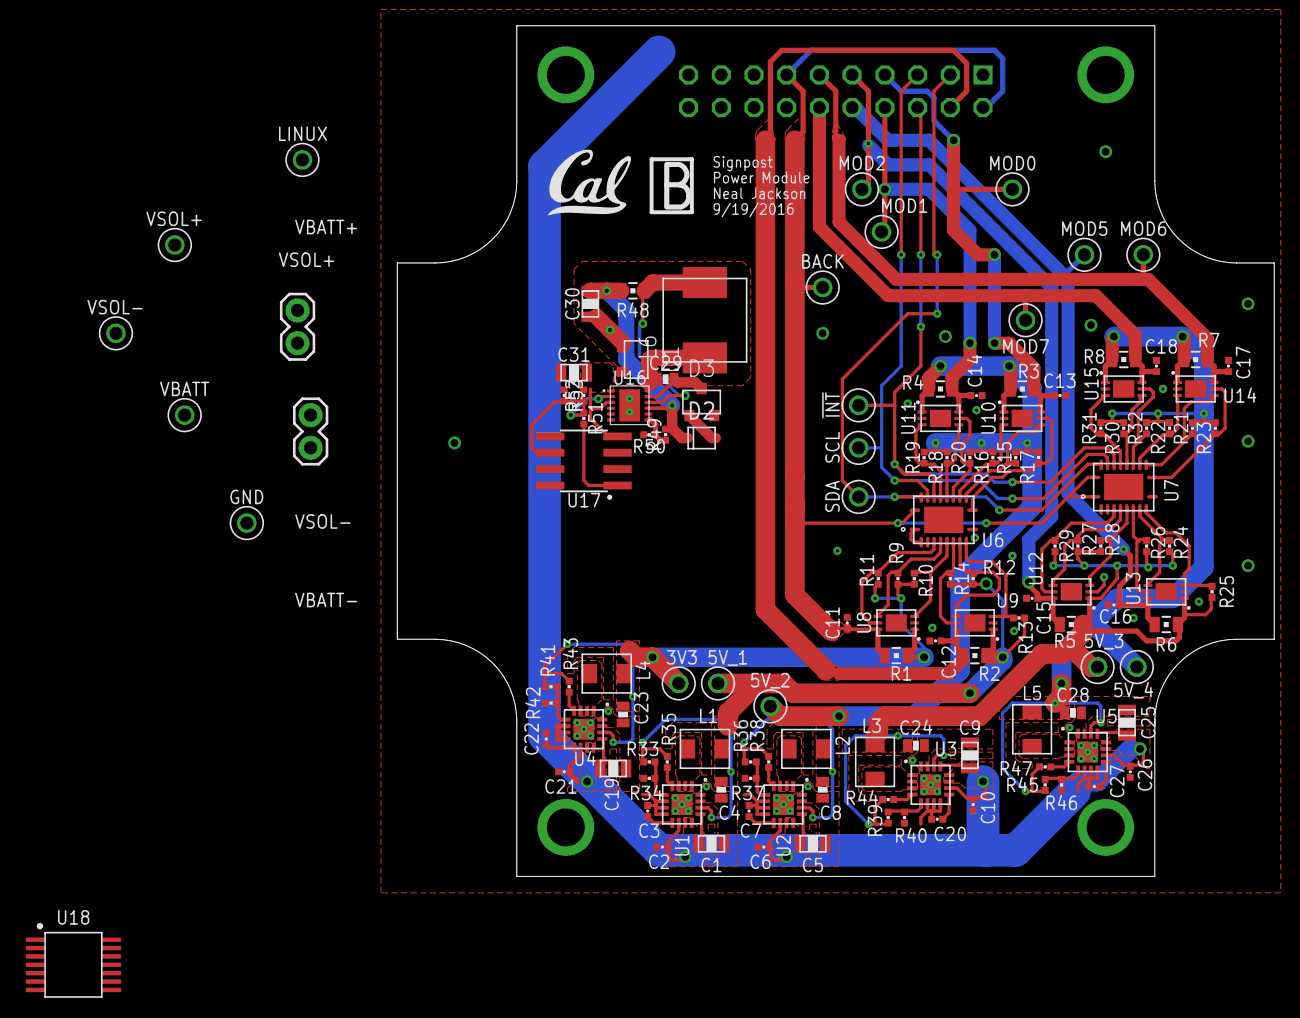
[picture p51: board power_supply_module.brd from above]

Board: 2 copper layers, 68.1 x 66.0 mm, 135 parts (0 on the bottom side), 70 nets.

Other parts of the board:
U$1: UCB_CAL_200MIL
