longle2718/signpost/hardware/radio_module/rev_b/radio_module.brd

## EAGLE design hardware/radio_module/rev_b/radio_module.brd (2017-03-07)

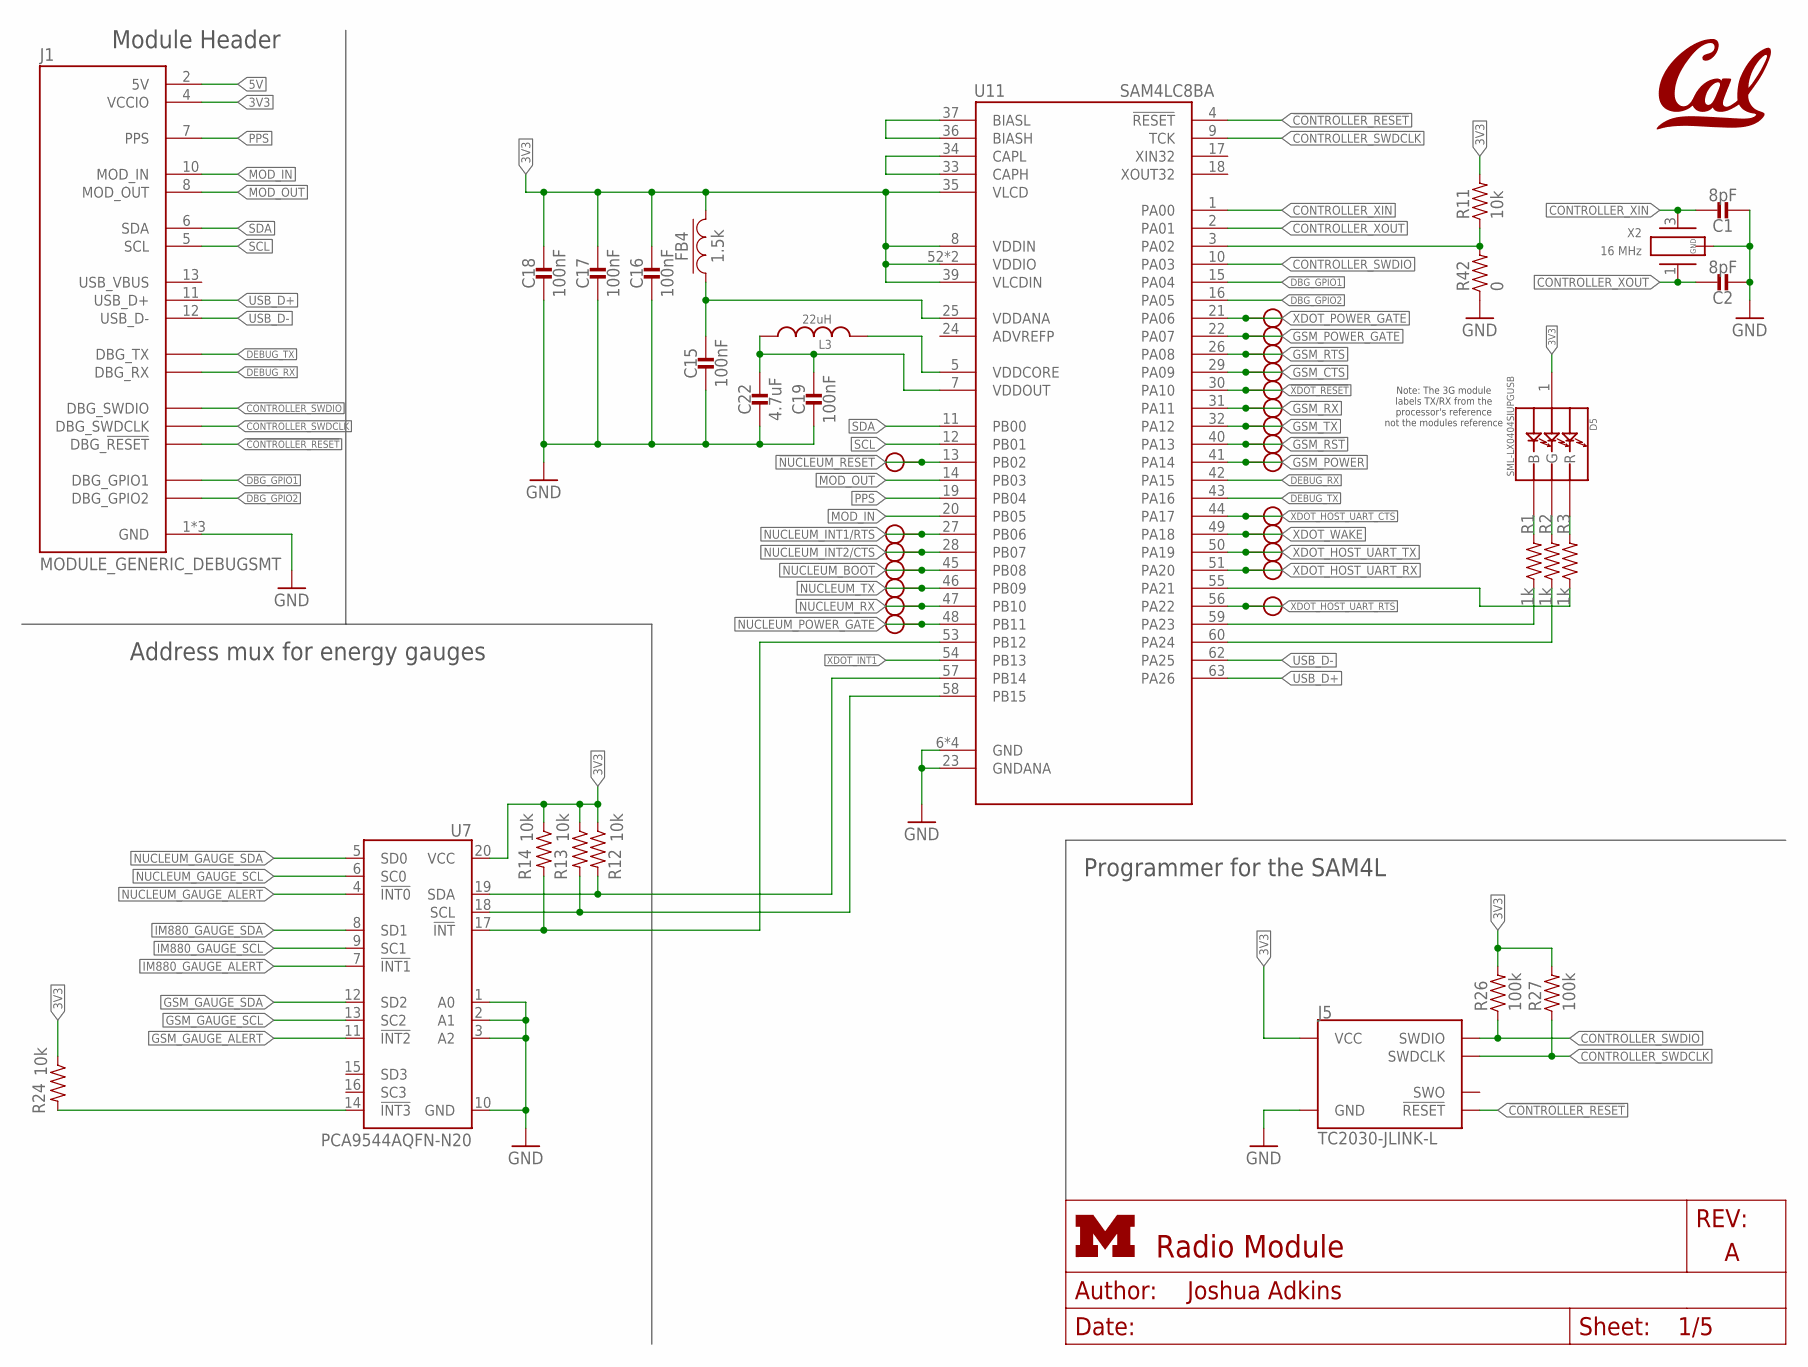
[picture p52: schematic radio_module.sch, sheet 1]

Parts:
C1, C2: 8pF; 0402_CAP; DIGIKEY 490-8230-1-ND
C15, C16, C17, C18, C19: 100nF; 0402_CAP; DIGIKEY 490-10777-1-ND
C22: 4.7uF; 0402_CAP; DIGIKEY 490-13252-1-ND
D5: SML-LX0404SIUPGUSB; 1MM_SQ_4PAD
FB4: 1.5k; 0402_CAP; DIGIKEY 490-5216-1-ND
J1: MODULE_GENERIC_DEBUGSMT; MODULE_GENERIC_DEBUG_SMT
J5: TC2030-JLINK-L; TC2030-IDC
L3: 22uH; 1212
R1, R2, R3: 1k; 0402_RES; DIGIKEY 1276-3431-1-ND
R11, R12, R13, R14, R24: 10k; 0402_RES; DIGIKEY 1276-3431-1-ND
R26, R27: 100k; 0402_RES; DIGIKEY 1276-3432-1-ND
R42: 0; 0402_RES; DIGIKEY 1276-3431-1-ND
TP1, TP2, TP3, TP4, TP5, TP6, TP7, TP9, TP10, TP11, TP12, TP13, TP18, TP19, TP21, TP22, TP23, TP24, TP25, TP26, TP27: TEST_POINT_0.040IN; TESTPOINT_0.040IN
U7: PCA9544AQFN-N20; QFN-N20
U11: SAM4LC8BA; QFN-64-9MM
U$1: UCB_CAL100MIL; UCB_CAL_100MIL
X2: 16 MHz; FHXXX

Connections:
3V3: C16.1, C17.1, C18.1, D5.1 (VDD), FB4.2, J1.4 (VCCIO), J5.1 (VCC), R11.2, R12.1, R13.1, R14.1, R24.1, R26.2, R27.2, U7.20 (VCC), U11.8 (VDDIN), U11.35 (VLCD), U11.39 (VLCDIN), U11.52 (VDDIO), U11.61 (VDDIO); also elsewhere on the board
5V: J1.2 (5V); also elsewhere on the board
!CONTROLLER_RESET: J1.20 (DBG_!RESET), J5.3 (!RESET), U11.4 (!RESET)
!GSM_RST: TP24.TESTPOINT, U11.40 (PA13); also elsewhere on the board
!NUCLEUM_RESET: TP3.TESTPOINT, U11.13 (PB02); also elsewhere on the board
!XDOT_RESET: TP7.TESTPOINT, U11.30 (PA10); also elsewhere on the board
CONTROLLER_BUCK/LDO_N: R11.1, R42.2, U11.3 (PA02)
CONTROLLER_SWDCLK: J1.21 (DBG_SWDCLK), J5.4 (SWDCLK), R27.1, U11.9 (TCK)
CONTROLLER_SWDIO: J1.22 (DBG_SWDIO), J5.2 (SWDIO), R26.1, U11.10 (PA03)
CONTROLLER_XIN: C1.1, U11.1 (PA00), X2.3 (2)
CONTROLLER_XOUT: C2.1, U11.2 (PA01), X2.1
DBG_GPIO1: J1.16 (DBG_GPIO1), U11.15 (PA04)
DBG_GPIO2: J1.19 (DBG_GPIO2), U11.16 (PA05)
DEBUG_RX: J1.18 (DBG_RX), U11.42 (PA15)
DEBUG_TX: J1.17 (DBG_TX), U11.43 (PA16)
GND: C1.2, C2.2, C15.2, C16.2, C17.2, C18.2, C19.2, C22.2, J1.1 (GND), J1.14 (GND), J1.15 (GND), J5.5 (GND), R42.1, U7.1 (A0), U7.2 (A1), U7.3 (A2), U7.10 (GND), U11.6 (GND), U11.23 (GNDANA), U11.38 (GND), U11.64 (GND), U11.GND, X2.2 (GND), X2.4 (GND); also elsewhere on the board
GSM_CTS: TP21.TESTPOINT, U11.29 (PA09); also elsewhere on the board
GSM_GAUGE_ALERT: U7.11 (!INT2); also elsewhere on the board
GSM_GAUGE_SCL: U7.13 (SC2); also elsewhere on the board
GSM_GAUGE_SDA: U7.12 (SD2); also elsewhere on the board
GSM_POWER: TP25.TESTPOINT, U11.41 (PA14); also elsewhere on the board
GSM_POWER_GATE: TP5.TESTPOINT, U11.22 (PA07); also elsewhere on the board
GSM_RTS: TP13.TESTPOINT, U11.26 (PA08); also elsewhere on the board
GSM_RX: TP22.TESTPOINT, U11.31 (PA11); also elsewhere on the board
GSM_TX: TP23.TESTPOINT, U11.32 (PA12); also elsewhere on the board
IM880_GAUGE_ALERT: U7.7 (!INT1); also elsewhere on the board
IM880_GAUGE_SCL: U7.9 (SC1); also elsewhere on the board
IM880_GAUGE_SDA: U7.8 (SD1); also elsewhere on the board
MOD_IN: J1.10 (MOD_IN), U11.20 (PB05)
MOD_OUT: J1.8 (MOD_OUT), U11.14 (PB03)
unnamed: R14.2, U7.17 (!INT), U11.53 (PB12)
unnamed: R24.2, U7.14 (!INT3)
unnamed: R1.1, U11.59 (PA23)
unnamed: D5.3 (B), R1.2
unnamed: D5.4 (G), R2.2
unnamed: D5.2 (R), R3.2
unnamed: R2.1, U11.60 (PA24)
unnamed: R3.1, U11.55 (PA21)
unnamed: C15.1, FB4.1, U11.25 (VDDANA)
unnamed: C19.1, C22.1, L3.P$1 (1), U11.7 (VDDOUT)
unnamed: L3.P$2 (2), U11.5 (VDDCORE)
unnamed: U11.36 (BIASH), U11.37 (BIASL)
unnamed: U11.33 (CAPH), U11.34 (CAPL)
NUCLEUM_BOOT: TP11.TESTPOINT, U11.45 (PB08); also elsewhere on the board
NUCLEUM_GAUGE_ALERT: U7.4 (!INT0); also elsewhere on the board
NUCLEUM_GAUGE_SCL: U7.6 (SC0); also elsewhere on the board
NUCLEUM_GAUGE_SDA: U7.5 (SD0); also elsewhere on the board
NUCLEUM_INT1/RTS: TP9.TESTPOINT, U11.27 (PB06); also elsewhere on the board
NUCLEUM_INT2/CTS: TP10.TESTPOINT, U11.28 (PB07); also elsewhere on the board
NUCLEUM_POWER_GATE: TP19.TESTPOINT, U11.48 (PB11); also elsewhere on the board
NUCLEUM_RX: TP18.TESTPOINT, U11.47 (PB10); also elsewhere on the board
NUCLEUM_TX: TP12.TESTPOINT, U11.46 (PB09); also elsewhere on the board
PPS: J1.7 (PPS), U11.19 (PB04)
SCL: J1.5 (SCL), U11.12 (PB01)
SCL_INTERNAL: R13.2, U7.18 (SCL), U11.58 (PB15)
SDA: J1.6 (SDA), U11.11 (PB00)
SDA_INTERNAL: R12.2, U7.19 (SDA), U11.57 (PB14)
USB_D+: J1.11 (USB_D+), U11.63 (PA26)
USB_D-: J1.12 (USB_D-), U11.62 (PA25)
XDOT_HOST_UART_CTS: TP27.TESTPOINT, U11.44 (PA17); also elsewhere on the board
XDOT_HOST_UART_RTS: TP26.TESTPOINT, U11.56 (PA22); also elsewhere on the board
XDOT_HOST_UART_RX: TP1.TESTPOINT, U11.51 (PA20); also elsewhere on the board
XDOT_HOST_UART_TX: TP2.TESTPOINT, U11.50 (PA19); also elsewhere on the board
XDOT_INT1: U11.54 (PB13); also elsewhere on the board
XDOT_POWER_GATE: TP4.TESTPOINT, U11.21 (PA06); also elsewhere on the board
XDOT_WAKE: TP6.TESTPOINT, U11.49 (PA18); also elsewhere on the board

Notes on the sheet:
Module Header
Address mux for energy gauges
Programmer for the SAM4L
Note: The 3G module labels TX/RX from the processor's reference not the modules reference
