longle2718/signpost/hardware/radio_module/rev_b/radio_module.brd

## EAGLE design hardware/radio_module/rev_b/radio_module.brd (continued)

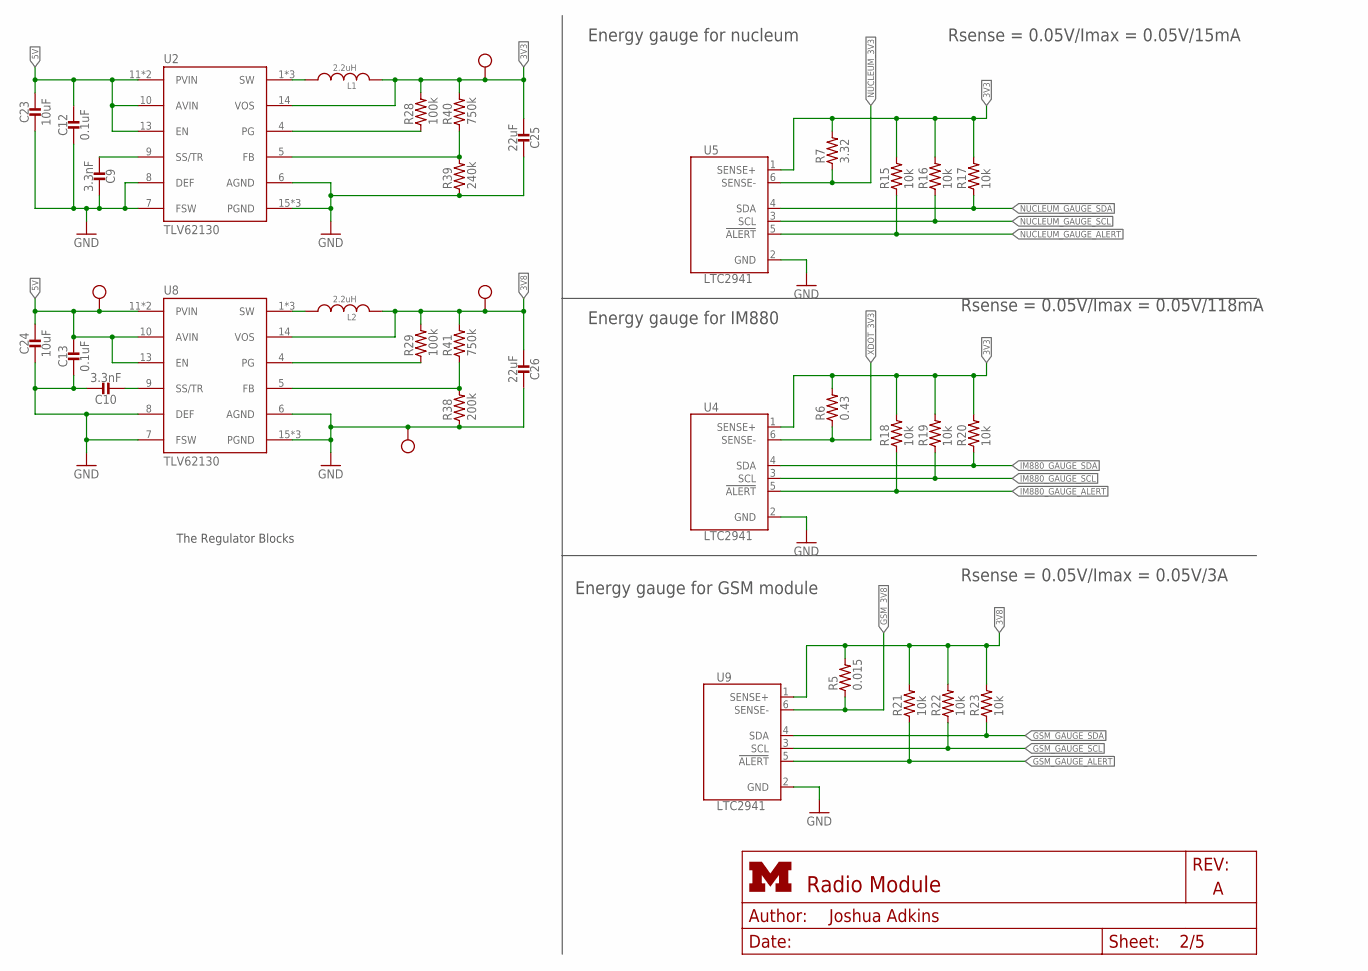
[picture p53: schematic radio_module.sch, sheet 2]

Parts:
C9, C10: 3.3nF; 0402_CAP
C12, C13: 0.1uF; 0402_CAP
C23, C24: 10uF; 0402_CAP
C25, C26: 22uF; 0402_CAP
L1, L2: 2.2uH; IHL-1212BZ-11
R5: 0.015; 0603-RES
R6: 0.43; 0402_RES
R7: 3.32; 0402_RES
R15, R16, R17, R18, R19, R20, R21, R22, R23: 10k; 0402_RES
R28, R29: 100k; 0402_RES
R38: 200k; 0402_RES
R39: 240k; 0402_RES
R40, R41: 750k; 0402_RES
TP14, TP15, TP16, TP17: TEST_POINT_0.040IN; TESTPOINT_0.040IN
U2, U8: TLV62130; TQFN-16/3MM
U4, U5, U9: LTC2941; DFN-6-2MMX3MM

Connections:
3V3: C25.2, L1.P$2 (2), R6.2, R7.2, R15.2, R16.2, R17.2, R18.2, R19.2, R20.2, R28.2, R40.2, TP17.TESTPOINT, U2.14 (VOS), U4.1 (SENSE+), U5.1 (SENSE+); also elsewhere on the board
3V8: C26.2, L2.P$2 (2), R5.2, R21.2, R22.2, R23.2, R29.2, R41.2, TP14.TESTPOINT, U8.14 (VOS), U9.1 (SENSE+)
3V8SWOUT: L2.P$1 (1), U8.1 (SW), U8.2 (SW), U8.3 (SW)
3VSWOUT: L1.P$1 (1), U2.1 (SW), U2.2 (SW), U2.3 (SW)
5V: C12.1, C13.1, C23.1, C24.1, TP16.TESTPOINT, U2.10 (AVIN), U2.11 (PVIN), U2.12 (PVIN), U2.13 (EN), U8.10 (AVIN), U8.11 (PVIN), U8.12 (PVIN), U8.13 (EN); also elsewhere on the board
GND: C9.1, C10.1, C12.2, C13.2, C23.2, C24.2, C25.1, C26.1, R38.1, R39.1, TP15.TESTPOINT, U2.6 (AGND), U2.7 (FSW), U2.8 (DEF), U2.15 (PGND), U2.16 (PGND), U2.GND, U4.2 (GND), U5.2 (GND), U8.6 (AGND), U8.7 (FSW), U8.8 (DEF), U8.15 (PGND), U8.16 (PGND), U8.GND, U9.2 (GND); also elsewhere on the board
GSM_3V8: R5.1, U9.6 (SENSE-); also elsewhere on the board
GSM_GAUGE_ALERT: R21.1, U9.5 (!ALERT); also elsewhere on the board
GSM_GAUGE_SCL: R22.1, U9.3 (SCL); also elsewhere on the board
GSM_GAUGE_SDA: R23.1, U9.4 (SDA); also elsewhere on the board
IM880_GAUGE_ALERT: R18.1, U4.5 (!ALERT); also elsewhere on the board
IM880_GAUGE_SCL: R19.1, U4.3 (SCL); also elsewhere on the board
IM880_GAUGE_SDA: R20.1, U4.4 (SDA); also elsewhere on the board
unnamed: C9.2, U2.9 (SS/TR)
unnamed: R28.1, U2.4 (PG)
unnamed: R39.2, R40.1, U2.5 (FB)
unnamed: C10.2, U8.9 (SS/TR)
unnamed: R29.1, U8.4 (PG)
unnamed: R38.2, R41.1, U8.5 (FB)
NUCLEUM_3V3: R7.1, U5.6 (SENSE-); also elsewhere on the board
NUCLEUM_GAUGE_ALERT: R15.1, U5.5 (!ALERT); also elsewhere on the board
NUCLEUM_GAUGE_SCL: R16.1, U5.3 (SCL); also elsewhere on the board
NUCLEUM_GAUGE_SDA: R17.1, U5.4 (SDA); also elsewhere on the board
XDOT_3V3: R6.1, U4.6 (SENSE-); also elsewhere on the board

Notes on the sheet:
The Regulator Blocks
Energy gauge for nucleum
Energy gauge for IM880
Energy gauge for GSM module
Rsense = 0.05V/Imax = 0.05V/15mA
Rsense = 0.05V/Imax = 0.05V/118mA
Rsense = 0.05V/Imax = 0.05V/3A

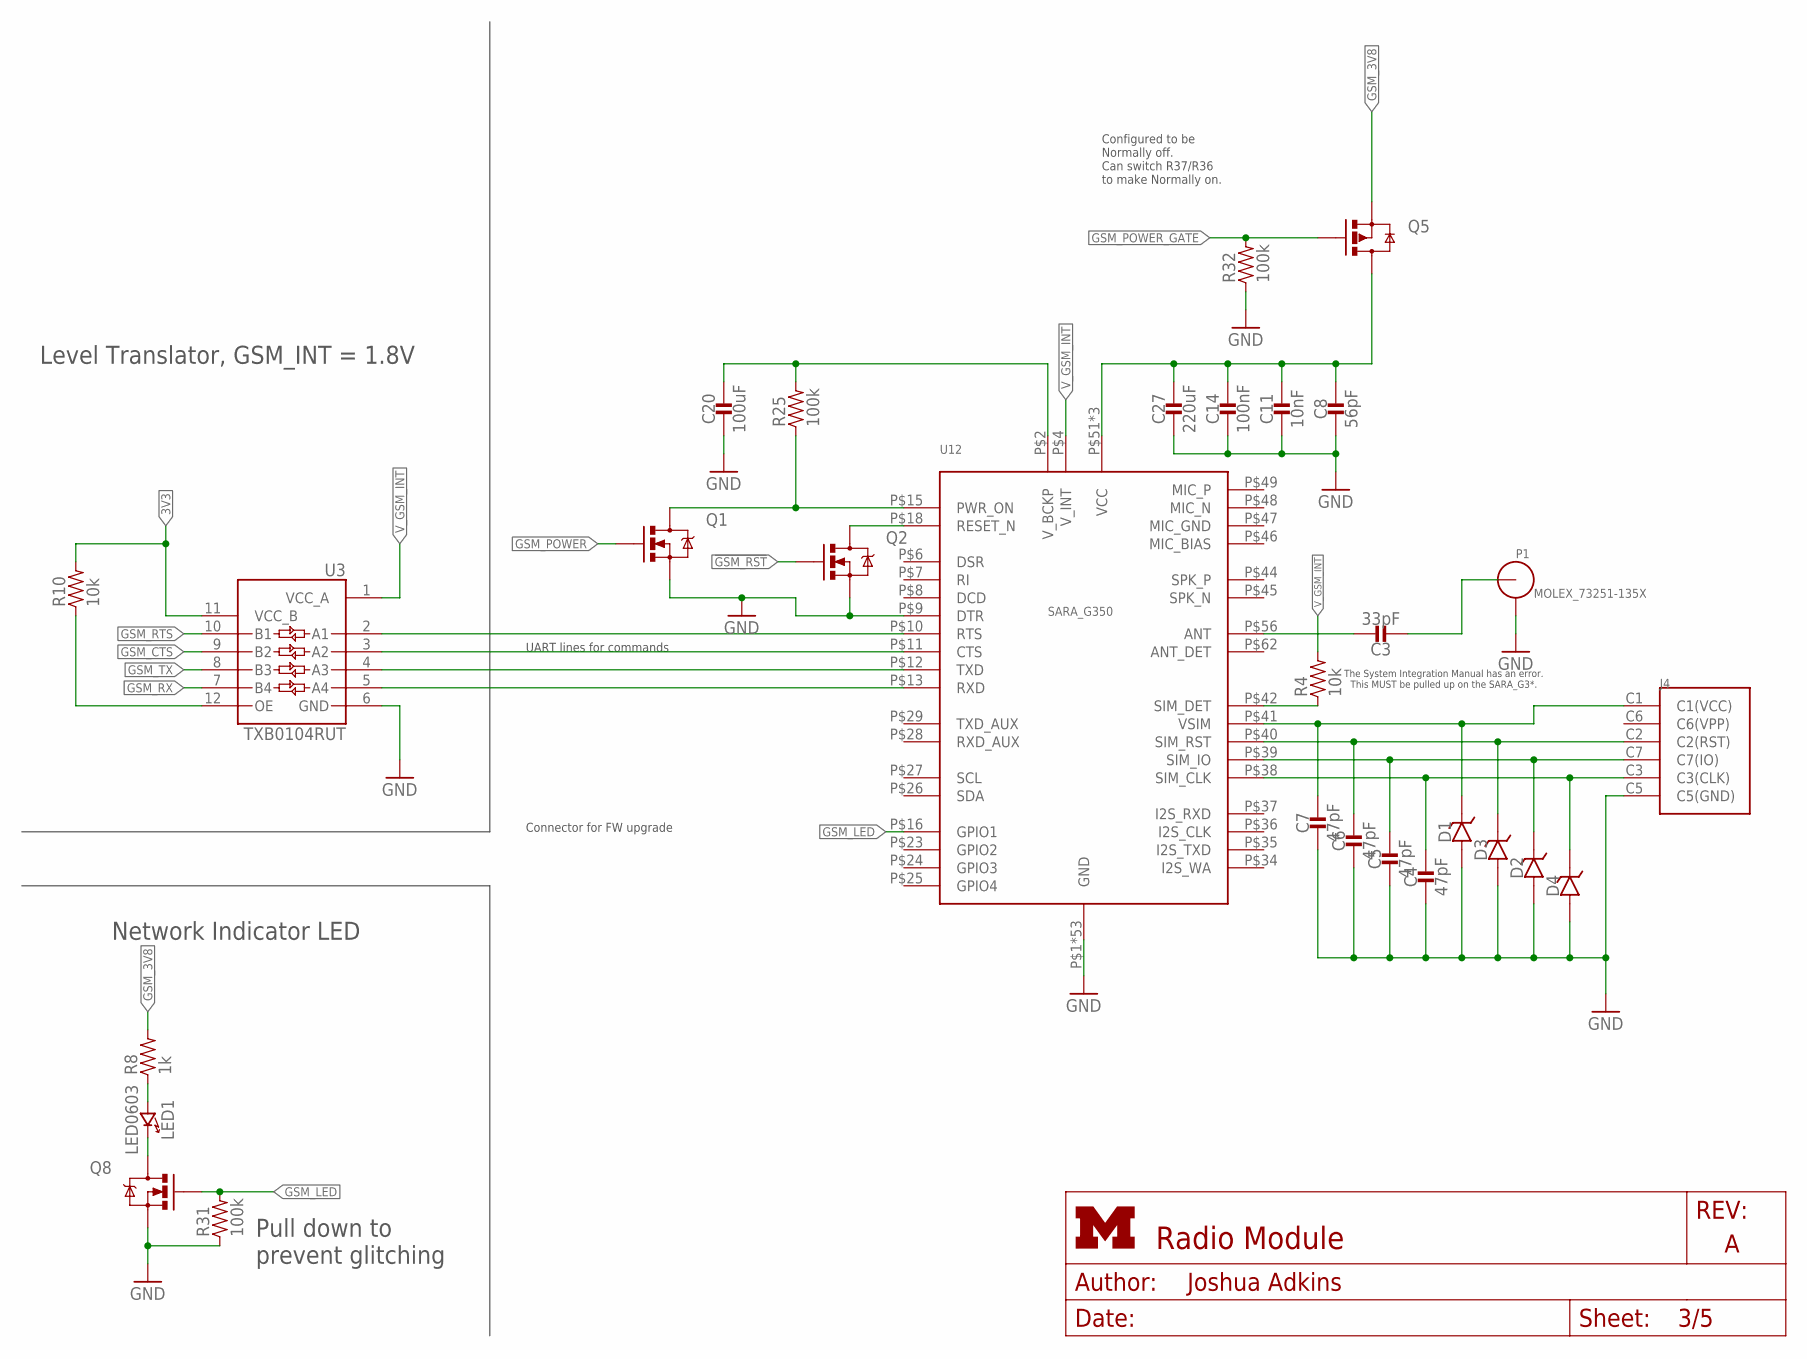
[picture p54: schematic radio_module.sch, sheet 3]

Parts:
C3: 33pF; 0603_CAP
C4, C5, C6, C7: 47pF; 0402_CAP
C8: 56pF; 0402_CAP
C11: 10nF; 0402_CAP
C14: 100nF; 0402_CAP
C20: 100uF; 0805_CAP
C27: 220uF; 1210_CAP
D1: 14V; 0402_DIODE
D2, D3, D4: DIODE_ZENER; 0402_DIODE
J4: NANO_SIM; WURTH_NANO_SIM
LED1: LED0603; LED-0603
P1: MOLEX_73251-135X; SMA-J/PCB
Q1, Q2, Q8: MOSFET-NCHANNELSMD; SOT23-3
Q5: SI223DDS; SOT23-3
R4, R10: 10k; 0402_RES
R8: 1k; 0402_RES
R25, R31, R32: 100k; 0402_RES
U3: TXB0104RUT; UQFN-12
U12: UBLOX_SARA_G350; UBLOX_SARA_G3

Connections:
3V3: R10.2, U3.11 (VCC_B); also elsewhere on the board
!GSM_RST: Q2.1 (G); also elsewhere on the board
GND: C4.2, C5.2, C6.2, C7.2, C8.2, C11.2, C14.2, C20.P$2 (2), C27.2, D1.ANODE, D2.ANODE, D3.ANODE, D4.ANODE, J4.C5 (C5(GND)), P1.2, P1.3, P1.4, P1.5, Q1.2 (S), Q2.2 (S), Q8.2 (S), R31.1, R32.1, U3.6 (GND), U12.P65 (GND), U12.P66 (GND), U12.P67 (GND), U12.P68 (GND), U12.P69 (GND), U12.P70 (GND), U12.P71 (GND), U12.P72 (GND), U12.P73 (GND), U12.P74 (GND), U12.P75 (GND), U12.P76 (GND), U12.P77 (GND), U12.P78 (GND), U12.P79 (GND), U12.P80 (GND), U12.P81 (GND), U12.P82 (GND), U12.P83 (GND), U12.P84 (GND), U12.P85 (GND), U12.P86 (GND), U12.P87 (GND), U12.P88 (GND), U12.P89 (GND), U12.P90 (GND), U12.P91 (GND), U12.P92 (GND), U12.P93 (GND), U12.P94 (GND), U12.P95 (GND), U12.P96 (GND), U12.P$1 (GND), U12.P$3 (GND), U12.P$5 (GND), U12.P$9 (DTR), U12.P$14 (GND), U12.P$20 (GND), U12.P$21 (GND), U12.P$22 (GND), U12.P$30 (GND), U12.P$32 (GND), U12.P$33 (GND), U12.P$43 (GND), U12.P$50 (GND), U12.P$54 (GND), U12.P$55 (GND), U12.P$57 (GND), U12.P$58 (GND), U12.P$59 (GND), U12.P$60 (GND), U12.P$61 (GND), U12.P$63 (GND), U12.P$64 (GND); also elsewhere on the board
GSM_3V8: Q5.2 (S), R8.2; also elsewhere on the board
GSM_CTS: U3.9 (B2); also elsewhere on the board
GSM_GATED: C8.1, C11.1, C14.1, C27.1, Q5.3 (D), U12.P$51 (VCC), U12.P$52 (VCC), U12.P$53 (VCC)
GSM_LED: Q8.1 (G), R31.2, U12.P$16 (GPIO1)
GSM_POWER: Q1.1 (G); also elsewhere on the board
GSM_POWER_GATE: Q5.1 (G), R32.2; also elsewhere on the board
GSM_RTS: U3.10 (B1); also elsewhere on the board
GSM_RX: U3.7 (B4); also elsewhere on the board
GSM_TX: U3.8 (B3); also elsewhere on the board
unnamed: C7.1, D1.CATHODE, J4.C1 (C1(VCC)), U12.P$41 (VSIM)
unnamed: C6.1, D3.CATHODE, J4.C2 (C2(RST)), U12.P$40 (SIM_RST)
unnamed: C5.1, D2.CATHODE, J4.C7 (C7(IO)), U12.P$39 (SIM_IO)
unnamed: C4.1, D4.CATHODE, J4.C3 (C3(CLK)), U12.P$38 (SIM_CLK)
unnamed: R10.1, U3.12 (OE)
unnamed: C3.1, U12.P$56 (ANT)
unnamed: C3.2, P1.1 (ANT)
unnamed: LED1.A (ANODE), R8.1
unnamed: U3.4 (A3), U12.P$12 (TXD)
unnamed: U3.5 (A4), U12.P$13 (RXD)
unnamed: LED1.C (CATHODE), Q8.3 (D)
unnamed: Q2.3 (D), U12.P$18 (RESET_N)
unnamed: C20.P$1 (1), R25.2, U12.P$2 (V_BCKP)
unnamed: Q1.3 (D), R25.1, U12.P$15 (PWR_ON)
unnamed: U3.3 (A2), U12.P$11 (CTS)
unnamed: U3.2 (A1), U12.P$10 (RTS)
unnamed: R4.1, U12.P$42 (SIM_DET)
V_GSM_INT: R4.2, U3.1 (VCC_A), U12.P$4 (V_INT)

Notes on the sheet:
Pull down to prevent glitching
Network Indicator LED
Level Translator, GSM_INT = 1.8V
UART lines for commands
Configured to be Normally off. Can switch R37/R36 to make Normally on.
Connector for FW upgrade
The System Integration Manual has an error. This MUST be pulled up on the SARA_G3*.

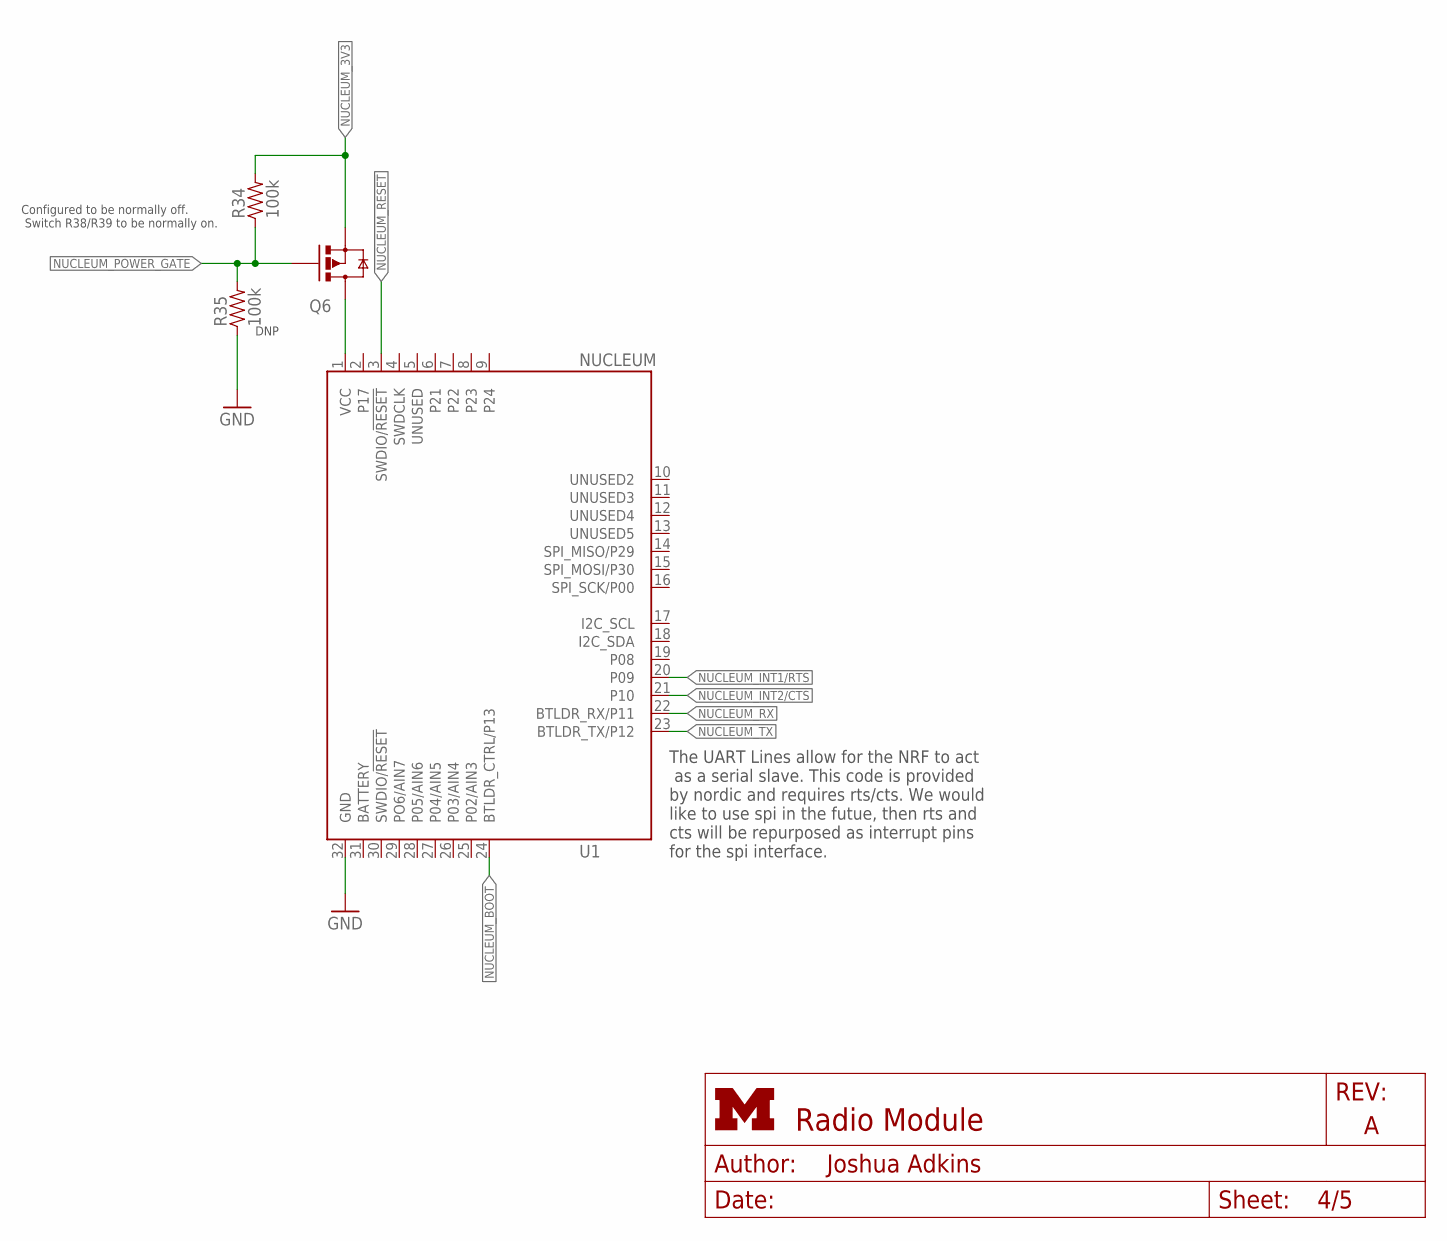
[picture p55: schematic radio_module.sch, sheet 4]

Parts:
Q6: SI223DDS; SOT23-3
R34, R35: 100k; 0402_RES
U1: NUCLEUM

Connections:
!NUCLEUM_RESET: U1.3 (SWDIO/!RESET); also elsewhere on the board
GND: R35.1, U1.32 (GND); also elsewhere on the board
unnamed: Q6.3 (D), U1.1 (VCC)
NUCLEUM_3V3: Q6.2 (S), R34.2; also elsewhere on the board
NUCLEUM_BOOT: U1.24 (BTLDR_CTRL/P13); also elsewhere on the board
NUCLEUM_INT1/RTS: U1.20 (P09); also elsewhere on the board
NUCLEUM_INT2/CTS: U1.21 (P10); also elsewhere on the board
NUCLEUM_POWER_GATE: Q6.1 (G), R34.1, R35.2; also elsewhere on the board
NUCLEUM_RX: U1.22 (BTLDR_RX/P11); also elsewhere on the board
NUCLEUM_TX: U1.23 (BTLDR_TX/P12); also elsewhere on the board

Notes on the sheet:
DNP
Configured to be normally off. Switch R38/R39 to be normally on.
The UART Lines allow for the NRF to act as a serial slave. This code is provided by nordic and requires rts/cts. We would like to use spi in the futue, then rts and cts will be repurposed as interrupt pins for the spi interface.

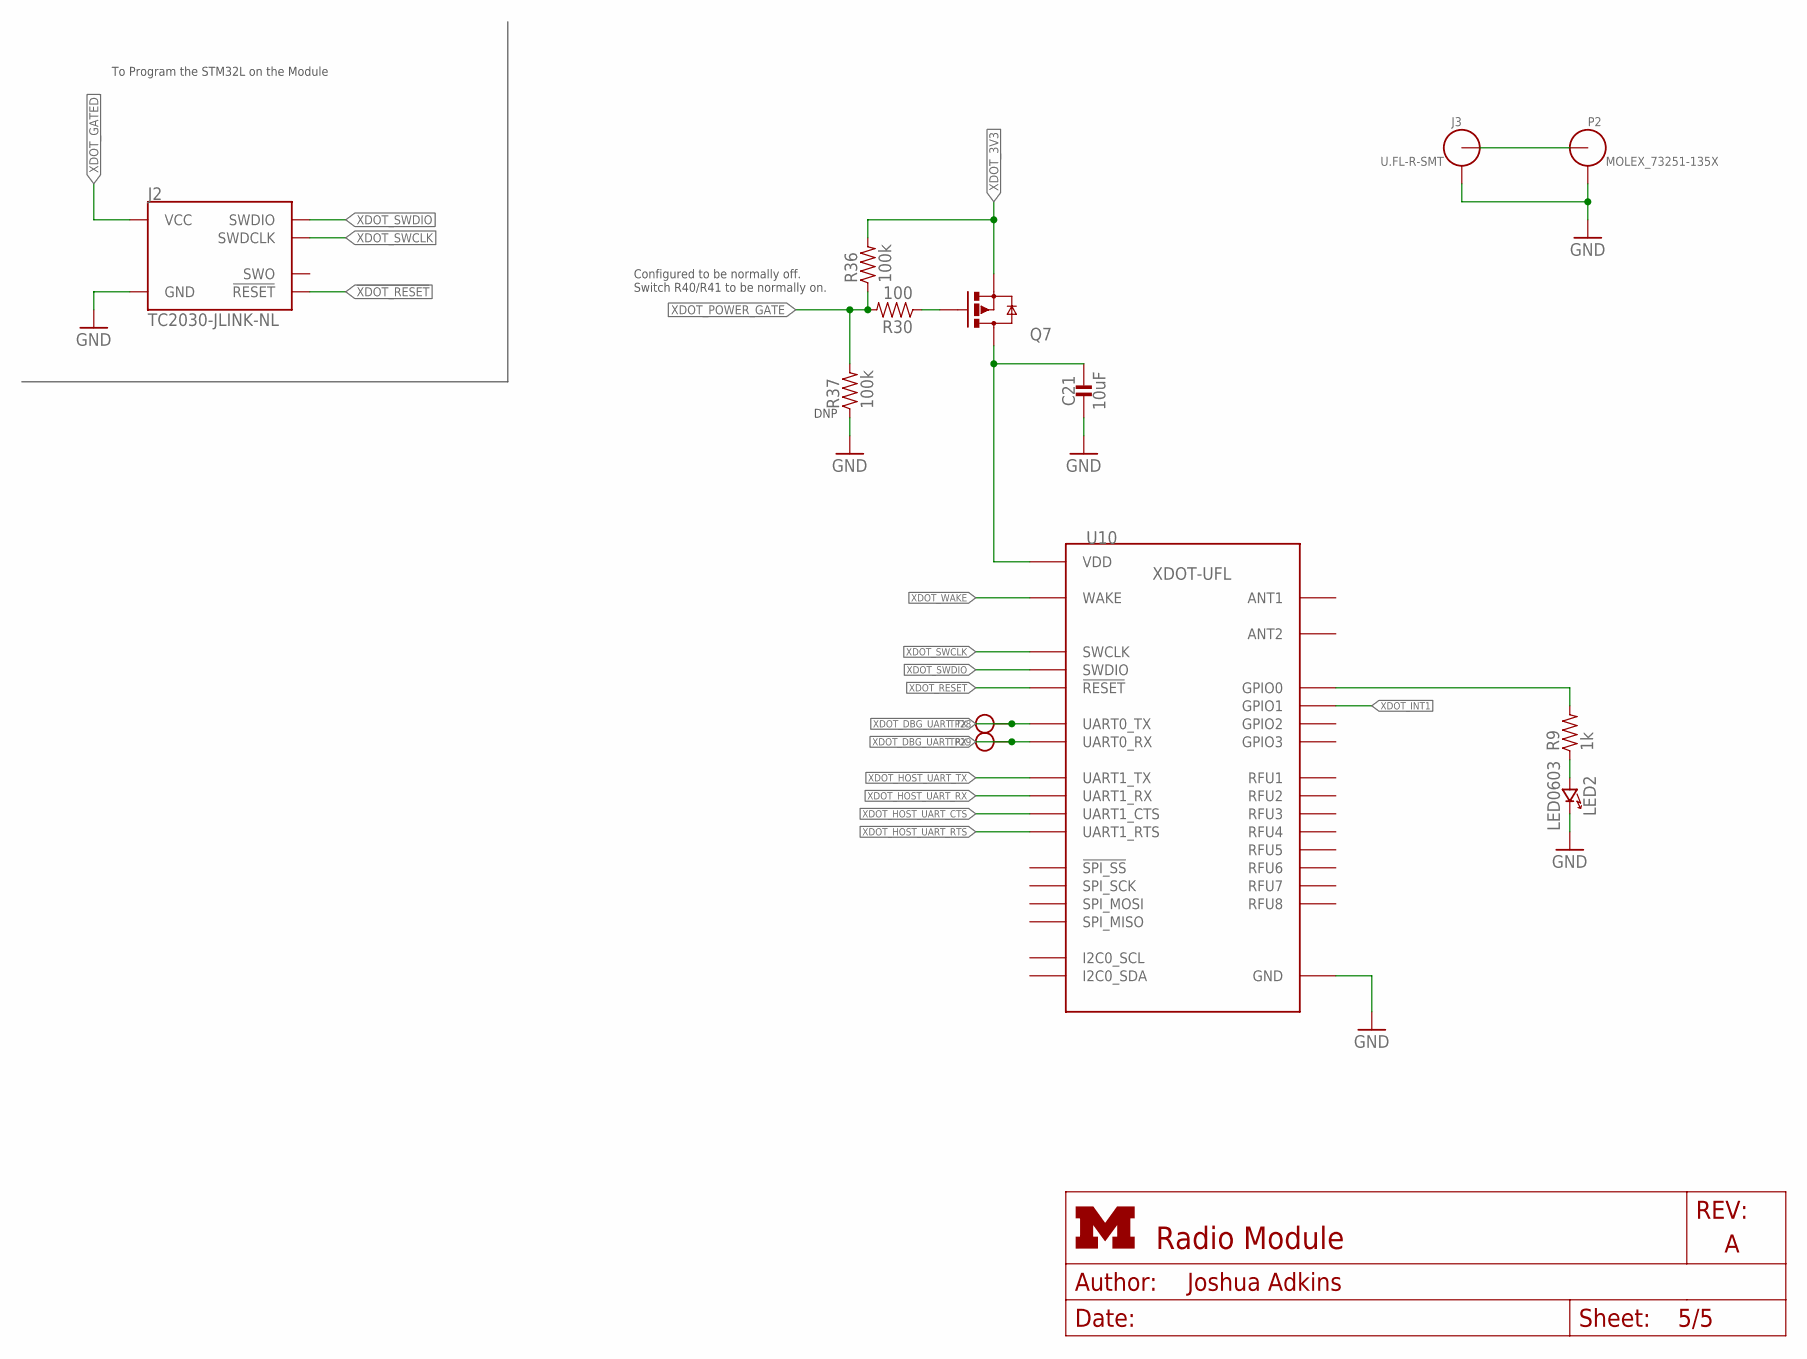
[picture p56: schematic radio_module.sch, sheet 5]

Parts:
C21: 10uF; 0402_CAP
J2: TC2030-JLINK-NL; TC2030-IDC-NL
J3: U.FL-R-SMT; U.FL_SMT
LED2: LED0603; LED-0603
P2: MOLEX_73251-135X; SMA-J/PCB
Q7: SI223DDS; SOT23-3
R9: 1k; 0402_RES
R30: 100; 0402_RES
R36, R37: 100k; 0402_RES
TP28, TP29: TEST_POINT_0.040IN; TESTPOINT_0.040IN
U10: XDOT_MODULE

Connections:
!XDOT_RESET: J2.3 (!RESET), U10.P$33 (!RESET); also elsewhere on the board
GND: C21.2, J2.5 (GND), J3.GND1, J3.GND2, LED2.C (CATHODE), P2.2, P2.3, P2.4, P2.5, R37.1, U10.P$1 (GND), U10.P$5 (GND), U10.P$17 (GND), U10.P$20 (GND), U10.P$35 (GND), U10.P$36 (GND), U10.P$38 (GND), U10.P$39 (GND), U10.P$40 (GND), U10.P$41 (GND), U10.P$42 (GND), U10.P$43 (GND), U10.P$44 (GND), U10.P$45 (GND), U10.P$46 (GND), U10.P$48 (GND), U10.P$49 (GND), U10.P$50 (GND), U10.P$51 (GND), U10.P$52 (GND), U10.P$53 (GND), U10.P$54 (GND), U10.P$55 (GND), U10.P$56 (GND), U10.P$57 (GND), U10.P$58 (GND); also elsewhere on the board
unnamed: J3.SIG (ANT), P2.1 (ANT)
unnamed: LED2.A (ANODE), R9.1
unnamed: Q7.1 (G), R30.1
XDOT_3V3: Q7.2 (S), R36.2; also elsewhere on the board
XDOT_DBG_UART_RX: TP29.TESTPOINT, U10.P$16 (UART0_RX)
XDOT_DBG_UART_TX: TP28.TESTPOINT, U10.P$15 (UART0_TX)
XDOT_GATED: C21.1, J2.1 (VCC), Q7.3 (D), U10.P$3 (VDD), U10.P$4 (VDD)
XDOT_GPIO0: R9.2, U10.P$26 (GPIO0)
XDOT_HOST_UART_CTS: U10.P$32 (UART1_CTS); also elsewhere on the board
XDOT_HOST_UART_RTS: U10.P$31 (UART1_RTS); also elsewhere on the board
XDOT_HOST_UART_RX: U10.P$14 (UART1_RX); also elsewhere on the board
XDOT_HOST_UART_TX: U10.P$13 (UART1_TX); also elsewhere on the board
XDOT_INT1: U10.P$25 (GPIO1); also elsewhere on the board
XDOT_POWER_GATE: R30.2, R36.1, R37.2; also elsewhere on the board
XDOT_SWCLK: J2.4 (SWDCLK), U10.P$29 (SWCLK)
XDOT_SWDIO: J2.2 (SWDIO), U10.P$30 (SWDIO)
XDOT_WAKE: U10.P$34 (WAKE); also elsewhere on the board

Notes on the sheet:
To Program the STM32L on the Module
DNP
Configured to be normally off. Switch R40/R41 to be normally on.

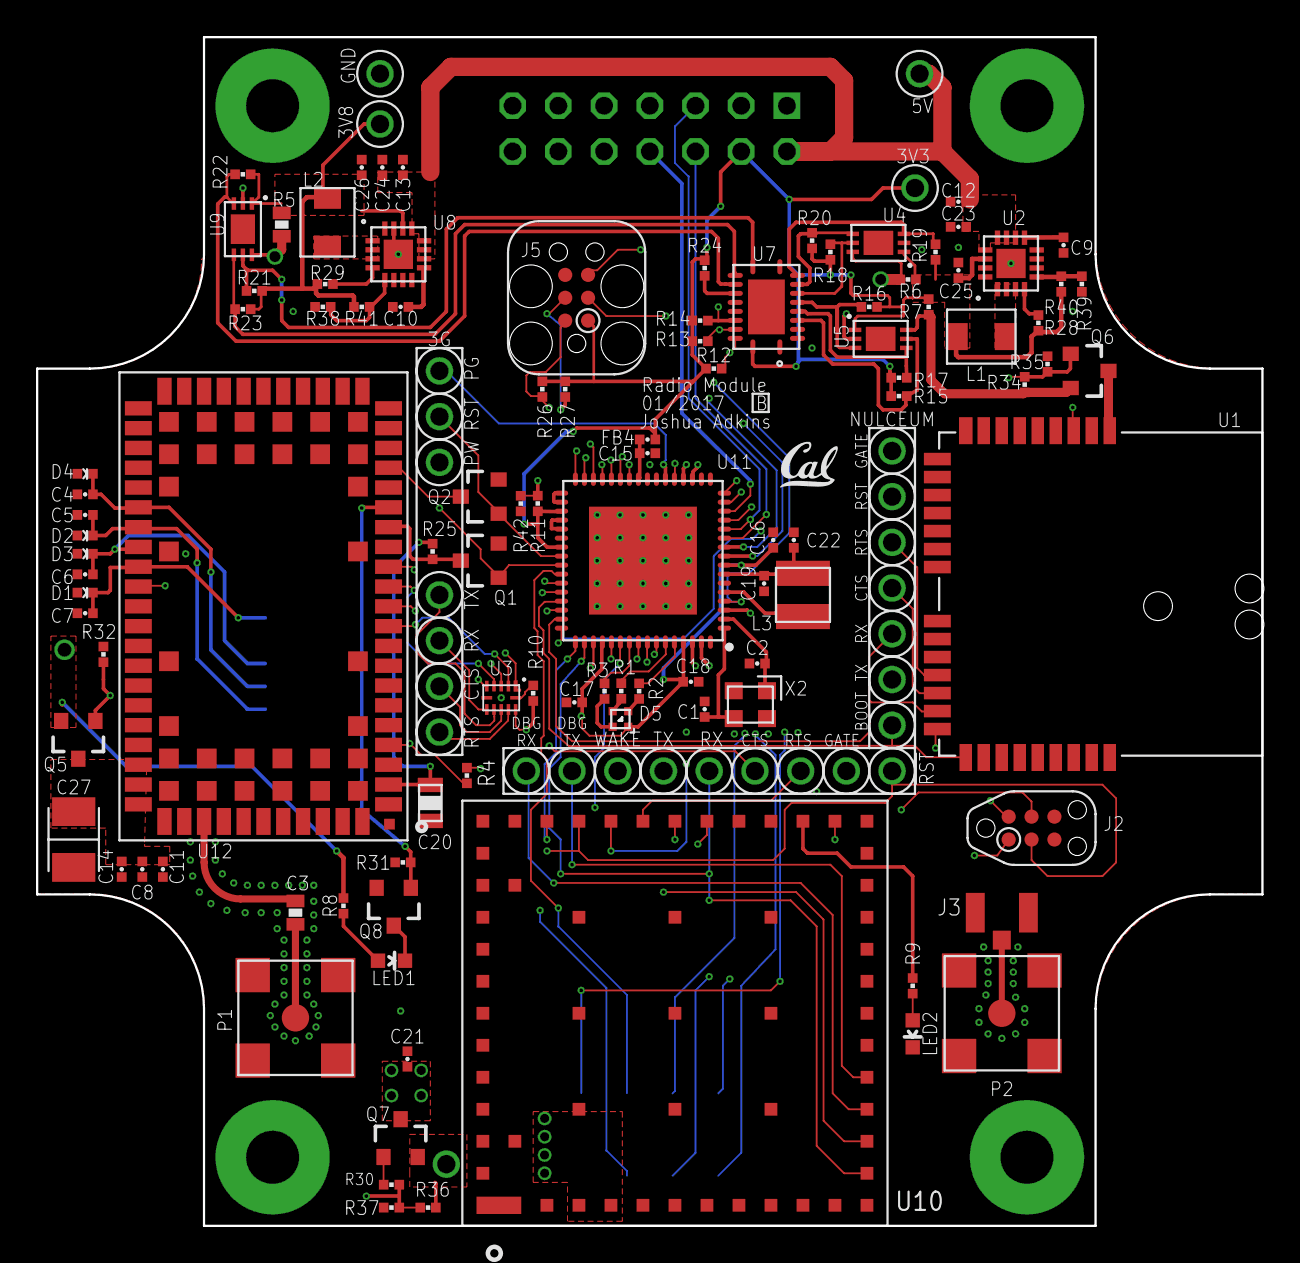
[picture p57: board hardware/radio_module/rev_b/radio_module.brd from above]

Board: 4 copper layers, 68.1 x 66.0 mm, 132 parts (1 on the bottom side), 108 nets.
