longle2718/signpost/hardware/radio_module/rev_a/radio_module.brd

## EAGLE design hardware/radio_module/rev_a/radio_module.brd (2016-09-19, an earlier design)

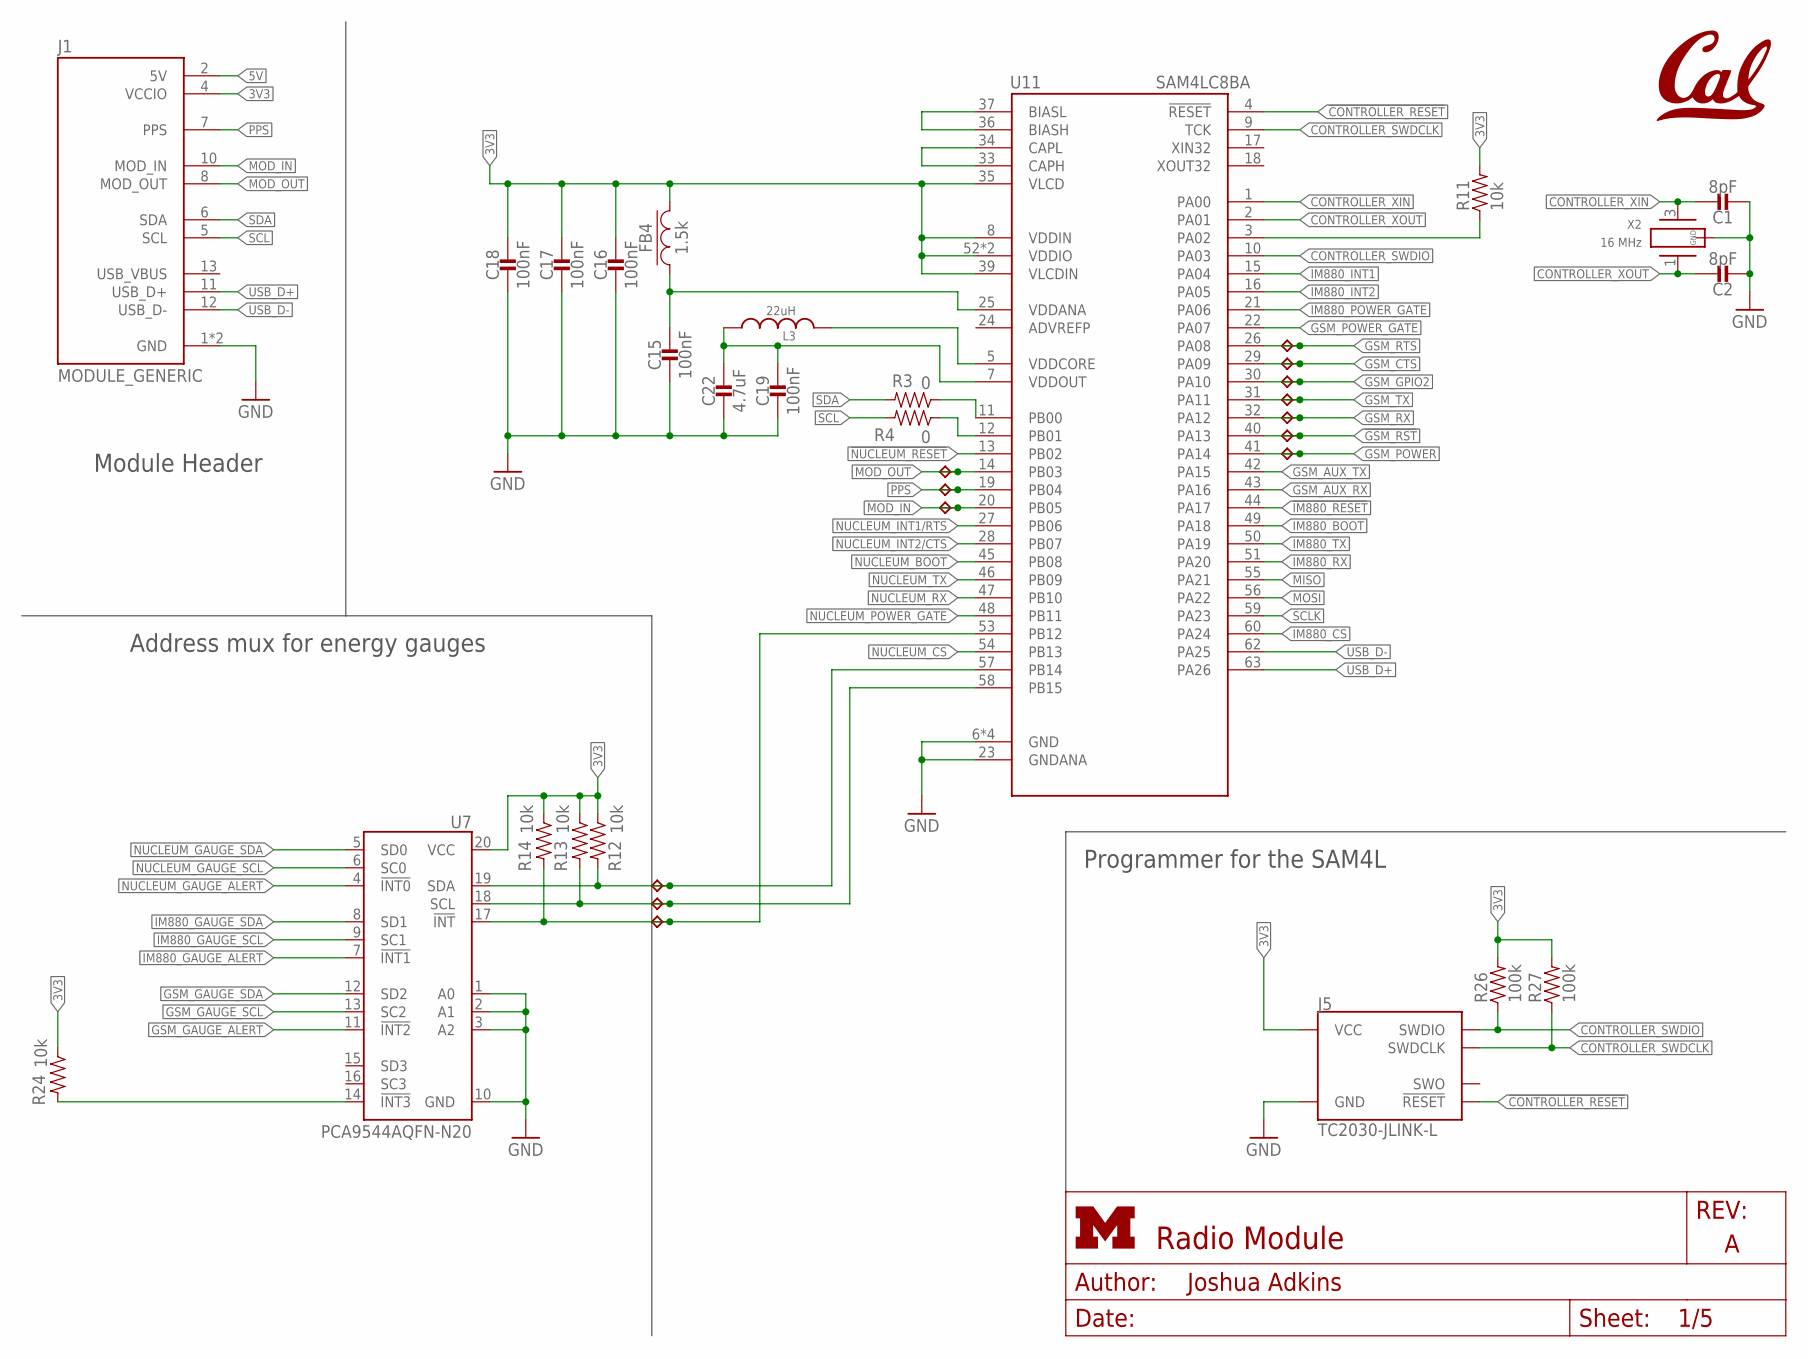
[picture p58: schematic radio_module.sch, sheet 1]

Parts:
C1, C2: 8pF; 0402_CAP; DIGIKEY 490-8230-1-ND
C15, C16, C17, C18, C19: 100nF; 0402_CAP; DIGIKEY 490-10777-1-ND
C22: 4.7uF; 0402_CAP; DIGIKEY 490-13252-1-ND
FB4: 1.5k; 0402_CAP; DIGIKEY 490-5216-1-ND
J1: MODULE_GENERIC
J5: TC2030-JLINK-L; TC2030-IDC
L3: 22uH; 1212
R3, R4: 0; 0402_RES; DIGIKEY 1276-3431-1-ND
R11, R12, R13, R14, R24: 10k; 0402_RES; DIGIKEY 1276-3431-1-ND
R26, R27: 100k; 0402_RES; DIGIKEY 1276-3432-1-ND
TP1, TP2, TP3, TP4, TP5, TP6, TP7, TP8, TP9, TP10, TP11, TP12, TP13: TPB1,27; B1,27
U7: PCA9544AQFN-N20; QFN-N20
U11: SAM4LC8BA; QFN-64-9MM
U$1: UCB_CAL100MIL; UCB_CAL_100MIL
X2: 16 MHz; FHXXX

Connections:
3V3: C16.1, C17.1, C18.1, FB4.2, J1.4 (VCCIO), J5.1 (VCC), R11.2, R12.1, R13.1, R14.1, R24.1, R26.2, R27.2, U7.20 (VCC), U11.8 (VDDIN), U11.35 (VLCD), U11.39 (VLCDIN), U11.52 (VDDIO), U11.61 (VDDIO); also elsewhere on the board
5V: J1.2 (5V); also elsewhere on the board
!CONTROLLER_RESET: J5.3 (!RESET), U11.4 (!RESET)
!GSM_RST: TP7.TP, U11.40 (PA13); also elsewhere on the board
!IM880_RESET: U11.44 (PA17); also elsewhere on the board
!NUCLEUM_RESET: U11.13 (PB02); also elsewhere on the board
ADVREFP: U11.24 (ADVREFP)
CONTROLLER_BUCK/LDO_N: R11.1, U11.3 (PA02)
CONTROLLER_SWDCLK: J5.4 (SWDCLK), R27.1, U11.9 (TCK)
CONTROLLER_SWDIO: J5.2 (SWDIO), R26.1, U11.10 (PA03)
CONTROLLER_XIN: C1.1, U11.1 (PA00), X2.3 (2)
CONTROLLER_XOUT: C2.1, U11.2 (PA01), X2.1
GND: C1.2, C2.2, C15.2, C16.2, C17.2, C18.2, C19.2, C22.2, J1.1 (GND), J1.14 (GND), J5.5 (GND), U7.1 (A0), U7.2 (A1), U7.3 (A2), U7.10 (GND), U11.6 (GND), U11.23 (GNDANA), U11.38 (GND), U11.64 (GND), U11.GND, X2.2 (GND), X2.4 (GND); also elsewhere on the board
GSM_AUX_RX: U11.43 (PA16); also elsewhere on the board
GSM_AUX_TX: U11.42 (PA15); also elsewhere on the board
GSM_CTS: TP11.TP, U11.29 (PA09); also elsewhere on the board
GSM_GAUGE_ALERT: U7.11 (!INT2); also elsewhere on the board
GSM_GAUGE_SCL: U7.13 (SC2); also elsewhere on the board
GSM_GAUGE_SDA: U7.12 (SD2); also elsewhere on the board
GSM_GPIO2: TP10.TP, U11.30 (PA10); also elsewhere on the board
GSM_POWER: TP6.TP, U11.41 (PA14); also elsewhere on the board
GSM_POWER_GATE: U11.22 (PA07); also elsewhere on the board
GSM_RTS: TP12.TP, U11.26 (PA08); also elsewhere on the board
GSM_RX: TP8.TP, U11.32 (PA12); also elsewhere on the board
GSM_TX: TP9.TP, U11.31 (PA11); also elsewhere on the board
IM880_BOOT: U11.49 (PA18); also elsewhere on the board
IM880_CS: U11.60 (PA24); also elsewhere on the board
IM880_GAUGE_ALERT: U7.7 (!INT1); also elsewhere on the board
IM880_GAUGE_SCL: U7.9 (SC1); also elsewhere on the board
IM880_GAUGE_SDA: U7.8 (SD1); also elsewhere on the board
IM880_INT1: U11.15 (PA04); also elsewhere on the board
IM880_INT2: U11.16 (PA05); also elsewhere on the board
IM880_POWER_GATE: U11.21 (PA06); also elsewhere on the board
IM880_RX: U11.51 (PA20); also elsewhere on the board
IM880_TX: U11.50 (PA19); also elsewhere on the board
MISO: U11.55 (PA21); also elsewhere on the board
MOD_IN: J1.10 (MOD_IN), TP3.TP, U11.20 (PB05)
MOD_OUT: J1.8 (MOD_OUT), TP1.TP, U11.14 (PB03)
MOSI: U11.56 (PA22); also elsewhere on the board
unnamed: R14.2, TP13.TP, U7.17 (!INT), U11.53 (PB12)
unnamed: R24.2, U7.14 (!INT3)
unnamed: R3.1, U11.11 (PB00)
unnamed: R4.1, U11.12 (PB01)
unnamed: C15.1, FB4.1, U11.25 (VDDANA)
unnamed: C19.1, C22.1, L3.P$1 (1), U11.7 (VDDOUT)
unnamed: L3.P$2 (2), U11.5 (VDDCORE)
unnamed: U11.36 (BIASH), U11.37 (BIASL)
unnamed: U11.33 (CAPH), U11.34 (CAPL)
NUCLEUM_BOOT: U11.45 (PB08); also elsewhere on the board
NUCLEUM_CS: U11.54 (PB13); also elsewhere on the board
NUCLEUM_GAUGE_ALERT: U7.4 (!INT0); also elsewhere on the board
NUCLEUM_GAUGE_SCL: U7.6 (SC0); also elsewhere on the board
NUCLEUM_GAUGE_SDA: U7.5 (SD0); also elsewhere on the board
NUCLEUM_INT1/RTS: U11.27 (PB06); also elsewhere on the board
NUCLEUM_INT2/CTS: U11.28 (PB07); also elsewhere on the board
NUCLEUM_POWER_GATE: U11.48 (PB11); also elsewhere on the board
NUCLEUM_RX: U11.47 (PB10); also elsewhere on the board
NUCLEUM_TX: U11.46 (PB09); also elsewhere on the board
PPS: J1.7 (PPS), TP2.TP, U11.19 (PB04)
SCL: J1.5 (SCL), R4.2; also elsewhere on the board
SCLK: U11.59 (PA23); also elsewhere on the board
SCL_INTERNAL: R13.2, TP5.TP, U7.18 (SCL), U11.58 (PB15)
SDA: J1.6 (SDA), R3.2; also elsewhere on the board
SDA_INTERNAL: R12.2, TP4.TP, U7.19 (SDA), U11.57 (PB14)
USB_D+: J1.11 (USB_D+), U11.63 (PA26)
USB_D-: J1.12 (USB_D-), U11.62 (PA25)

Notes on the sheet:
Module Header
Address mux for energy gauges
Programmer for the SAM4L

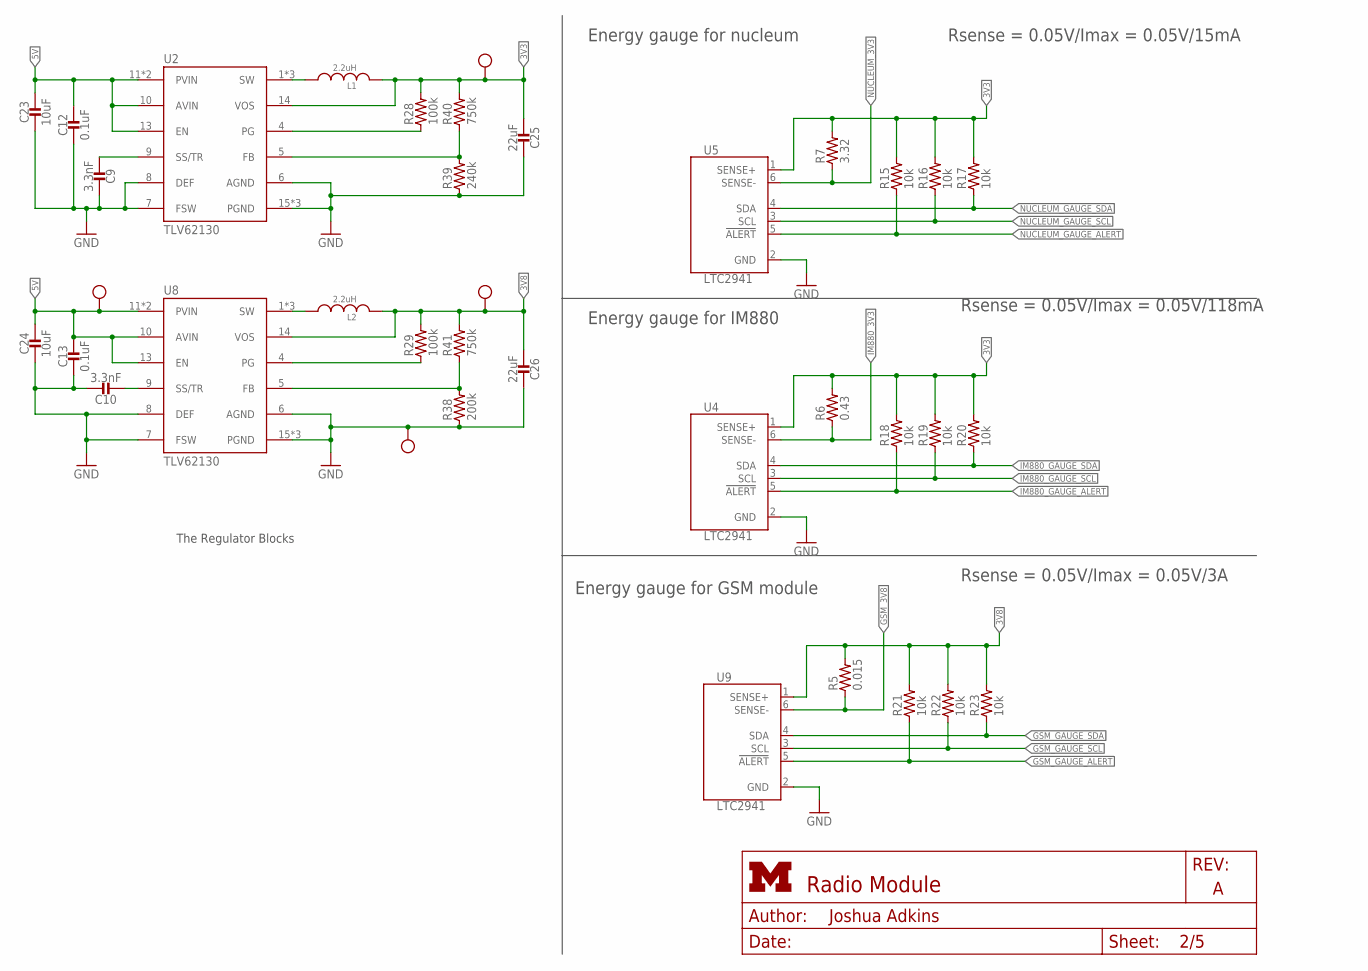
[picture p59: schematic radio_module.sch, sheet 2]

Parts:
C9, C10: 3.3nF; 0402_CAP
C12, C13: 0.1uF; 0402_CAP
C23, C24: 10uF; 0402_CAP
C25, C26: 22uF; 0402_CAP
L1, L2: 2.2uH; IHL-1212BZ-11
R5: 0.015; 0603-RES
R6: 0.43; 0402_RES
R7: 3.32; 0402_RES
R15, R16, R17, R18, R19, R20, R21, R22, R23: 10k; 0402_RES
R28, R29: 100k; 0402_RES
R38: 200k; 0402_RES
R39: 240k; 0402_RES
R40, R41: 750k; 0402_RES
TP14, TP15, TP16, TP17: TEST_POINT_0.040IN; TESTPOINT_0.040IN
U2, U8: TLV62130; TQFN-16/3MM
U4, U5, U9: LTC2941; DFN-6-2MMX3MM

Connections:
3V3: C25.2, L1.P$2 (2), R6.2, R7.2, R15.2, R16.2, R17.2, R18.2, R19.2, R20.2, R28.2, R40.2, TP17.TESTPOINT, U2.14 (VOS), U4.1 (SENSE+), U5.1 (SENSE+); also elsewhere on the board
3V8: C26.2, L2.P$2 (2), R5.2, R21.2, R22.2, R23.2, R29.2, R41.2, TP14.TESTPOINT, U8.14 (VOS), U9.1 (SENSE+)
3V8SWOUT: L2.P$1 (1), U8.1 (SW), U8.2 (SW), U8.3 (SW)
3VSWOUT: L1.P$1 (1), U2.1 (SW), U2.2 (SW), U2.3 (SW)
5V: C12.1, C13.1, C23.1, C24.1, TP16.TESTPOINT, U2.10 (AVIN), U2.11 (PVIN), U2.12 (PVIN), U2.13 (EN), U8.10 (AVIN), U8.11 (PVIN), U8.12 (PVIN), U8.13 (EN); also elsewhere on the board
GND: C9.1, C10.1, C12.2, C13.2, C23.2, C24.2, C25.1, C26.1, R38.1, R39.1, TP15.TESTPOINT, U2.6 (AGND), U2.7 (FSW), U2.8 (DEF), U2.15 (PGND), U2.16 (PGND), U2.GND, U4.2 (GND), U5.2 (GND), U8.6 (AGND), U8.7 (FSW), U8.8 (DEF), U8.15 (PGND), U8.16 (PGND), U8.GND, U9.2 (GND); also elsewhere on the board
GSM_3V8: R5.1, U9.6 (SENSE-); also elsewhere on the board
GSM_GAUGE_ALERT: R21.1, U9.5 (!ALERT); also elsewhere on the board
GSM_GAUGE_SCL: R22.1, U9.3 (SCL); also elsewhere on the board
GSM_GAUGE_SDA: R23.1, U9.4 (SDA); also elsewhere on the board
IM880_3V3: R6.1, U4.6 (SENSE-); also elsewhere on the board
IM880_GAUGE_ALERT: R18.1, U4.5 (!ALERT); also elsewhere on the board
IM880_GAUGE_SCL: R19.1, U4.3 (SCL); also elsewhere on the board
IM880_GAUGE_SDA: R20.1, U4.4 (SDA); also elsewhere on the board
unnamed: C9.2, U2.9 (SS/TR)
unnamed: R28.1, U2.4 (PG)
unnamed: R39.2, R40.1, U2.5 (FB)
unnamed: C10.2, U8.9 (SS/TR)
unnamed: R29.1, U8.4 (PG)
unnamed: R38.2, R41.1, U8.5 (FB)
NUCLEUM_3V3: R7.1, U5.6 (SENSE-); also elsewhere on the board
NUCLEUM_GAUGE_ALERT: R15.1, U5.5 (!ALERT); also elsewhere on the board
NUCLEUM_GAUGE_SCL: R16.1, U5.3 (SCL); also elsewhere on the board
NUCLEUM_GAUGE_SDA: R17.1, U5.4 (SDA); also elsewhere on the board

Notes on the sheet:
The Regulator Blocks
Energy gauge for nucleum
Energy gauge for IM880
Energy gauge for GSM module
Rsense = 0.05V/Imax = 0.05V/15mA
Rsense = 0.05V/Imax = 0.05V/118mA
Rsense = 0.05V/Imax = 0.05V/3A
