longle2718/signpost/hardware/radio_module/rev_a/radio_module.brd

## EAGLE design hardware/radio_module/rev_a/radio_module.brd (continued)

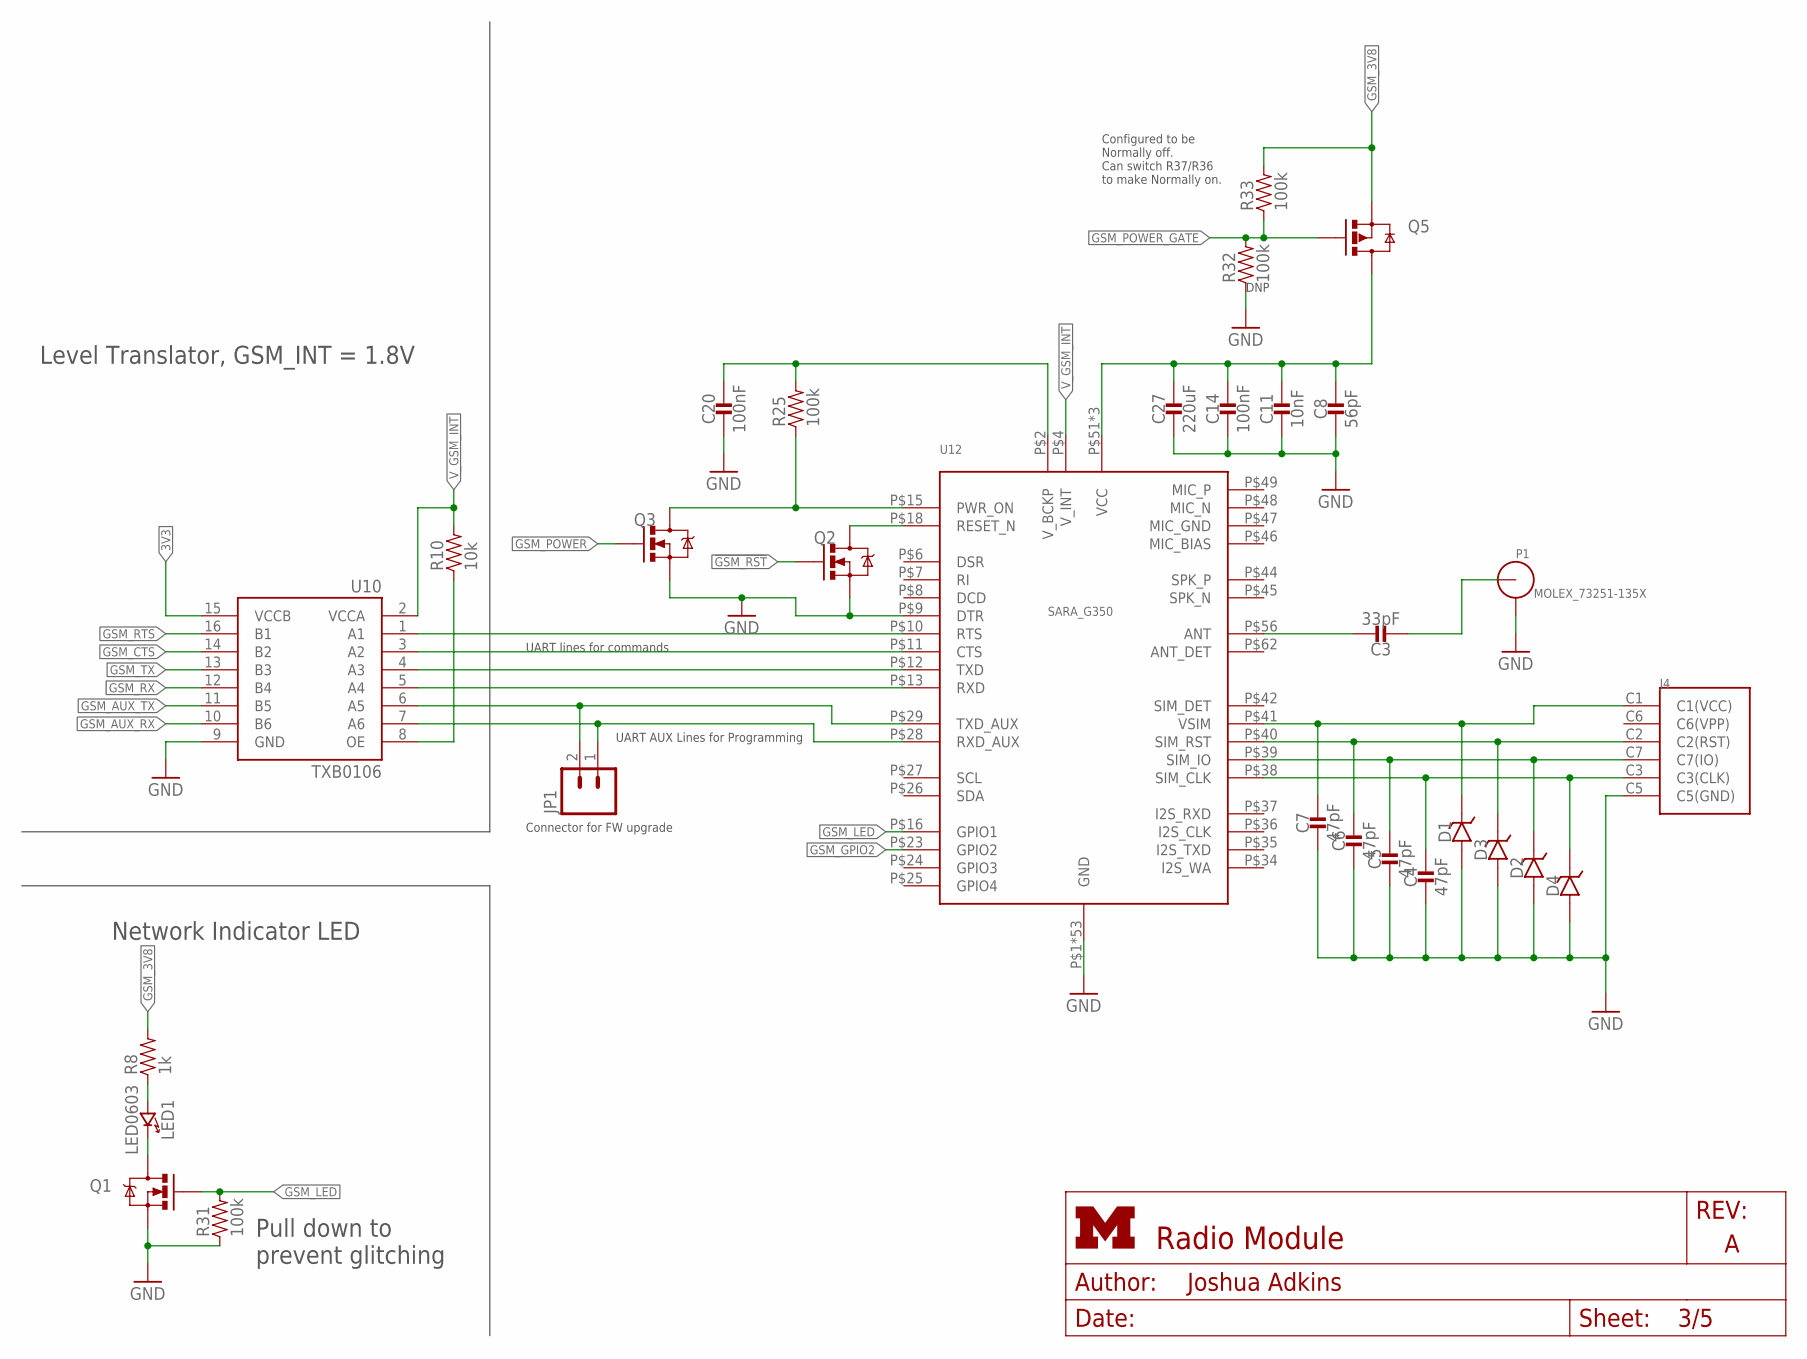
[picture p60: schematic radio_module.sch, sheet 3]

Parts:
C3: 33pF; 0603_CAP
C4, C5, C6, C7: 47pF; 0402_CAP
C8: 56pF; 0402_CAP
C11: 10nF; 0402_CAP
C14, C20: 100nF; 0402_CAP
C27: 220uF; 1210_CAP
D1: 14V; 0402_DIODE
D2, D3, D4: DIODE_ZENER; 0402_DIODE
J4: NANO_SIM; WURTH_NANO_SIM
JP1: M02PTH; 1X02
LED1: LED0603; LED-0603
P1: MOLEX_73251-135X; SMA-J/PCB
Q1, Q2, Q3: MOSFET-NCHANNELXFDN-3; XFDFN-3
Q5: SI223DDS; SOT23-3
R8: 1k; 0402_RES
R10: 10k; 0402_RES
R25, R31, R32, R33: 100k; 0402_RES
U10: TXB0106; R-PVQFN-N16
U12: UBLOX_SARA_G350; UBLOX_SARA_G3

Connections:
3V3: U10.15 (VCCB); also elsewhere on the board
!GSM_RST: Q2.G; also elsewhere on the board
GND: C4.2, C5.2, C6.2, C7.2, C8.2, C11.2, C14.2, C20.2, C27.2, D1.ANODE, D2.ANODE, D3.ANODE, D4.ANODE, J4.C5 (C5(GND)), P1.2, P1.3, P1.4, P1.5, Q1.S, Q2.S, Q3.S, R31.1, R32.1, U10.9 (GND), U12.P65 (GND), U12.P66 (GND), U12.P67 (GND), U12.P68 (GND), U12.P69 (GND), U12.P70 (GND), U12.P71 (GND), U12.P72 (GND), U12.P73 (GND), U12.P74 (GND), U12.P75 (GND), U12.P76 (GND), U12.P77 (GND), U12.P78 (GND), U12.P79 (GND), U12.P80 (GND), U12.P81 (GND), U12.P82 (GND), U12.P83 (GND), U12.P84 (GND), U12.P85 (GND), U12.P86 (GND), U12.P87 (GND), U12.P88 (GND), U12.P89 (GND), U12.P90 (GND), U12.P91 (GND), U12.P92 (GND), U12.P93 (GND), U12.P94 (GND), U12.P95 (GND), U12.P96 (GND), U12.P$1 (GND), U12.P$3 (GND), U12.P$5 (GND), U12.P$9 (DTR), U12.P$14 (GND), U12.P$20 (GND), U12.P$21 (GND), U12.P$22 (GND), U12.P$30 (GND), U12.P$32 (GND), U12.P$33 (GND), U12.P$43 (GND), U12.P$50 (GND), U12.P$54 (GND), U12.P$55 (GND), U12.P$57 (GND), U12.P$58 (GND), U12.P$59 (GND), U12.P$60 (GND), U12.P$61 (GND), U12.P$63 (GND), U12.P$64 (GND); also elsewhere on the board
GSM_3V8: Q5.2 (S), R8.2, R33.2; also elsewhere on the board
GSM_AUX_RX: U10.10 (B6); also elsewhere on the board
GSM_AUX_TX: U10.11 (B5); also elsewhere on the board
GSM_CTS: U10.14 (B2); also elsewhere on the board
GSM_GATED: C8.1, C11.1, C14.1, C27.1, Q5.3 (D), U12.P$51 (VCC), U12.P$52 (VCC), U12.P$53 (VCC)
GSM_GPIO2: U12.P$23 (GPIO2); also elsewhere on the board
GSM_LED: Q1.G, R31.2, U12.P$16 (GPIO1)
GSM_POWER: Q3.G; also elsewhere on the board
GSM_POWER_GATE: Q5.1 (G), R32.2, R33.1; also elsewhere on the board
GSM_RTS: U10.16 (B1); also elsewhere on the board
GSM_RX: U10.12 (B4); also elsewhere on the board
GSM_TX: U10.13 (B3); also elsewhere on the board
unnamed: C7.1, D1.CATHODE, J4.C1 (C1(VCC)), U12.P$41 (VSIM)
unnamed: C6.1, D3.CATHODE, J4.C2 (C2(RST)), U12.P$40 (SIM_RST)
unnamed: C5.1, D2.CATHODE, J4.C7 (C7(IO)), U12.P$39 (SIM_IO)
unnamed: C4.1, D4.CATHODE, J4.C3 (C3(CLK)), U12.P$38 (SIM_CLK)
unnamed: R10.1, U10.8 (OE)
unnamed: C3.1, U12.P$56 (ANT)
unnamed: C3.2, P1.1 (ANT)
unnamed: LED1.A (ANODE), R8.1
unnamed: U10.4 (A3), U12.P$12 (TXD)
unnamed: U10.5 (A4), U12.P$13 (RXD)
unnamed: LED1.C (CATHODE), Q1.D
unnamed: Q2.D, U12.P$18 (RESET_N)
unnamed: C20.1, R25.2, U12.P$2 (V_BCKP)
unnamed: Q3.D, R25.1, U12.P$15 (PWR_ON)
unnamed: JP1.2, U10.6 (A5), U12.P$29 (TXD_AUX)
unnamed: JP1.1, U10.7 (A6), U12.P$28 (RXD_AUX)
unnamed: U10.3 (A2), U12.P$11 (CTS)
unnamed: U10.1 (A1), U12.P$10 (RTS)
V_GSM_INT: R10.2, U10.2 (VCCA), U12.P$4 (V_INT)

Notes on the sheet:
Pull down to prevent glitching
Network Indicator LED
Level Translator, GSM_INT = 1.8V
UART AUX Lines for Programming
UART lines for commands
DNP
Configured to be Normally off. Can switch R37/R36 to make Normally on.
Connector for FW upgrade

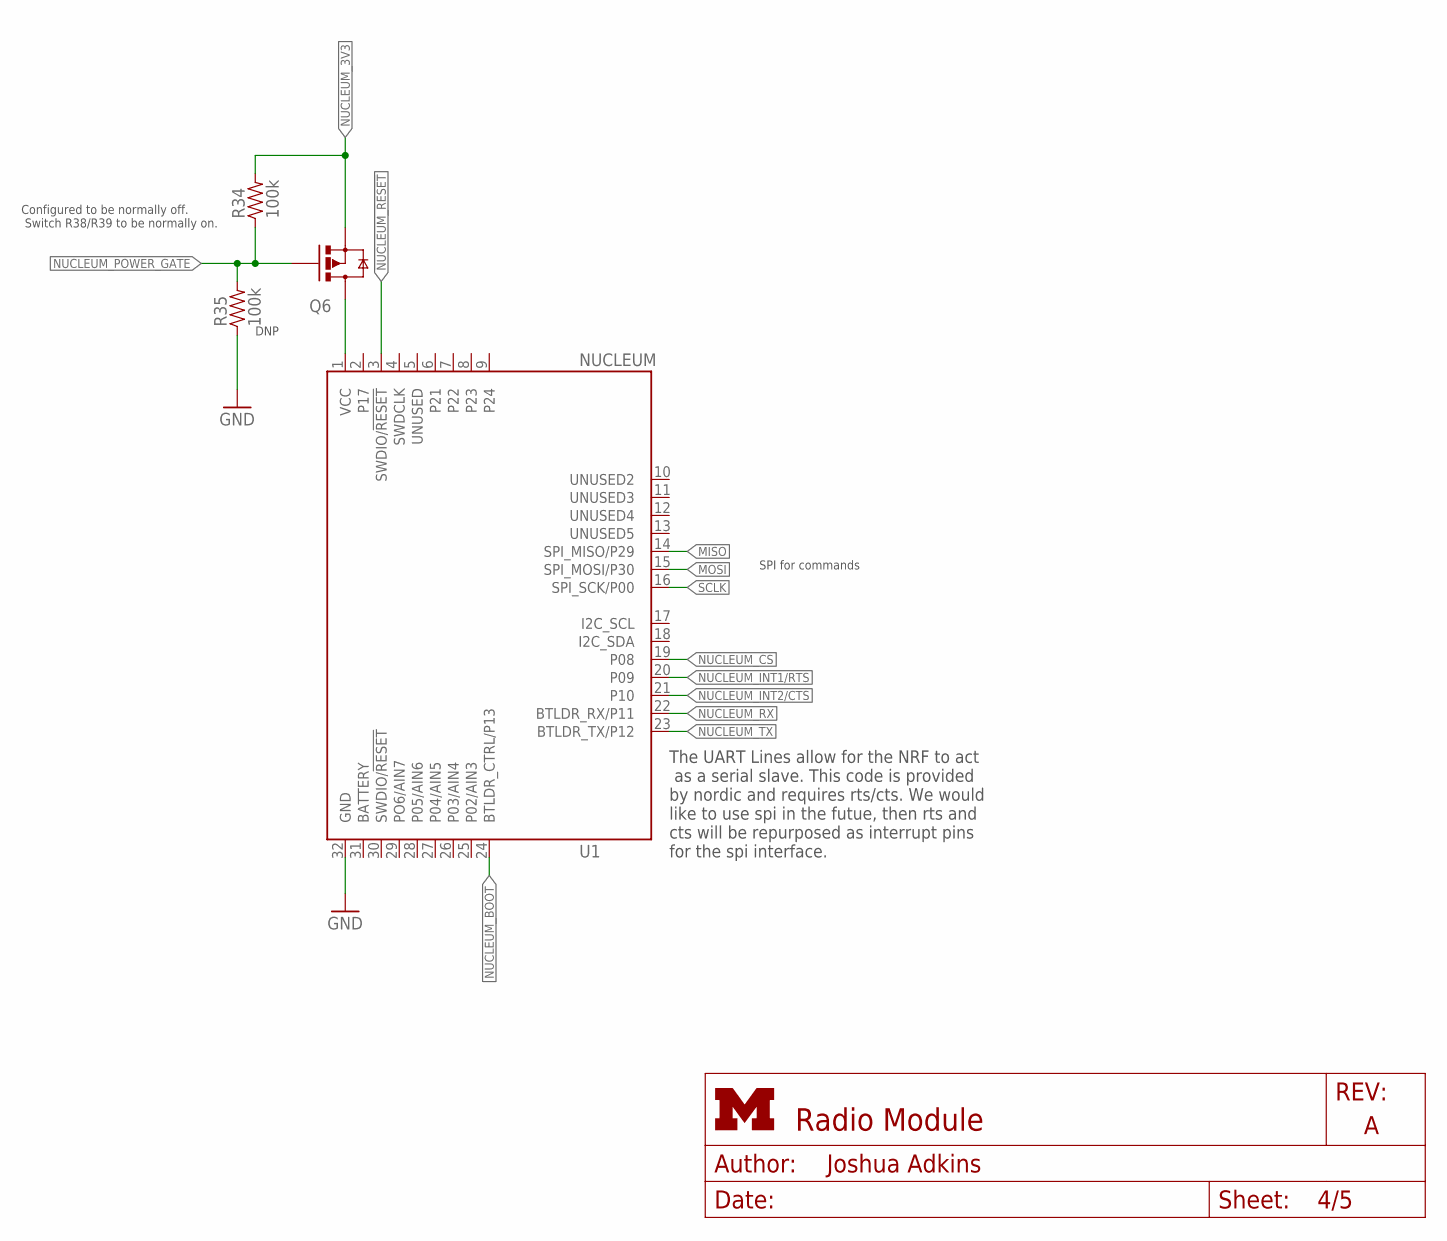
[picture p61: schematic radio_module.sch, sheet 4]

Parts:
Q6: SI223DDS; SOT23-3
R34, R35: 100k; 0402_RES
U1: NUCLEUM

Connections:
!NUCLEUM_RESET: U1.3 (SWDIO/!RESET); also elsewhere on the board
GND: R35.1, U1.32 (GND); also elsewhere on the board
MISO: U1.14 (SPI_MISO/P29); also elsewhere on the board
MOSI: U1.15 (SPI_MOSI/P30); also elsewhere on the board
unnamed: Q6.3 (D), U1.1 (VCC)
NUCLEUM_3V3: Q6.2 (S), R34.2; also elsewhere on the board
NUCLEUM_BOOT: U1.24 (BTLDR_CTRL/P13); also elsewhere on the board
NUCLEUM_CS: U1.19 (P08); also elsewhere on the board
NUCLEUM_INT1/RTS: U1.20 (P09); also elsewhere on the board
NUCLEUM_INT2/CTS: U1.21 (P10); also elsewhere on the board
NUCLEUM_POWER_GATE: Q6.1 (G), R34.1, R35.2; also elsewhere on the board
NUCLEUM_RX: U1.22 (BTLDR_RX/P11); also elsewhere on the board
NUCLEUM_TX: U1.23 (BTLDR_TX/P12); also elsewhere on the board
SCLK: U1.16 (SPI_SCK/P00); also elsewhere on the board

Notes on the sheet:
SPI for commands
DNP
Configured to be normally off. Switch R38/R39 to be normally on.
The UART Lines allow for the NRF to act as a serial slave. This code is provided by nordic and requires rts/cts. We would like to use spi in the futue, then rts and cts will be repurposed as interrupt pins for the spi interface.

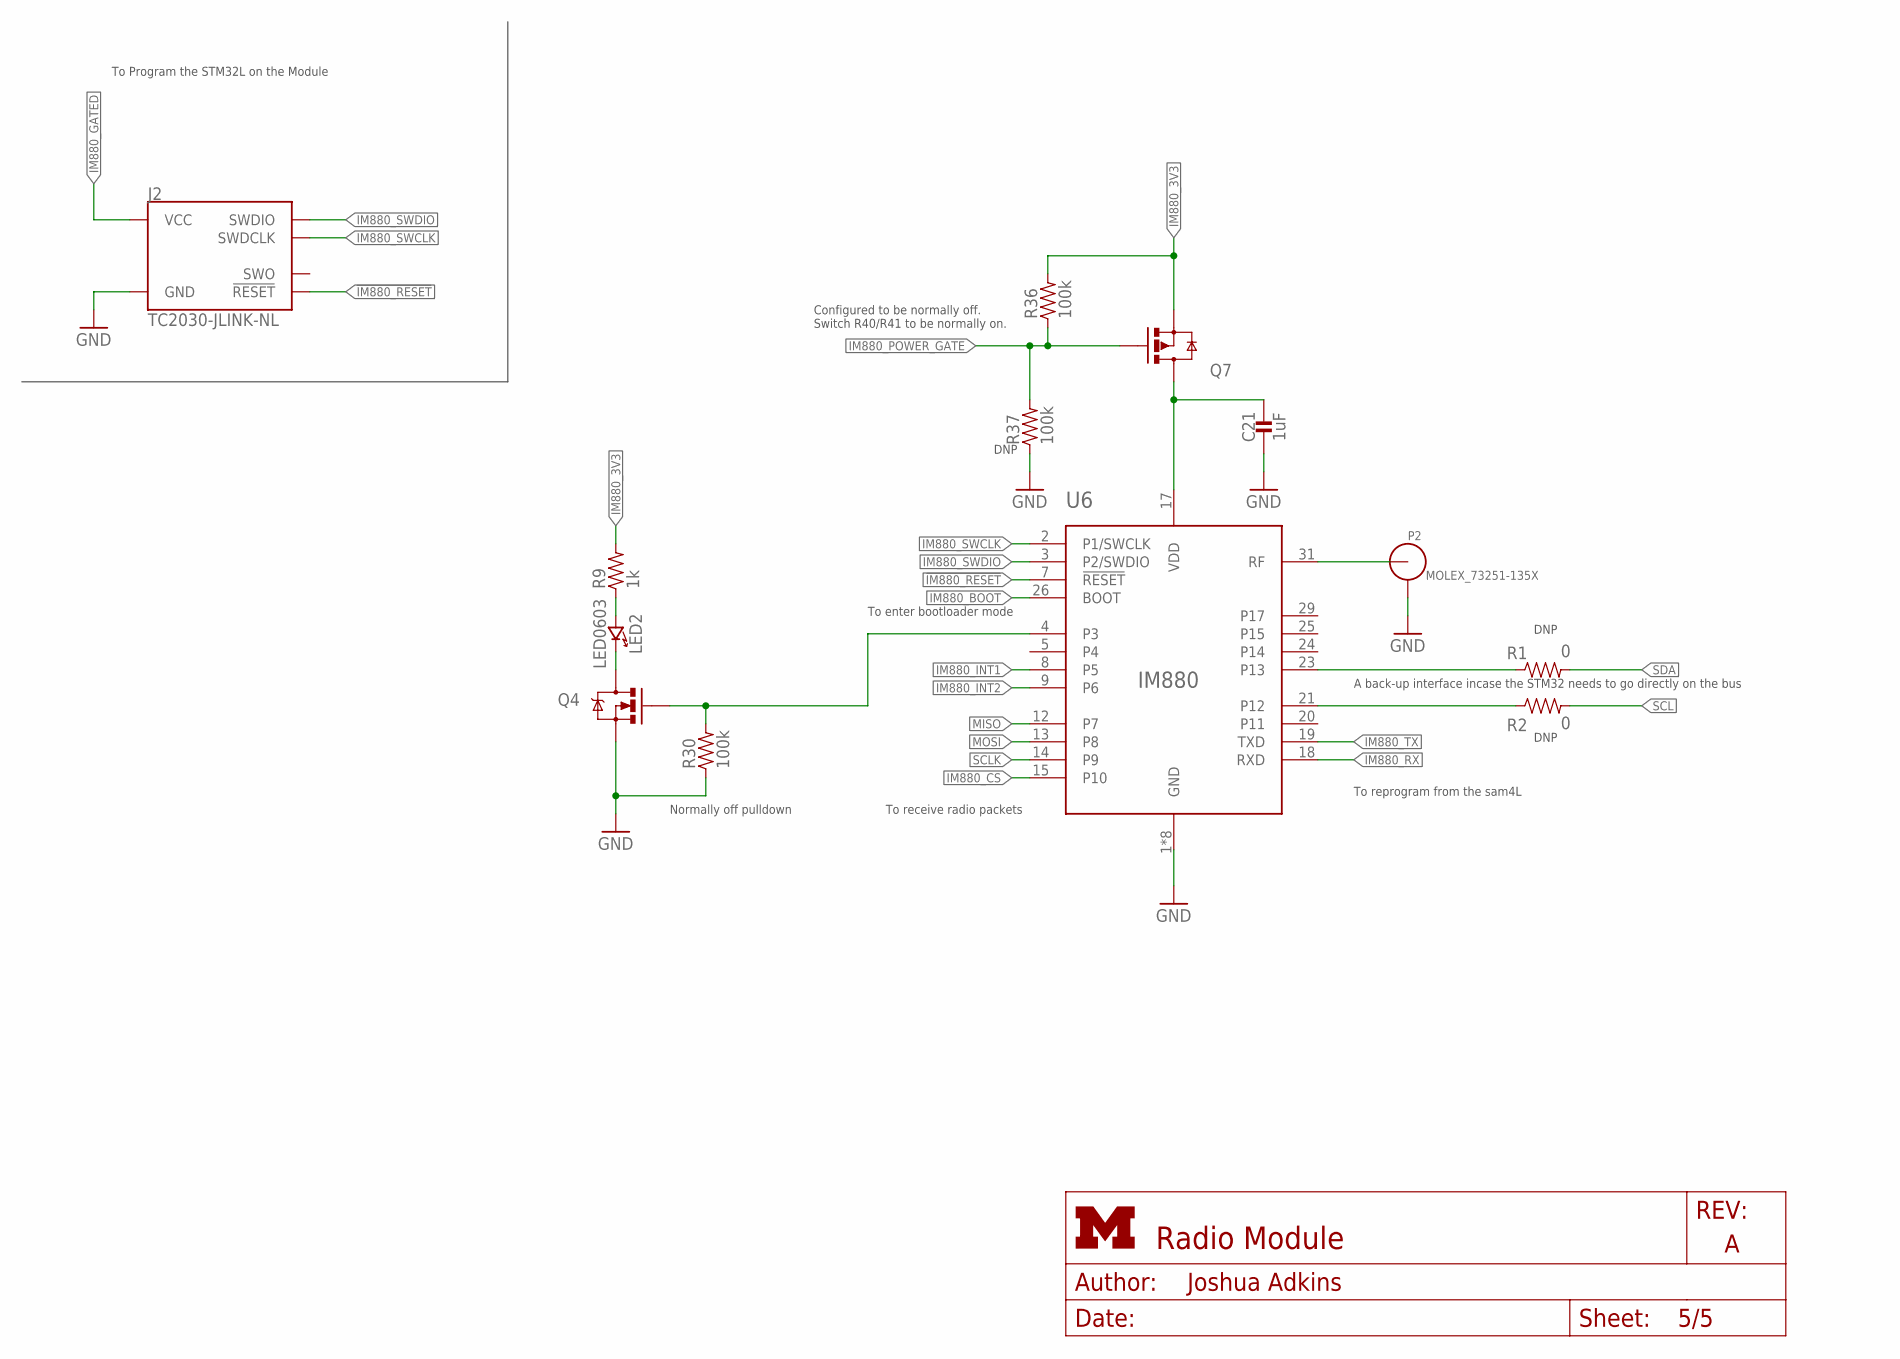
[picture p62: schematic radio_module.sch, sheet 5]

Parts:
C21: 1uF; 0402_CAP
J2: TC2030-JLINK-NL; TC2030-IDC-NL
LED2: LED0603; LED-0603
P2: MOLEX_73251-135X; SMA-J/PCB
Q4: MOSFET-NCHANNELXFDN-3; XFDFN-3
Q7: SI223DDS; SOT23-3
R1, R2: 0; 0402_RES
R9: 1k; 0402_RES
R30, R36, R37: 100k; 0402_RES
U6: IM880_MODULE

Connections:
!IM880_RESET: J2.3 (!RESET), U6.7 (!RESET); also elsewhere on the board
GND: C21.2, J2.5 (GND), P2.2, P2.3, P2.4, P2.5, Q4.S, R30.1, R37.1, U6.1 (GND), U6.6 (GND), U6.11 (GND), U6.16 (GND), U6.22 (GND), U6.27 (GND), U6.30 (GND), U6.32 (GND); also elsewhere on the board
IM880_3V3: Q7.2 (S), R9.2, R36.2; also elsewhere on the board
IM880_BOOT: U6.26 (BOOT); also elsewhere on the board
IM880_CS: U6.15 (P10); also elsewhere on the board
IM880_GATED: C21.1, J2.1 (VCC), Q7.3 (D), U6.17 (VDD)
IM880_INT1: U6.8 (P5); also elsewhere on the board
IM880_INT2: U6.9 (P6); also elsewhere on the board
IM880_NETWORK: Q4.G, R30.2, U6.4 (P3)
IM880_POWER_GATE: Q7.1 (G), R36.1, R37.2; also elsewhere on the board
IM880_RX: U6.18 (RXD); also elsewhere on the board
IM880_SWCLK: J2.4 (SWDCLK), U6.2 (P1/SWCLK)
IM880_SWDIO: J2.2 (SWDIO), U6.3 (P2/SWDIO)
IM880_TX: U6.19 (TXD); also elsewhere on the board
MISO: U6.12 (P7); also elsewhere on the board
MOSI: U6.13 (P8); also elsewhere on the board
unnamed: P2.1 (ANT), U6.31 (RF)
unnamed: R1.1, U6.23 (P13)
unnamed: R2.1, U6.21 (P12)
unnamed: LED2.A (ANODE), R9.1
unnamed: LED2.C (CATHODE), Q4.D
SCL: R2.2; also elsewhere on the board
SCLK: U6.14 (P9); also elsewhere on the board
SDA: R1.2; also elsewhere on the board

Notes on the sheet:
To Program the STM32L on the Module
To reprogram from the sam4L
To receive radio packets
A back-up interface incase the STM32 needs to go directly on the bus
To enter bootloader mode
DNP
Configured to be normally off. Switch R40/R41 to be normally on.
Normally off pulldown

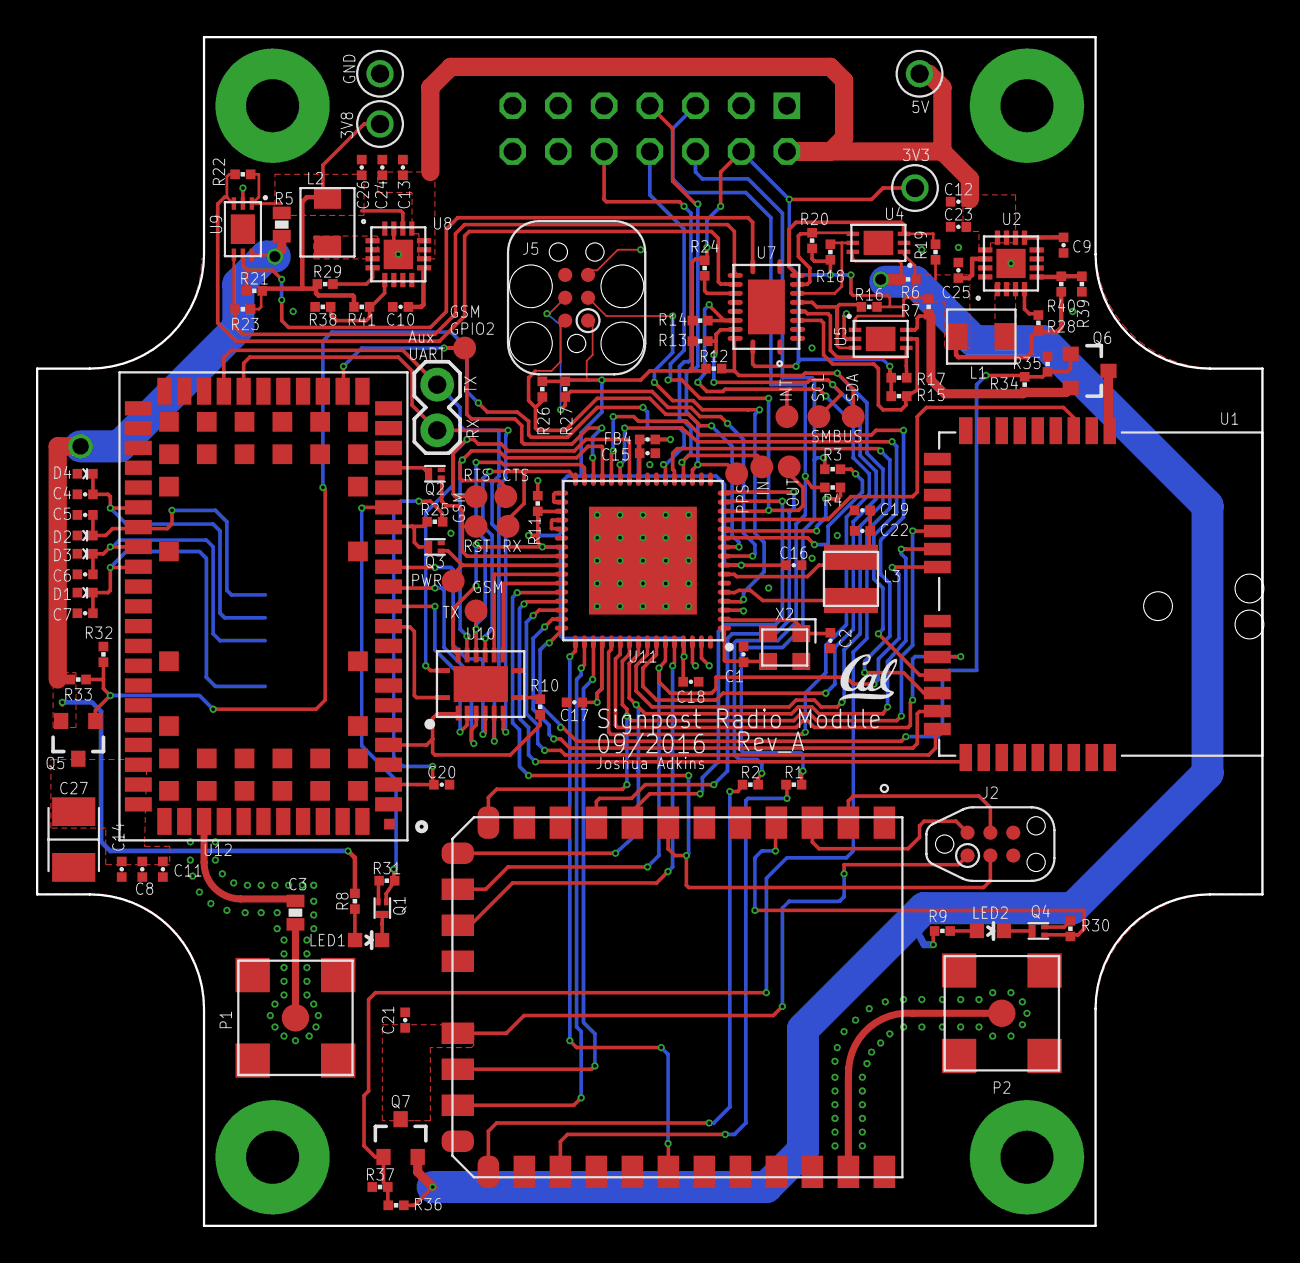
[picture p63: board hardware/radio_module/rev_a/radio_module.brd from above]

Board: 4 copper layers, 68.1 x 66.0 mm, 122 parts (1 on the bottom side), 108 nets.
