longle2718/signpost/software/apps/debug_radio_module/signpost_debug_radio_app/main.c

#include <inttypes.h>
#include <stdbool.h>
#include <stdint.h>
#include <stdio.h>
#include <stdlib.h>
#include <string.h>
#include <unistd.h>

#include <gpio.h>
#include <i2c_master_slave.h>
#include <signpost_api.h>
#include <timer.h>
#include <tock.h>

#include "app_watchdog.h"
#include "gpio_async.h"
#include "gps.h"


static uint8_t src;
static uint8_t rx_buffer[2048];

static bool message_sent = false;

static void tx_callback (
            __attribute__ ((unused)) int u1,
            __attribute__ ((unused)) int u2,
            __attribute__ ((unused)) int u3,
            __attribute__ ((unused)) void* userdata) {

    message_sent = true;
}

static bool waiting_for_response = 0;

static void rx_callback (
            int len,
            __attribute__ ((unused)) int u2,
            __attribute__ ((unused)) int u3,
            __attribute__ ((unused)) void* userdata) {

    waiting_for_response = 0;
    signpost_networking_post_reply(src, rx_buffer, len);
}

static void watchdog_timer_cb (
            __attribute__ ((unused)) int len,
            __attribute__ ((unused)) int u2,
            __attribute__ ((unused)) int u3,
            __attribute__ ((unused)) void* userdata) {

    app_watchdog_tickle_kernel();
}


static void networking_api_callback(uint8_t source_address,
    signbus_frame_type_t frame_type, __attribute__ ((unused)) signbus_api_type_t api_type,
    __attribute__ ((unused)) uint8_t message_type, size_t message_length, uint8_t* message) {


  src = source_address;

  if (frame_type == NotificationFrame || frame_type == CommandFrame) {

    if(frame_type == CommandFrame) {
        static char d[2];
        d[0] = '$';
        message_sent = false;
        allow(DRIVER_NUM_GPS, 1, (void*)d, 1);
        subscribe(DRIVER_NUM_GPS, 1, tx_callback, NULL);
        yield_for(&message_sent);


        d[0] = message_length & 0xff;
        d[1] = ((message_length & 0xff00) >> 8);
        message_sent = false;
        allow(DRIVER_NUM_GPS, 1, (void*)d, 2);
        subscribe(DRIVER_NUM_GPS, 1, tx_callback, NULL);
        yield_for(&message_sent);
    } else {
        static char d[2];
        //d[0] = '&';
        message_sent = false;
        allow(DRIVER_NUM_GPS, 1, (void*)d, 1);
        subscribe(DRIVER_NUM_GPS, 1, tx_callback, NULL);
        yield_for(&message_sent);
    }


    message_sent = false;
    allow(DRIVER_NUM_GPS, 1, (void*)message, message_length);
    subscribe(DRIVER_NUM_GPS, 1, tx_callback, NULL);

    if(frame_type == CommandFrame) {
        yield_for(&message_sent);
        waiting_for_response = 1;
        getauto((char *)rx_buffer,4096, rx_callback,NULL);
    }

  } else if (frame_type == ResponseFrame) {
    // XXX unexpected, drop
  } else if (frame_type == ErrorFrame) {
    // XXX unexpected, drop
  }
}


int main (void) {
  //printf("\n[Debug Radio]\n** Debug Backplane App\n");

  int rc;

  /////////////////////////////
  // Signpost Module Operations
  //
  // Initializations for the rest of the signpost

  // Install hooks for the signpost APIs we implement
  static api_handler_t networking_handler = {NetworkingApiType, networking_api_callback};
  static api_handler_t* handlers[] = {&networking_handler, NULL};
  delay_ms(1000);
  do {
    rc = signpost_initialization_module_init(ModuleAddressRadio, handlers);
    if (rc < 0) {
      //printf(" - %d: Error initializing the bus (code %d). Sleeping 5s.\n", __LINE__, rc);
      delay_ms(5000);
    }
  } while (rc < 0);

  static char d1[3];
  d1[0] = '#';
  d1[1] = 'r';
  allow(DRIVER_NUM_GPS, 1, (void*)d1, 2);
  subscribe(DRIVER_NUM_GPS, 1, tx_callback, NULL);
  yield_for(&message_sent);
  //printf("#r");

  ////////////////////////////////////////////////
  // Setup watchdog
  timer_subscribe(watchdog_timer_cb,NULL);
  timer_start_repeating(160);
  app_watchdog_set_kernel_timeout(500);
  app_watchdog_start();

}
