longle2718/signpost/software/kernel/signpost_drivers/src/ltc2941.rs

use kernel::common::take_cell::TakeCell;
use core::cell::Cell;
use kernel::hil::gpio;
use kernel::hil::i2c;
use kernel::{AppId, Callback, Driver};
use kernel::returncode::ReturnCode;

pub static mut BUFFER: [u8; 8] = [0; 8];

#[allow(dead_code)]
enum Registers {
    Status = 0x00,
    Control = 0x01,
    AccumulatedChargeMSB = 0x02,
    AccumulatedChargeLSB = 0x03,
    ChargeThresholdHighMSB = 0x04,
    ChargeThresholdHighLSB = 0x05,
    ChargeThresholdLowMSB = 0x06,
    ChargeThresholdLowLSB = 0x07,
}

#[derive(Clone,Copy,PartialEq)]
enum State {
    Idle,

    /// Simple read states
    ReadStatus,
    ReadCharge,
    ReadShutdown,

    Done,
}

pub enum ChipModel {
    LTC2941 = 0x01,
    LTC2942 = 0x00,
}

pub enum InterruptPinConf {
    Disabled = 0x00,
    ChargeCompleteMode = 0x01,
    AlertMode = 0x02,
}

pub enum VBatAlert {
    Off = 0x00,
    Threshold2V8 = 0x01,
    Threshold2V9 = 0x02,
    Threshold3V0 = 0x03,
}

pub trait LTC2941Client {
    fn interrupt(&self);
    fn status(&self, undervolt_lockout: bool, vbat_alert: bool, charge_alert_low: bool, charge_alert_high: bool, accumulated_charge_overflow: bool, chip: ChipModel);
    fn charge(&self, charge: u16);
    fn done(&self);
}

pub struct LTC2941<'a> {
    i2c: &'a i2c::I2CDevice,
    interrupt_pin: Option<&'a gpio::Pin>,
    state: Cell<State>,
    buffer: TakeCell<'static, [u8]>,
    client: Cell<Option<&'static LTC2941Client>>,
}

impl<'a> LTC2941<'a> {
    pub fn new(i2c: &'a i2c::I2CDevice,
               interrupt_pin: Option<&'a gpio::Pin>,
               buffer: &'static mut [u8])
               -> LTC2941<'a> {
        // setup and return struct
        LTC2941 {
            i2c: i2c,
            interrupt_pin: interrupt_pin,
            state: Cell::new(State::Idle),
            buffer: TakeCell::new(buffer),
            client: Cell::new(None),
        }
    }

    pub fn set_client<C: LTC2941Client>(&self, client: &'static C) {
        self.client.set(Some(client));

        self.interrupt_pin.map(|interrupt_pin| {
            // interrupt_pin.enable_input(gpio::InputMode::PullNone);
            interrupt_pin.make_input();
            interrupt_pin.enable_interrupt(0, gpio::InterruptMode::FallingEdge);
        });
    }

    pub fn read_status(&self) {
        self.buffer.take().map(|buffer| {
            self.i2c.enable();

            // Address pointer automatically resets to the status register.
            self.i2c.read(buffer, 1);
            self.state.set(State::ReadStatus);
        });
    }

    fn configure(&self, int_pin_conf: InterruptPinConf, prescaler: u8, vbat_alert: VBatAlert) {
        self.buffer.take().map(|buffer| {
            // Encode settings into byte
            let control = ((int_pin_conf as u8) << 1) | (prescaler << 3) | ((vbat_alert as u8) << 6);
            // Save in buffer
            buffer[1] = control;
            // Set address
            buffer[0] = Registers::Control as u8;

            self.i2c.write(buffer, 2);
            self.state.set(State::Done);
        });
    }

    /// Set the accumulated charge to 0
    fn reset_charge(&self) {
        self.buffer.take().map(|buffer| {
            self.i2c.enable();

            buffer[0] = Registers::AccumulatedChargeMSB as u8;
            buffer[1] = 0;
            buffer[2] = 0;

            self.i2c.write(buffer, 3);
            self.state.set(State::Done);
        });
    }

    fn set_high_threshold(&self, threshold: u16) {
        self.buffer.take().map(|buffer| {
            self.i2c.enable();

            buffer[0] = Registers::ChargeThresholdHighMSB as u8;
            buffer[1] = ((threshold & 0xFF00) >> 8) as u8;
            buffer[2] = (threshold & 0xFF) as u8;

            self.i2c.write(buffer, 3);
            self.state.set(State::Done);
        });
    }

    fn set_low_threshold(&self, threshold: u16) {
        self.buffer.take().map(|buffer| {
            self.i2c.enable();

            buffer[0] = Registers::ChargeThresholdLowMSB as u8;
            buffer[1] = ((threshold & 0xFF00) >> 8) as u8;
            buffer[2] = (threshold & 0xFF) as u8;

            self.i2c.write(buffer, 3);
            self.state.set(State::Done);
        });
    }

    /// Get the cumulative charge as measured by the LTC2941.
    fn get_charge(&self) {
        self.buffer.take().map(|buffer| {
            self.i2c.enable();

            // Read all of the first four registers rather than wasting
            // time writing an address.
            self.i2c.read(buffer, 4);
            self.state.set(State::ReadCharge);
        });
    }

    /// Put the LTC2941 in a low power state.
    fn shutdown(&self) {
        self.buffer.take().map(|buffer| {
            self.i2c.enable();

            // Read both the status and control register rather than
            // writing an address.
            self.i2c.read(buffer, 2);
            self.state.set(State::ReadShutdown);
        });
    }


}

impl<'a> i2c::I2CClient for LTC2941<'a> {
    fn command_complete(&self, buffer: &'static mut [u8], _error: i2c::Error) {
        match self.state.get() {
            State::ReadStatus => {
                let status = buffer[0];
                let uvlock = (status & 0x01) > 0;
                let vbata = (status & 0x02) > 0;
                let ca_low = (status & 0x04) > 0;
                let ca_high = (status & 0x08) > 0;
                let accover = (status & 0x20) > 0;
                let chip = match (status & 0x80) >> 7 {
                    1 => ChipModel::LTC2941,
                    0 => ChipModel::LTC2942,
                    _ => ChipModel::LTC2941
                };
                self.client.get().map(|client| {
                    client.status(uvlock, vbata, ca_low, ca_high, accover, chip);
                });

                self.buffer.replace(buffer);
                self.i2c.disable();
                self.state.set(State::Idle);
            },
            State::ReadCharge => {
                // TODO: Actually calculate charge!!!!!
                let charge = ((buffer[2] as u16) << 8) | (buffer[3] as u16);
                self.client.get().map(|client| {
                    client.charge(charge);
                });

                self.buffer.replace(buffer);
                self.i2c.disable();
                self.state.set(State::Idle);
            },
            State::ReadShutdown => {
                // Set the shutdown pin to 1
                buffer[1] |= 0x01;

                // Write the control register back but with a in the shutdown
                // bit.
                buffer[0] = Registers::Control as u8;
                self.i2c.write(buffer, 2);
                self.state.set(State::Done);
            },
            State::Done => {
                self.client.get().map(|client| {
                    client.done();
                });

                self.buffer.replace(buffer);
                self.i2c.disable();
                self.state.set(State::Idle);
            },
            _ => {}
        }
    }
}

impl<'a> gpio::Client for LTC2941<'a> {
    fn fired(&self, _: usize) {
        self.client.get().map(|client| {
            client.interrupt();
        });
    }
}


/// Default implementation of the LTC2941 driver that provides a Driver
/// interface for providing access to applications.
pub struct LTC2941Driver<'a> {
    ltc2941: &'a LTC2941<'a>,
    callback: Cell<Option<Callback>>,
}

impl<'a> LTC2941Driver<'a> {
    pub fn new(ltc: &'a LTC2941) -> LTC2941Driver<'a> {
        LTC2941Driver {
            ltc2941: ltc,
            callback: Cell::new(None),
        }
    }
}

impl<'a> LTC2941Client for LTC2941Driver<'a> {
    fn interrupt(&self) {
        self.callback.get().map(|mut cb| {
            cb.schedule(0, 0, 0);
        });
    }

    fn status(&self, undervolt_lockout: bool, vbat_alert: bool, charge_alert_low: bool, charge_alert_high: bool, accumulated_charge_overflow: bool, chip: ChipModel) {
        self.callback.get().map(|mut cb| {
            let ret = (undervolt_lockout as usize) | ((vbat_alert as usize) << 1) | ((charge_alert_low as usize) << 2) | ((charge_alert_high as usize) << 3) | ((accumulated_charge_overflow as usize) << 4);
            cb.schedule(1, ret, chip as usize);
        });
    }

    fn charge(&self, charge: u16) {
        self.callback.get().map(|mut cb| {
            cb.schedule(2, charge as usize, 0);
        });
    }

    fn done(&self) {
        self.callback.get().map(|mut cb| {
            cb.schedule(3, 0, 0);
        });
    }
}

impl<'a> Driver for LTC2941Driver<'a> {
    fn subscribe(&self, subscribe_num: usize, callback: Callback) -> ReturnCode {
        match subscribe_num {
            0 => {
                self.callback.set(Some(callback));
                ReturnCode::SUCCESS
            }

            // default
            _ => ReturnCode::ENOSUPPORT,
        }
    }

    fn command(&self, command_num: usize, data: usize, _: AppId) -> ReturnCode {
        match command_num {
            // get status
            0 => {
                self.ltc2941.read_status();
                ReturnCode::SUCCESS
            }

            // configure
            1 => {
                let int_pin_raw = data & 0x03;
                let prescaler = (data >> 2) & 0x07;
                let vbat_raw = (data >> 5) & 0x03;
                let int_pin_conf = match int_pin_raw {
                    0 => InterruptPinConf::Disabled,
                    1 => InterruptPinConf::ChargeCompleteMode,
                    2 => InterruptPinConf::AlertMode,
                    _ => InterruptPinConf::Disabled,
                };
                let vbat_alert = match vbat_raw {
                    0 => VBatAlert::Off,
                    1 => VBatAlert::Threshold2V8,
                    2 => VBatAlert::Threshold2V9,
                    3 => VBatAlert::Threshold3V0,
                    _ => VBatAlert::Off,
                };

                self.ltc2941.configure(int_pin_conf, prescaler as u8, vbat_alert);
                ReturnCode::SUCCESS
            }

            // reset charge
            2 => {
                self.ltc2941.reset_charge();
                ReturnCode::SUCCESS
            }

            // set high threshold
            3 => {
                self.ltc2941.set_high_threshold(data as u16);
                ReturnCode::SUCCESS
            }

            // set low threshold
            4 => {
                self.ltc2941.set_low_threshold(data as u16);
                ReturnCode::SUCCESS
            }

            // get charge
            5 => {
                self.ltc2941.get_charge();
                ReturnCode::SUCCESS
            }

            // shutdown
            6 => {
                self.ltc2941.shutdown();
                ReturnCode::SUCCESS
            }

            // default
            _ => ReturnCode::ENOSUPPORT,
        }
    }
}
