longle2718/signpost/software/kernel/signpost_drivers/src/pca9544a.rs

use kernel::common::take_cell::TakeCell;
use core::cell::Cell;
use kernel::hil::i2c;

use signpost_hil;

pub static mut BUFFER: [u8; 5] = [0; 5];

#[derive(Clone,Copy,PartialEq)]
enum State {
    Idle,

    /// Simple read to determine which interrupts are set currently
    ReadInterrupts,

    ReadSelectedChannel,

    Done,
}


pub struct PCA9544A<'a> {
    i2c: &'a i2c::I2CDevice,
    state: Cell<State>,
    buffer: TakeCell<'static, [u8]>,
    client: Cell<Option<&'static signpost_hil::i2c_selector::Client>>,
    identifier: Cell<usize>,
}

impl<'a> PCA9544A<'a> {
    pub fn new(i2c: &'a i2c::I2CDevice,
               buffer: &'static mut [u8])
               -> PCA9544A<'a> {
        // setup and return struct
        PCA9544A {
            i2c: i2c,
            state: Cell::new(State::Idle),
            buffer: TakeCell::new(buffer),
            client: Cell::new(None),
            identifier: Cell::new(0),
        }
    }

    pub fn set_client<C: signpost_hil::i2c_selector::Client>(&self, client: &'static C, identifier: usize) {
        self.client.set(Some(client));
        self.identifier.set(identifier);
    }

    /// Choose which channel(s) are active. Channels are encoded with a bitwise
    /// mask (0x01 means enable channel 0, 0x0F means enable all channels).
    /// Send 0 to disable all channels.
    fn select_channels(&self, channel_bitmask: u8) {
        self.buffer.take().map(|buffer| {
            self.i2c.enable();

            // Always clear the settings so we get to a known state
            buffer[0] = 0;

            // Iterate the bit array to send the correct channel enables
            let mut index = 1;
            for i in 0..4 {
                if channel_bitmask & (0x01 << i) != 0 {
                    // B2 B1 B0 are set starting at 0x04
                    buffer[index] = i + 4;
                    index += 1;
                }
            }

            self.i2c.write(buffer, index as u8);
            self.state.set(State::Done);
        });
    }

    fn read_interrupts(&self) {
        self.buffer.take().map(|buffer| {
            // turn on i2c to send commands
            self.i2c.enable();

            // Just issuing a read to the selector reads its control register.
            self.i2c.read(buffer, 1);
            self.state.set(State::ReadInterrupts);
        });
    }

    fn read_selected_channel(&self) {
        self.buffer.take().map(|buffer| {
            // turn on i2c to send commands
            self.i2c.enable();

            // Just issuing a read to the selector reads its control register.
            self.i2c.read(buffer, 1);
            self.state.set(State::ReadSelectedChannel);
        });
    }

    // fn enable_interrupts(&self) {
    //     self.interrupt_pin.enable_input(gpio::InputMode::PullNone);
    //     self.interrupt_pin.enable_interrupt(0, gpio::InterruptMode::FallingEdge);
    // }

    // fn disable_interrupts(&self) {
    //     self.interrupt_pin.disable_interrupt();
    //     self.interrupt_pin.disable();
    // }
}

impl<'a> i2c::I2CClient for PCA9544A<'a> {
    fn command_complete(&self, buffer: &'static mut [u8], _error: i2c::Error) {
        match self.state.get() {
            State::ReadInterrupts => {
                let interrupt_bitmask = (buffer[0] >> 4) & 0x0F;

                self.client.get().map(|client| {
                    client.done(Some(interrupt_bitmask as usize));
                });

                self.buffer.replace(buffer);
                self.i2c.disable();
                self.state.set(State::Idle);
            }
            State::ReadSelectedChannel => {
                let b = buffer[0] & 0x07;

                self.client.get().map(|client| {
                    client.done(Some(b as usize));
                });

                self.buffer.replace(buffer);
                self.i2c.disable();
                self.state.set(State::Idle);
            }
            State::Done => {
                self.client.get().map(|client| {
                    client.done(None);
                });

                self.buffer.replace(buffer);
                self.i2c.disable();
                self.state.set(State::Idle);
            },
            _ => {}
        }
    }
}

impl<'a> signpost_hil::i2c_selector::I2CSelector for PCA9544A<'a> {
    fn select_channels(&self, channels: usize) {
        self.select_channels(channels as u8);
    }

    fn disable_all_channels(&self) {
        self.select_channels(0);
    }

    fn read_interrupts(&self) {
        self.read_interrupts();
    }

    fn read_selected(&self) {
        self.read_selected_channel();
    }
}
