longle2718/signpost/(commit log)

2016-09-19 made some changes...waiting on gthan
    [radio_module.brd, radio_module.sch]
2016-09-19 one more try at this cam thing
    [radio_module.brd]
2016-10-03 Add configuration for interrupt on P2
2016-10-03 Get rid of pca driver Still need to change i2c_selector
2016-10-03 Add support in i2c_selector and pca9544a drivers to query for interrupts
2017-01-15 Added rng driver
2017-02-24 disable printing in api stack, debug radio app
